joezen777/physicssculptures/experiments/roofvent_multiplier/output/gear_detail.png

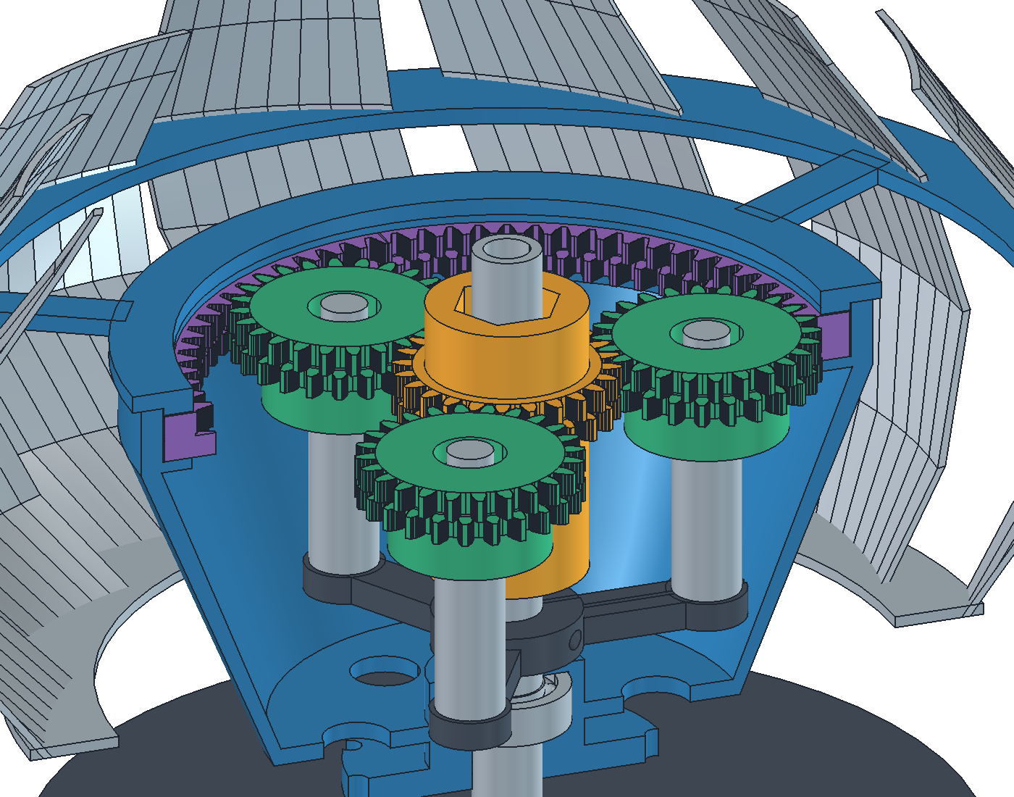
experiments/roofvent_multiplier/output/gear_detail.png
