joezen777/physicssculptures/experiments/drop_gearbox/magnetic_output/annotated_overview.png

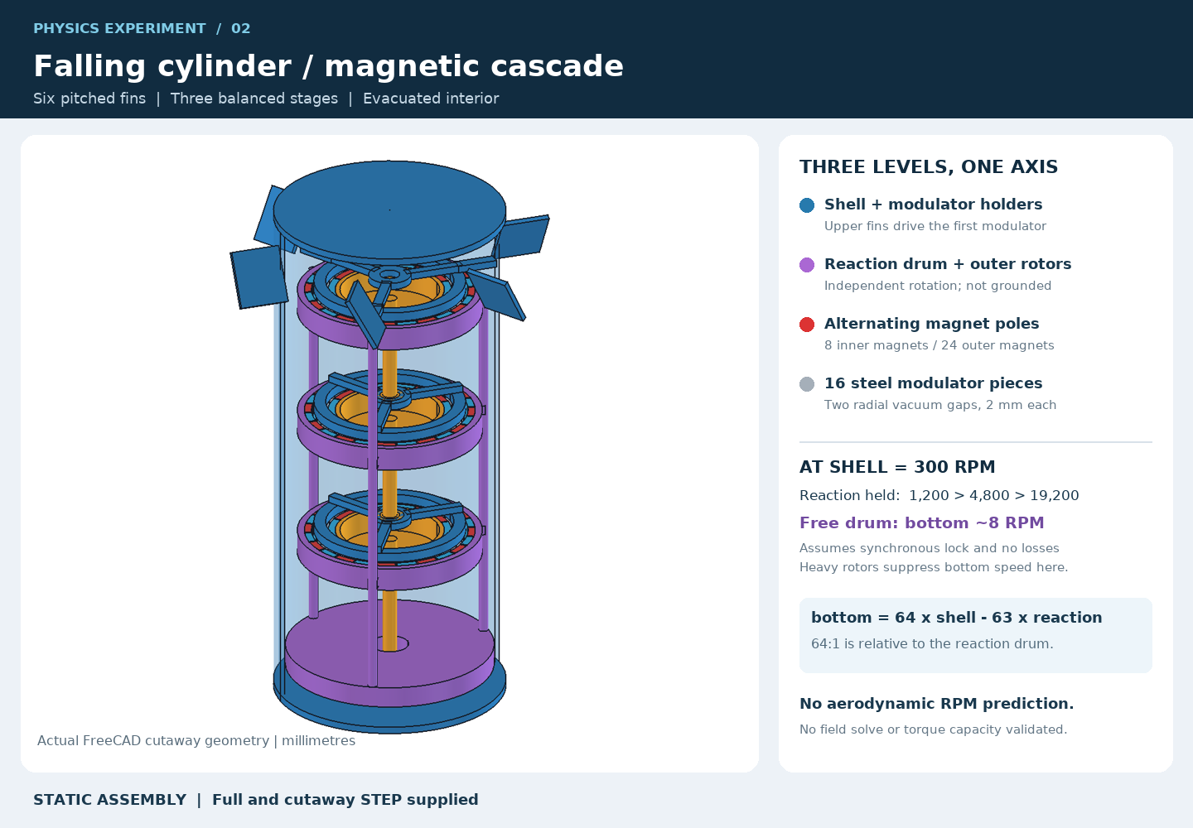
experiments/drop_gearbox/magnetic_output/annotated_overview.png
