joezen777/physicssculptures/experiments/drop_gearbox/magnetic_output/overview.png

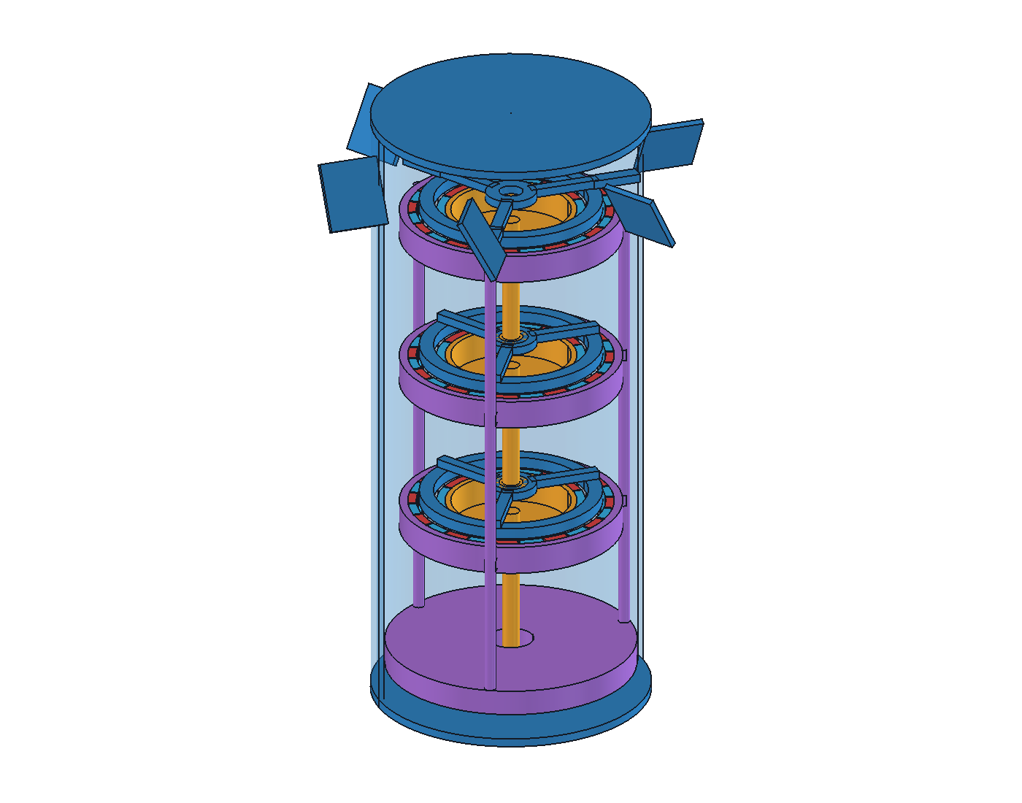
experiments/drop_gearbox/magnetic_output/overview.png
