joezen777/physicssculptures/experiments/print_petg_12/output/stl/resin_hardware_sprues/hardware_sprues_preview.png

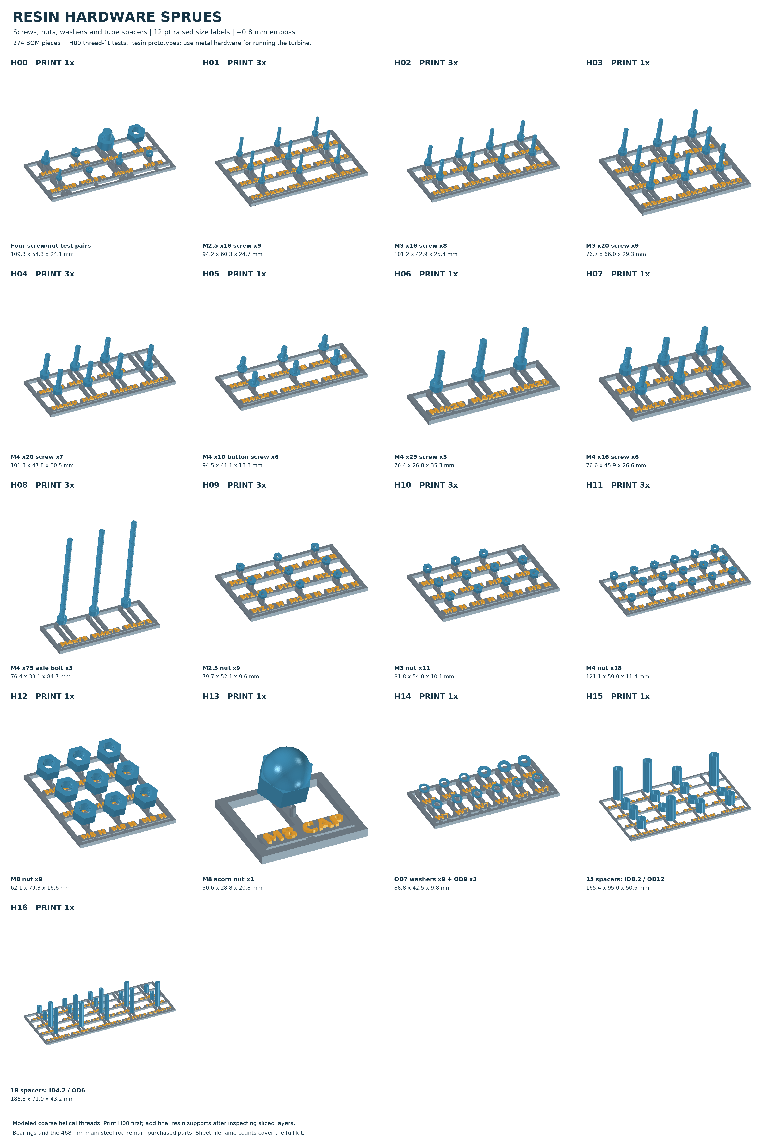
experiments/print_petg_12/output/stl/resin_hardware_sprues/hardware_sprues_preview.png
