joezen777/physicssculptures/experiments/print_petg_12/output/stl/resin_hardware_sprues/spacers_detail.png

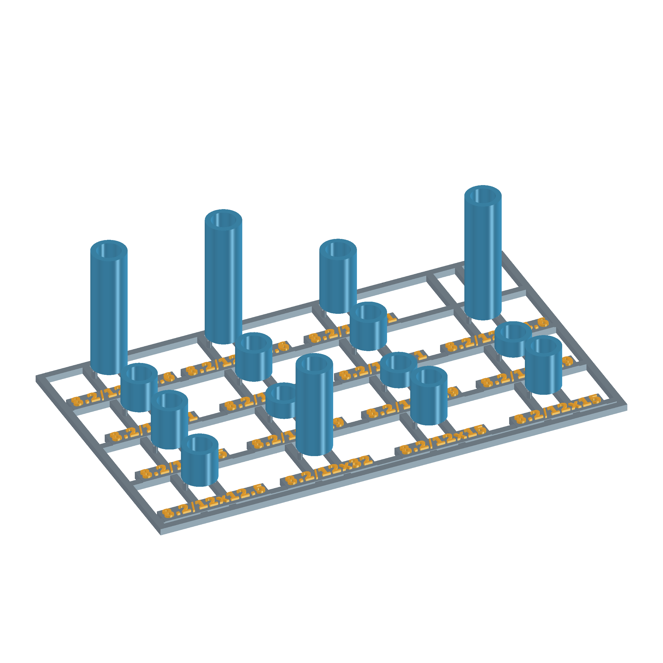
experiments/print_petg_12/output/stl/resin_hardware_sprues/spacers_detail.png
