joezen777/physicssculptures/experiments/resin_hardware_sprues/previews/H00.png

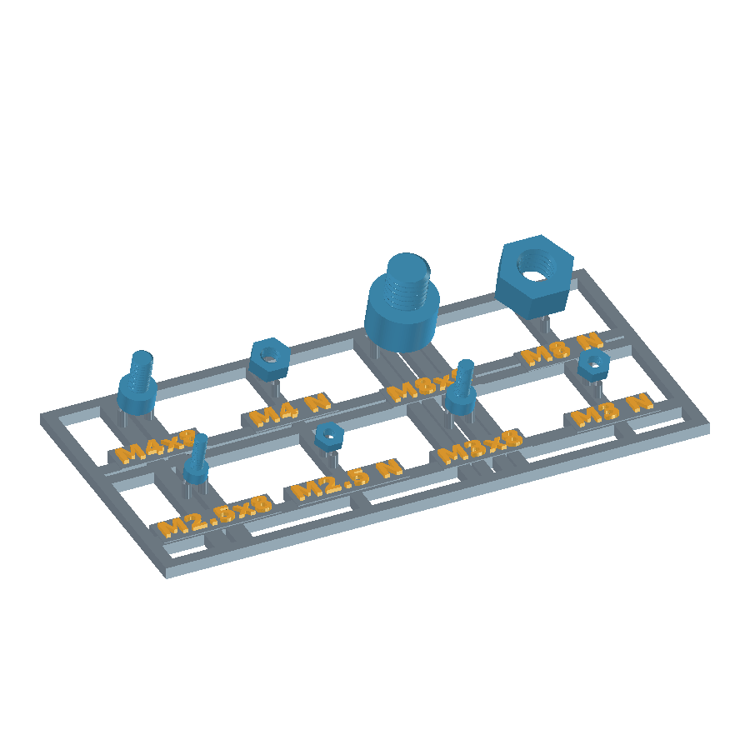
experiments/resin_hardware_sprues/previews/H00.png
