joezen777/physicssculptures/experiments/resin_hardware_sprues/previews/H03.png

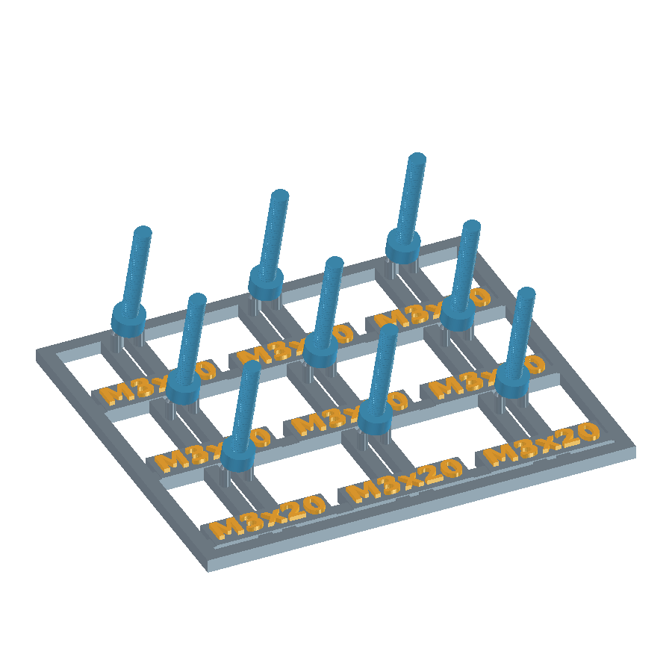
experiments/resin_hardware_sprues/previews/H03.png
