joezen777/physicssculptures/experiments/resin_hardware_sprues/previews/H04.png

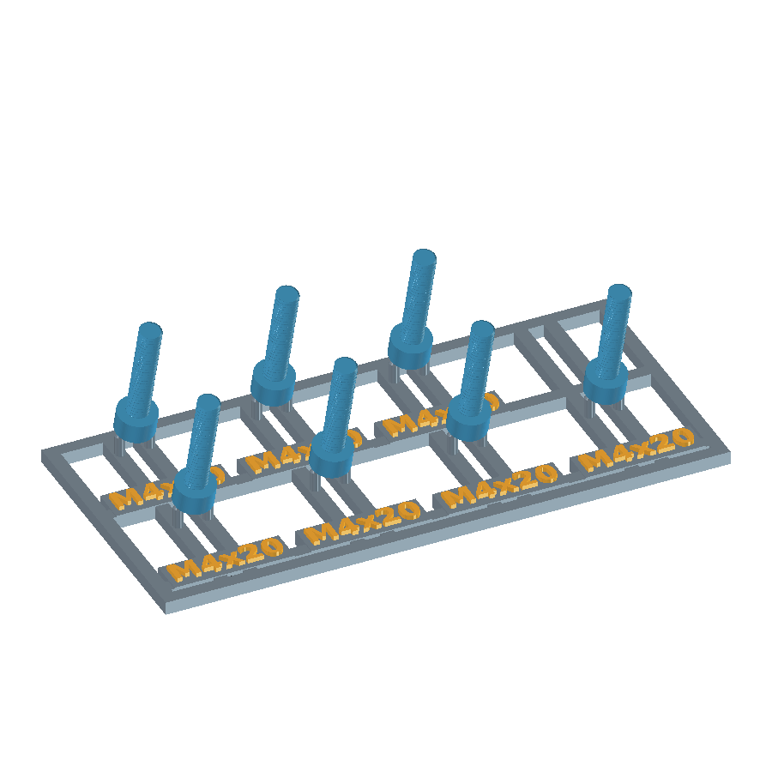
experiments/resin_hardware_sprues/previews/H04.png
