joezen777/physicssculptures/experiments/resin_hardware_sprues/previews/H05.png

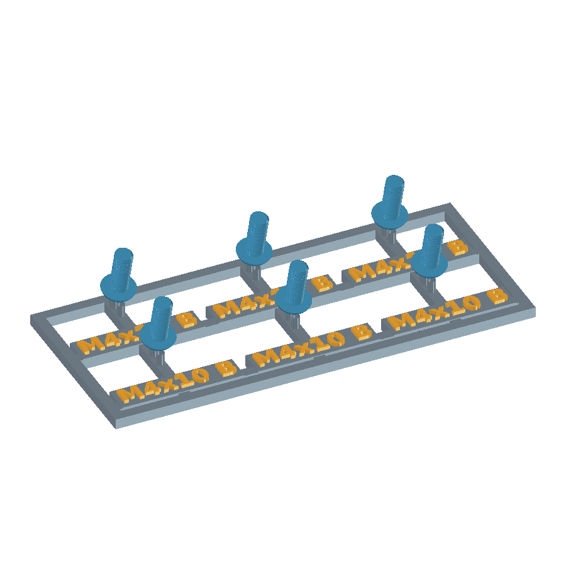
experiments/resin_hardware_sprues/previews/H05.png
