joezen777/physicssculptures/experiments/resin_hardware_sprues/previews/H06.png

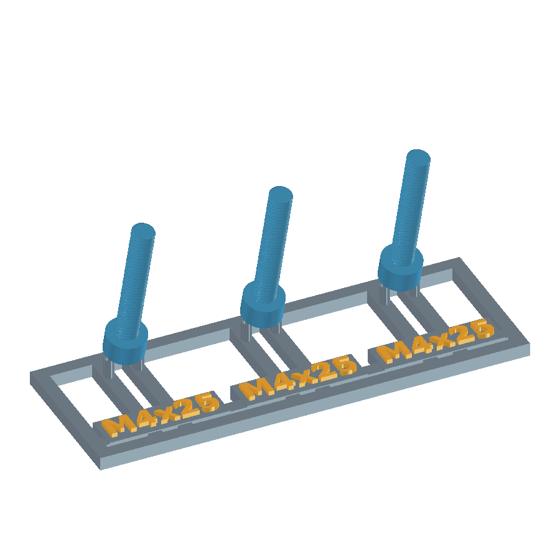
experiments/resin_hardware_sprues/previews/H06.png
