joezen777/physicssculptures/experiments/resin_hardware_sprues/previews/H07.png

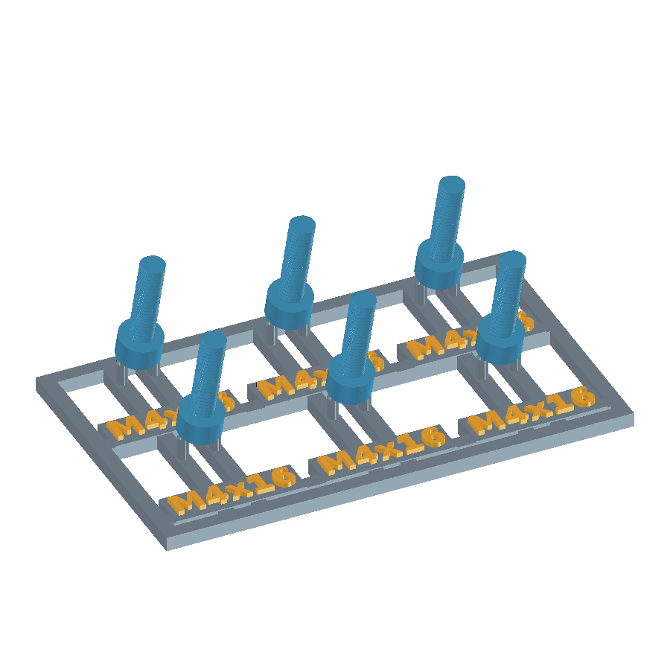
experiments/resin_hardware_sprues/previews/H07.png
