joezen777/physicssculptures/experiments/resin_hardware_sprues/previews/H08.png

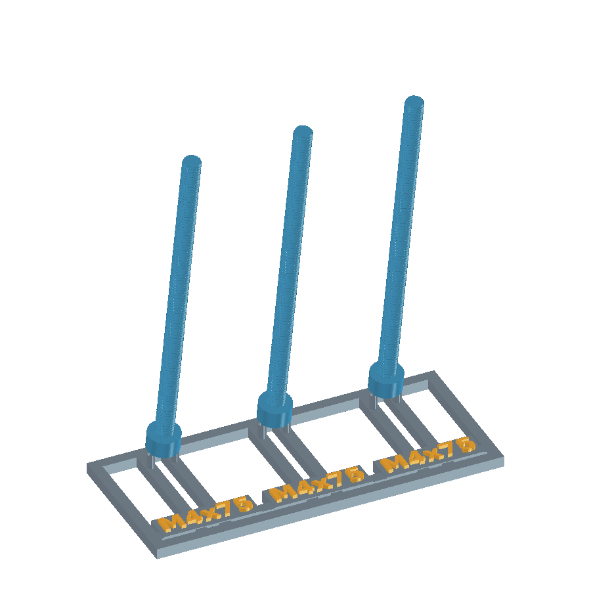
experiments/resin_hardware_sprues/previews/H08.png
