joezen777/physicssculptures/experiments/resin_hardware_sprues/previews/H09.png

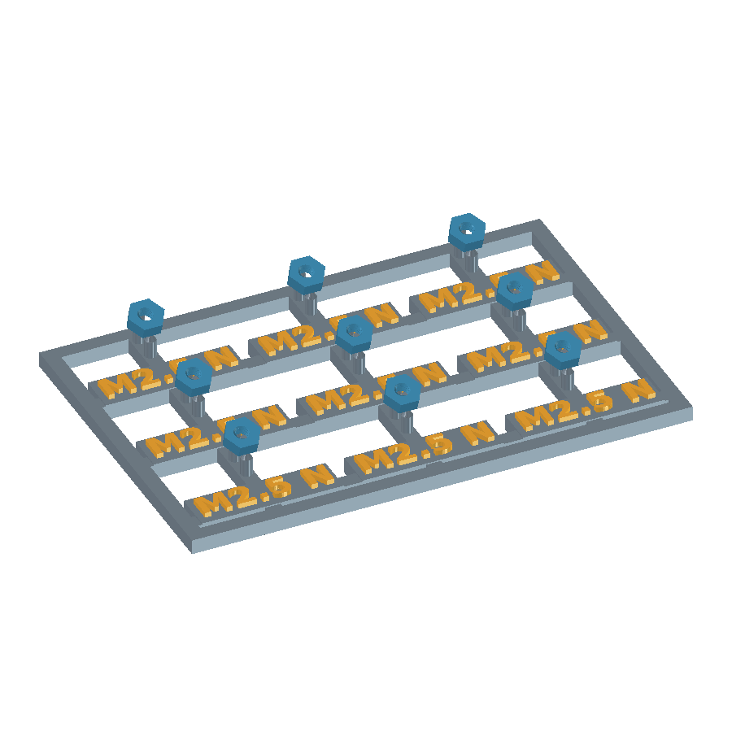
experiments/resin_hardware_sprues/previews/H09.png
