joezen777/physicssculptures/experiments/resin_hardware_sprues/previews/H10.png

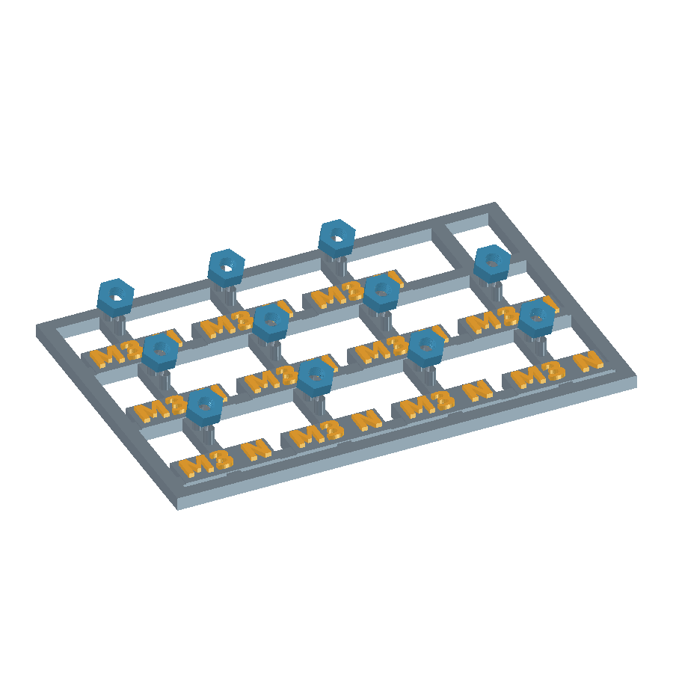
experiments/resin_hardware_sprues/previews/H10.png
