joezen777/physicssculptures/experiments/resin_hardware_sprues/previews/H11.png

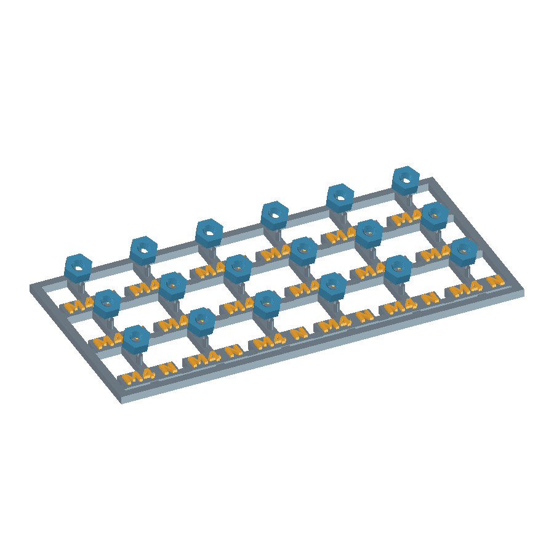
experiments/resin_hardware_sprues/previews/H11.png
