joezen777/physicssculptures/experiments/resin_hardware_sprues/previews/H12.png

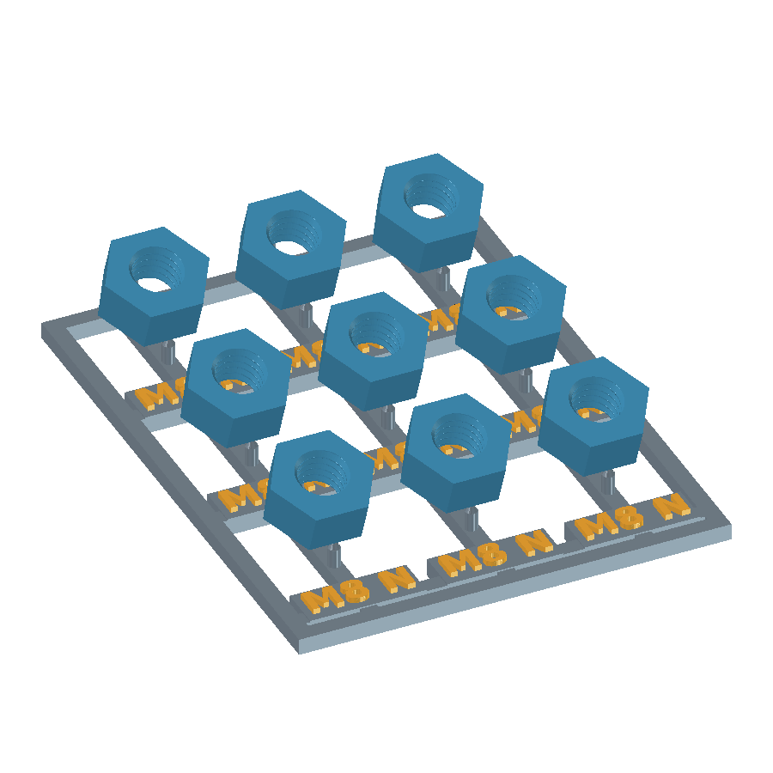
experiments/resin_hardware_sprues/previews/H12.png
