joezen777/physicssculptures/experiments/resin_hardware_sprues/previews/H13.png

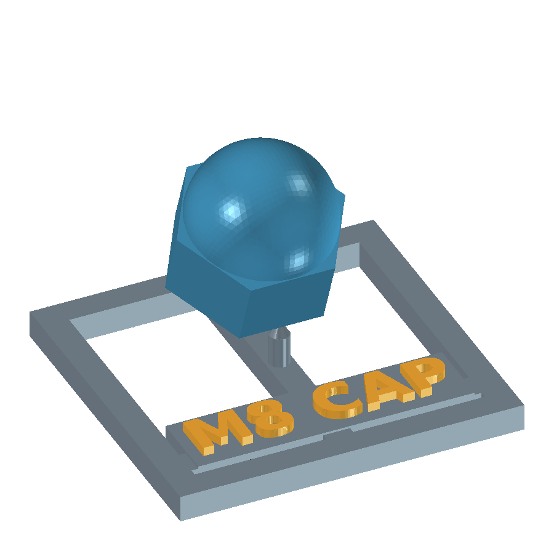
experiments/resin_hardware_sprues/previews/H13.png
