joezen777/physicssculptures/experiments/resin_hardware_sprues/previews/H14.png

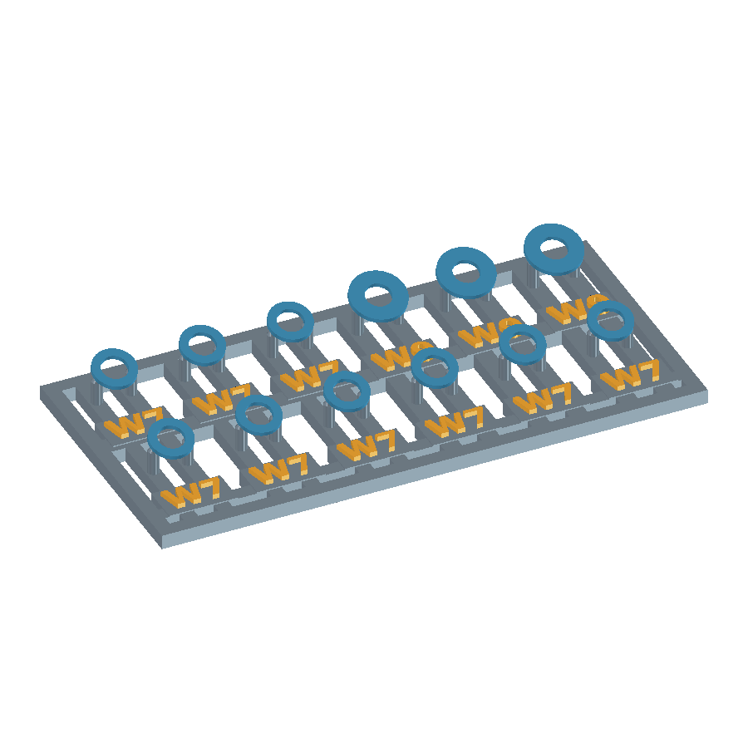
experiments/resin_hardware_sprues/previews/H14.png
