joezen777/physicssculptures/experiments/resin_hardware_sprues/previews/H16.png

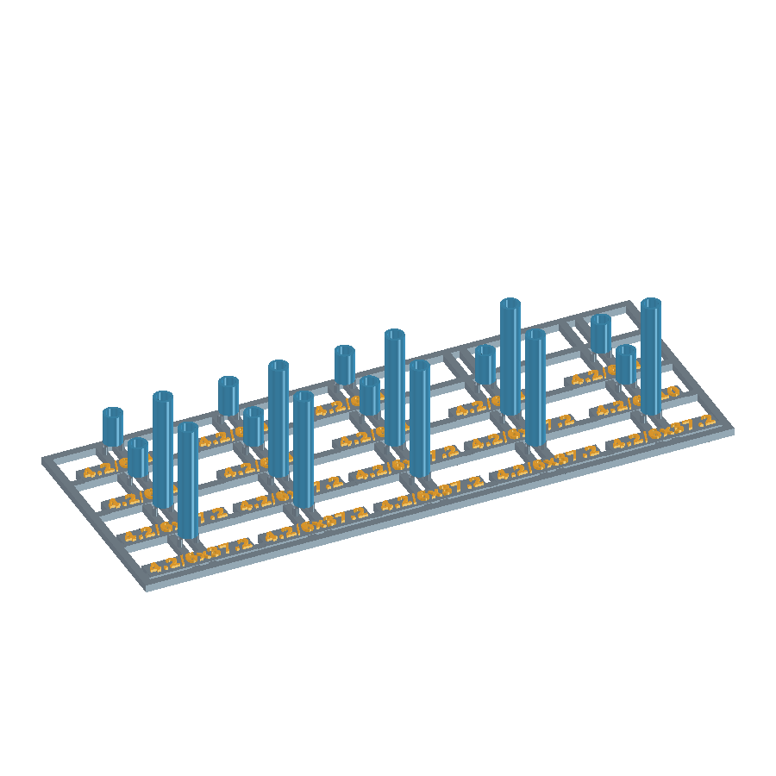
experiments/resin_hardware_sprues/previews/H16.png
