joezen777/physicssculptures/experiments/roofvent_multiplier/output/tower_overview.png

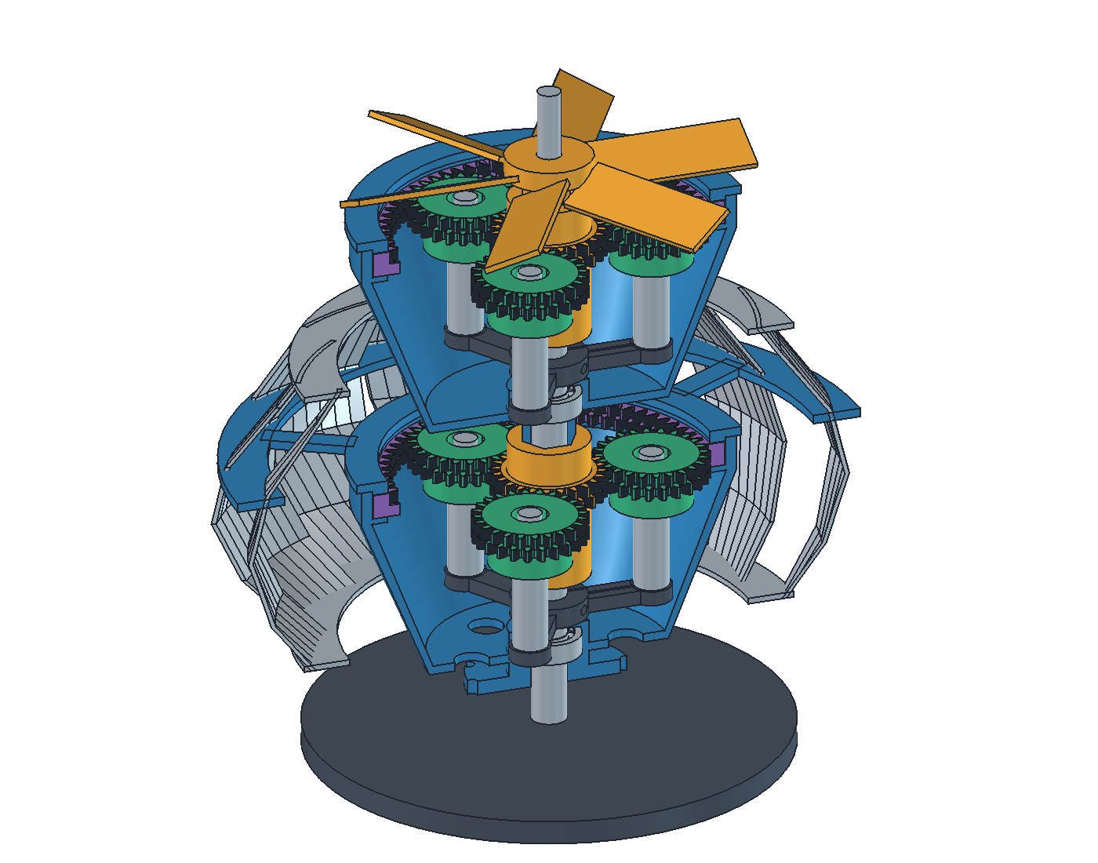
experiments/roofvent_multiplier/output/tower_overview.png
