joezen777/physicssculptures/experiments/print_petg_12/output/hardware_bom.csv

item | specification | quantity
608 bearing | 8 x 22 x 7 mm | 11
604 bearing | 4 x 12 x 4 mm | 9
M8 threaded rod | Steel; 500 mm end to end; deburr ends | 1
M8 hex nut | 13 mm AF | 9
M8 acorn nut | Check internal depth against 8 mm exposed thread | 1
M4 axle bolt | M4 x75 | 9
M3 socket-head screw | M3 x16; 608 retainers | 24
M3 socket-head screw | M3 x20; recessed sun-housing joins | 9
M3 hex nut | 5.5 mm AF | 33
M2.5 screw | M2.5 x16; 604 retainers | 27
M2.5 hex nut | 5 mm AF | 27
M4 socket-head bolt | M4 x20; ring/collar and sail hub | 21
M4 button-head screw | M4 x10; recessed arm roots; head height <=2.2 mm | 6
M4 socket-head bolt | M4 x25; cups | 3
M4 socket-head bolt | M4 x16; guard | 6
M4 hex nut | 7 mm AF; total including 18 axle nuts | 54
M4 washer | 4.2 mm ID / 7 mm OD / 0.8 mm thick; planet upper stacks | 9
M4 washer | Approx. 9 mm OD; inside cups | 3
Steel tube spacer | ID8.2 / OD12 / L12.5 mm | 1
Steel tube spacer | ID8.2 / OD12 / L32 mm | 1
Steel tube spacer | ID8.2 / OD12 / L15 mm | 3
Steel tube spacer | ID8.2 / OD12 / L5.9 mm | 3
Steel tube spacer | ID8.2 / OD12 / L11 mm | 3
Steel tube spacer | ID8.2 / OD12 / L44.6 mm | 3
Steel tube spacer | ID8.2 / OD12 / L53 mm | 1
Steel tube spacer | ID4.2 / OD6 / L37.2 mm | 9
Steel tube spacer | ID4.2 / OD6 / L10 mm | 9
