joezen777/physicssculptures/experiments/bevel_cones/output/bevel_cones_full.step

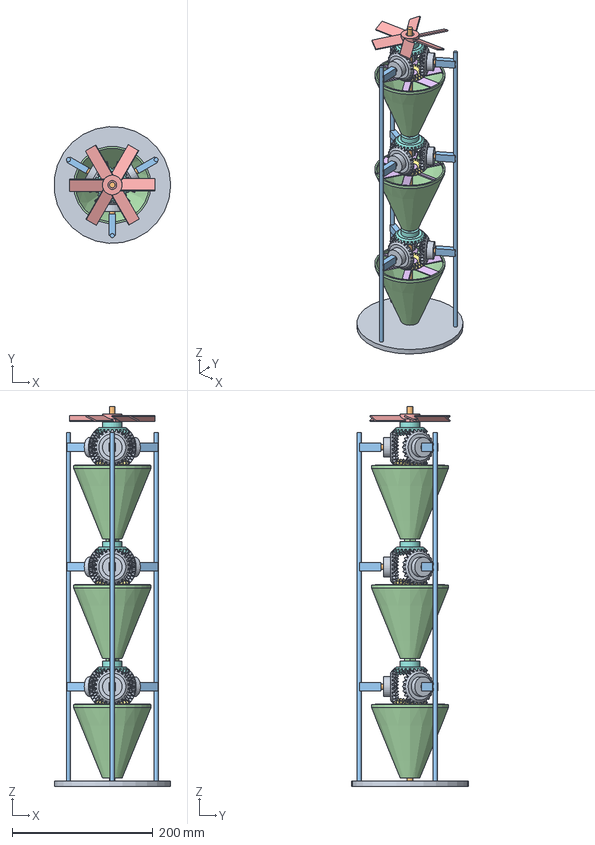
[picture p22: CAD file, 2026-09-28]
experiments/bevel_cones/output/bevel_cones_full.step
165.4 x 165.7 x 540.0 mm
Base
Central_8mm_rod
Frame_post_0
Frame_post_1
Frame_post_2
L0_pointed_cone
L0_tip_608
L0_fan_blade_insert
L0_lower_bevel
L0_upper_bevel_hex
L0_upper_608
L0_radial_pinion_0
L0_pinion_608_0
L0_radial_axle_0
L0_carrier_arm_0
L0_radial_pinion_1
L0_pinion_608_1
L0_radial_axle_1
L0_carrier_arm_1
L0_radial_pinion_2
L0_pinion_608_2
L0_radial_axle_2
L0_carrier_arm_2
L1_pointed_cone
L1_tip_608
L1_fan_blade_insert
L1_lower_bevel
L1_upper_bevel_hex
L1_upper_608
L1_radial_pinion_0
L1_pinion_608_0
L1_radial_axle_0
L1_carrier_arm_0
L1_radial_pinion_1
L1_pinion_608_1
L1_radial_axle_1
L1_carrier_arm_1
L1_radial_pinion_2
L1_pinion_608_2
L1_radial_axle_2
L1_carrier_arm_2
L2_pointed_cone
L2_tip_608
L2_fan_blade_insert
L2_lower_bevel
L2_upper_bevel_hex
L2_upper_608
L2_radial_pinion_0
L2_pinion_608_0
L2_radial_axle_0
L2_carrier_arm_0
L2_radial_pinion_1
L2_pinion_608_1
L2_radial_axle_1
L2_carrier_arm_1
L2_radial_pinion_2
L2_pinion_608_2
L2_radial_axle_2
L2_carrier_arm_2
Fan
