joezen777/physicssculptures/experiments/print_petg_12/output/arm_joint_variants/side_access_assembly.FCStd

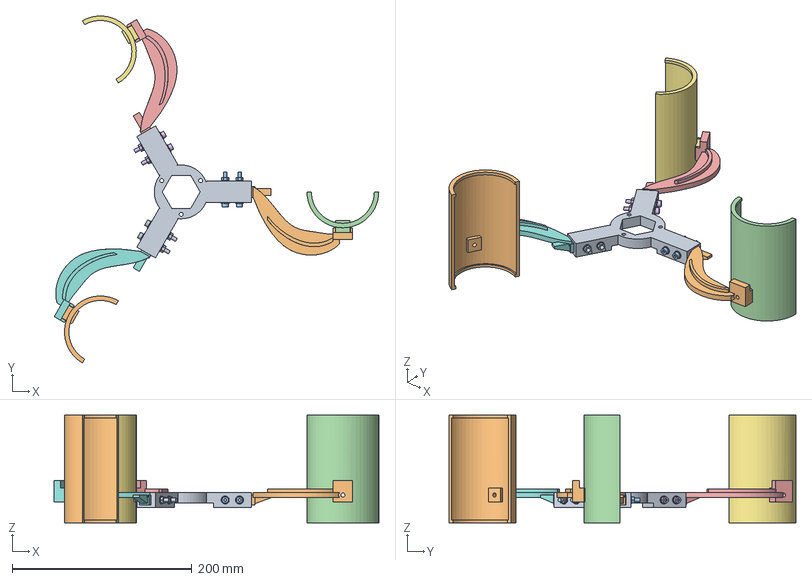
[picture p23: CAD file, 2026-10-19]
experiments/print_petg_12/output/arm_joint_variants/side_access_assembly.FCStd
361.4 x 386.4 x 120.0 mm
Hub
Arm0
Steel0
Scoop0
Arm120
Steel120
Scoop120
Arm240
Steel240
Scoop240
