joezen777/physicssculptures/experiments/print_petg_12/output/sail_80x120/assembly_with_sails.FCStd

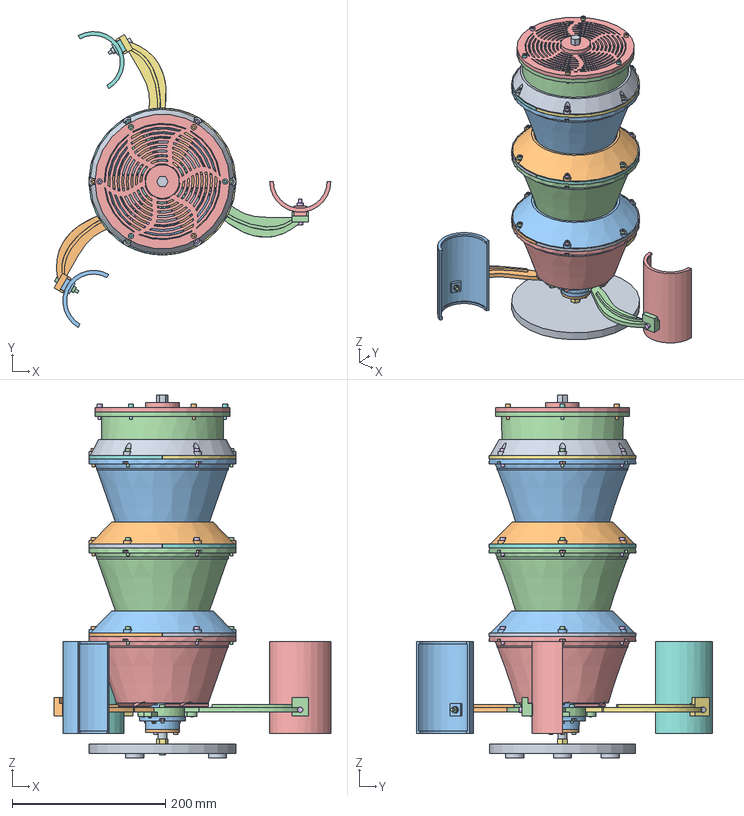
[picture p24: CAD file, 2026-10-11]
experiments/print_petg_12/output/sail_80x120/assembly_with_sails.FCStd
361.4 x 386.4 x 474.0 mm
P12 stationary_base
P01 608_retainer
P13 base_drive_adapter
P14 sail_hex_hub
P02 pot_fan_A
P01 608_retainer001
P04 fixed_curved_carrier
P01 608_retainer002
P05 sun_lower_bearing_housing
P06 sun_36T_socket
P07 planet_18T_604
P08 604_retainer
P07 planet_18T_605
P08 604_retainer001
P07 planet_18T_606
P08 604_retainer002
P09 72T_ring_half
P09 72T_ring_half001
P10 interstage_air_collar
P03 pot_fan_B
P01 608_retainer003
P04 fixed_curved_carrier001
P01 608_retainer004
P05 sun_lower_bearing_housing001
P06 sun_36T_socket001
P07 planet_18T_607
P08 604_retainer003
P07 planet_18T_608
P08 604_retainer004
P07 planet_18T_609
P08 604_retainer005
P09 72T_ring_half002
P09 72T_ring_half003
P10 interstage_air_collar001
P02 pot_fan_A001
P01 608_retainer005
P04 fixed_curved_carrier002
P01 608_retainer006
P05 sun_lower_bearing_housing002
P06 sun_36T_socket002
P07 planet_18T_610
P08 604_retainer006
P07 planet_18T_611
P08 604_retainer007
P07 planet_18T_612
P08 604_retainer008
P09 72T_ring_half004
P09 72T_ring_half005
P11 terminal_air_collar
P17 top_fan_B
P01 608_retainer007
P18 top_guard_shroud
P19 curved_guard_grille
M8 steel hex nut
M8 steel hex nut001
M8 threaded steel rod, cut 468 mm
Steel tube ID8.2 OD12 L12.5
608 purchased bearing
Steel tube ID8.2 OD12 L32
608 purchased bearing001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
