joezen777/physicssculptures/experiments/drop_gearbox/output/drop_gearbox_full.step

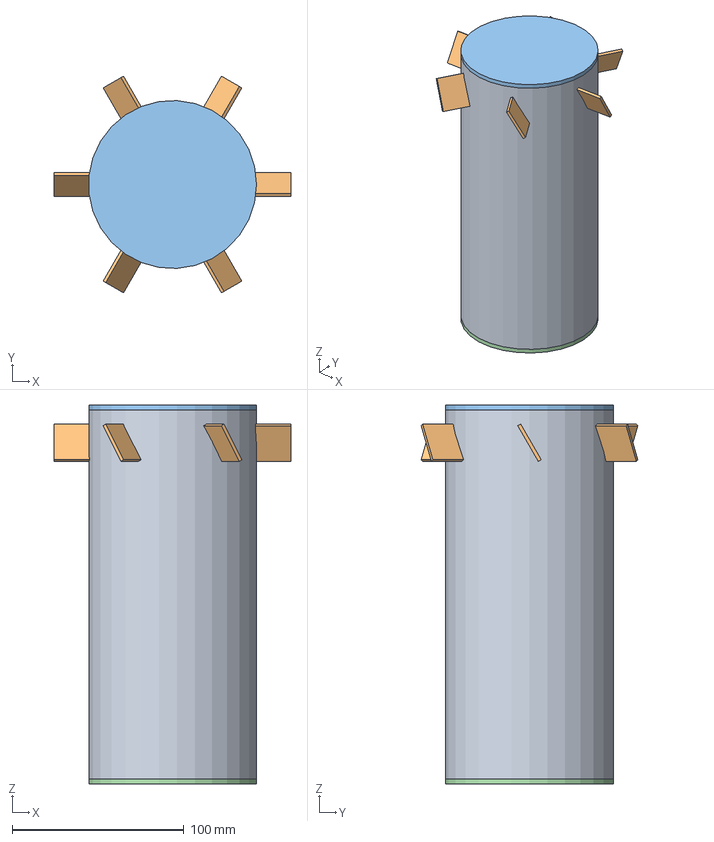
[picture p26: CAD file, 2026-09-26]
experiments/drop_gearbox/output/drop_gearbox_full.step
138.0 x 126.4 x 221.0 mm
Blue rotating shell FULL
Upper pitched fin 1
Upper pitched fin 2
Upper pitched fin 3
Upper pitched fin 4
Upper pitched fin 5
Upper pitched fin 6
Shell top cap
Shell bottom cap
Reaction flywheel
Reaction spine 1
Reaction spine 2
Reaction spine 3
Input carrier lug 0
Input carrier lug 1
Input carrier lug 2
Stage 1 ring 72T
Stage 1 ring lug 0
Stage 1 ring lug 1
Stage 1 ring lug 2
Stage 1 input carrier
Stage 1 sun 24T output
Stage 1 planet 1 24T
Stage 1 planet 2 24T
Stage 1 planet 3 24T
Stage 1 output shaft
Stage 1 coupling to next carrier
Stage 2 ring 72T
Stage 2 ring lug 0
Stage 2 ring lug 1
Stage 2 ring lug 2
Stage 2 input carrier
Stage 2 sun 24T output
Stage 2 planet 1 24T
Stage 2 planet 2 24T
Stage 2 planet 3 24T
Stage 2 output shaft
Stage 2 coupling to next carrier
Stage 3 ring 72T
Stage 3 ring lug 0
Stage 3 ring lug 1
Stage 3 ring lug 2
Stage 3 input carrier
Stage 3 sun 24T output
Stage 3 planet 1 24T
Stage 3 planet 2 24T
Stage 3 planet 3 24T
Stage 3 output shaft
Reaction journal 4
Reaction journal 20
