joezen777/physicssculptures/experiments/print_petg_12/output/exploded_assembly.FCStd

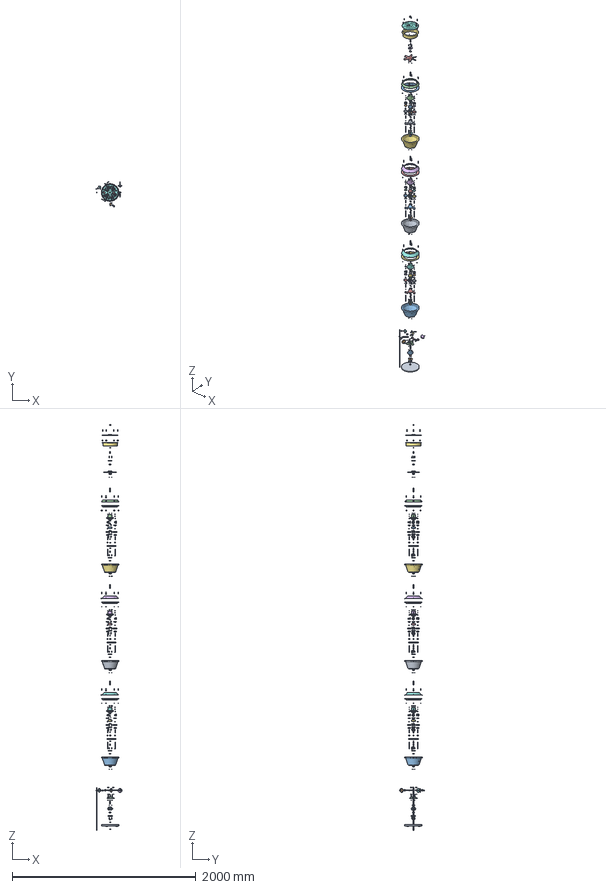
[picture p27: CAD file, 2026-10-12]
experiments/print_petg_12/output/exploded_assembly.FCStd
283.7 x 274.6 x 4419.0 mm
P12 stationary_base
P01 608_retainer
P13 base_drive_adapter
P14 sail_hex_hub
P15 curved_sail_arm
P16 wind_cup
P15 curved_sail_arm001
P16 wind_cup001
P15 curved_sail_arm002
P16 wind_cup002
P02 pot_fan_A
P01 608_retainer001
P04 fixed_curved_carrier
P01 608_retainer002
P05 sun_lower_bearing_housing
P06 sun_36T_helical_socket
P07 planet_18T_helical_604
P08 604_retainer
P07 planet_18T_helical_605
P08 604_retainer001
P07 planet_18T_helical_606
P08 604_retainer002
P09 72T_helical_ring
P10 interstage_air_collar
P03 pot_fan_B
P01 608_retainer003
P04 fixed_curved_carrier001
P01 608_retainer004
P05 sun_lower_bearing_housing001
P06 sun_36T_helical_socket001
P07 planet_18T_helical_607
P08 604_retainer003
P07 planet_18T_helical_608
P08 604_retainer004
P07 planet_18T_helical_609
P08 604_retainer005
P09 72T_helical_ring001
P10 interstage_air_collar001
P02 pot_fan_A001
P01 608_retainer005
P04 fixed_curved_carrier002
P01 608_retainer006
P05 sun_lower_bearing_housing002
P06 sun_36T_helical_socket002
P07 planet_18T_helical_610
P08 604_retainer006
P07 planet_18T_helical_611
P08 604_retainer007
P07 planet_18T_helical_612
P08 604_retainer008
P09 72T_helical_ring002
P11 terminal_air_collar
P17 top_fan_B
P01 608_retainer007
P18 top_guard_shroud
P19 curved_guard_grille
M8 steel hex nut
M8 steel hex nut001
M8 threaded steel rod, cut 468 mm
Steel tube ID8.2 OD12 L12.5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
