joezen777/physicssculptures/experiments/print_petg_12/output/arm_joint_variants/temporary_assembly.FCStd

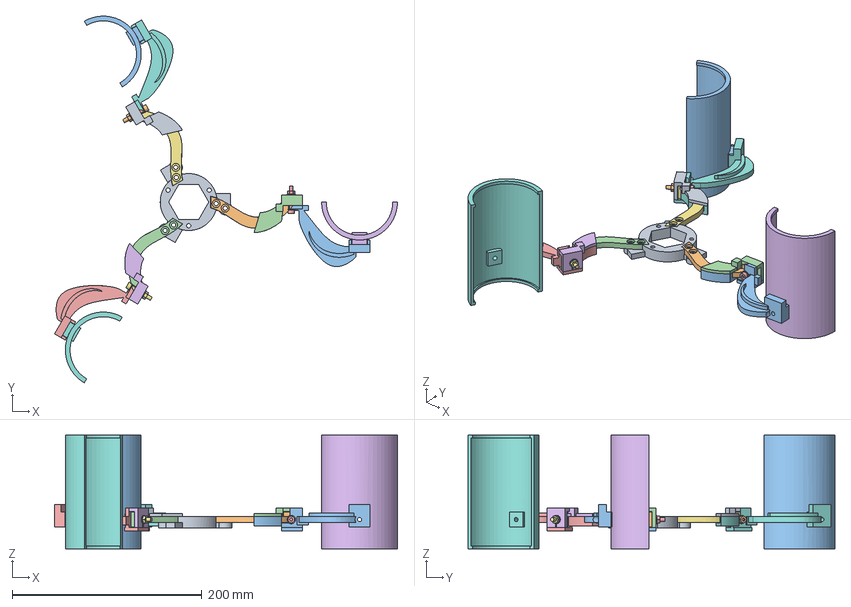
[picture p29: CAD file, 2026-10-19]
experiments/print_petg_12/output/arm_joint_variants/temporary_assembly.FCStd
361.4 x 386.4 x 120.0 mm
Hub
OriginalArm0
Extension0
Cap0
Steel0
Scoop0
OriginalArm120
Extension120
Cap120
Steel120
Scoop120
OriginalArm240
Extension240
Cap240
Steel240
Scoop240
