joezen777/physicssculptures/experiments/cfd400/geometry/original.stl

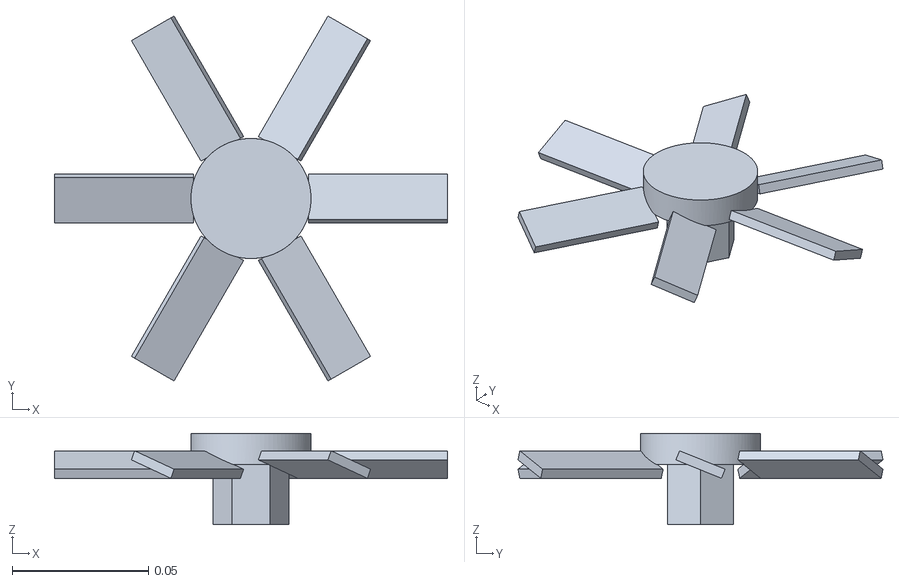
[picture p30: CAD file, 2026-10-19]
experiments/cfd400/geometry/original.stl
0.144 x 0.134 x 0.0334
