joezen777/physicssculptures/experiments/drop_gearbox/magnetic_output/magnetic.FCStd

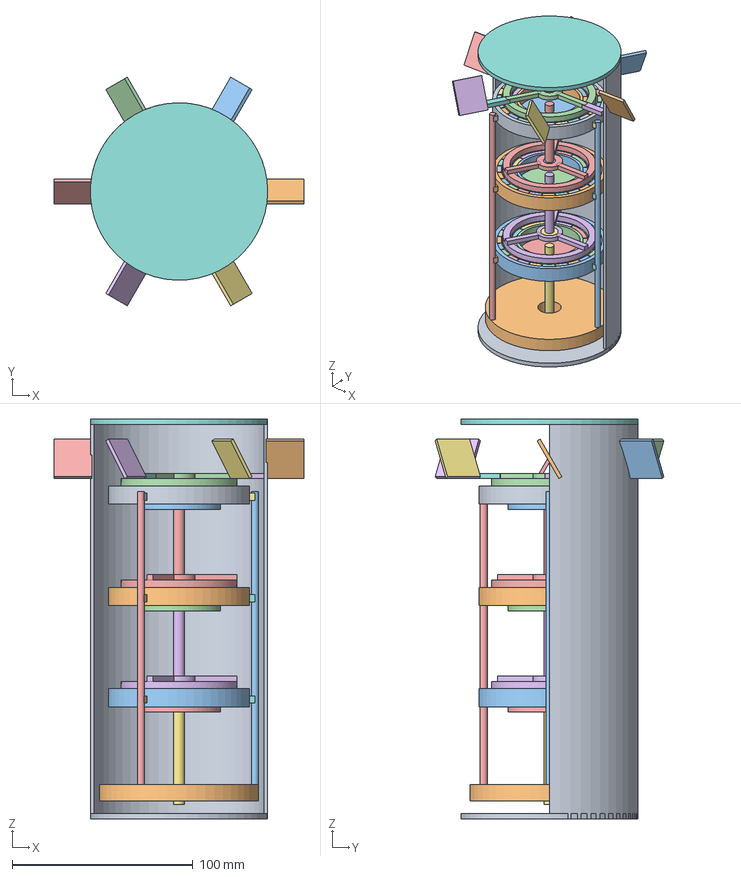
[picture p31: CAD file, 2026-09-26]
experiments/drop_gearbox/magnetic_output/magnetic.FCStd
138.0 x 126.4 x 221.0 mm
Shell front half removed for inspection
Upper pitched fin 1
Upper pitched fin 2
Upper pitched fin 3
Upper pitched fin 4
Upper pitched fin 5
Upper pitched fin 6
Shell top cap
Shell bottom cap
Reaction flywheel
Reaction spine 1
Reaction spine 2
Reaction spine 3
Input carrier lug 0
Input carrier lug 1
Input carrier lug 2
M1 outer backiron
M1 outer pole 01
M1 outer pole 02
M1 outer pole 03
M1 outer pole 04
M1 outer pole 05
M1 outer pole 06
M1 outer pole 07
M1 outer pole 08
M1 outer pole 09
M1 outer pole 10
M1 outer pole 11
M1 outer pole 12
M1 outer pole 13
M1 outer pole 14
M1 outer pole 15
M1 outer pole 16
M1 outer pole 17
M1 outer pole 18
M1 outer pole 19
M1 outer pole 20
M1 outer pole 21
M1 outer pole 22
M1 outer pole 23
M1 outer pole 24
M1 modulator 01
M1 modulator 02
M1 modulator 03
M1 modulator 04
M1 modulator 05
M1 modulator 06
M1 modulator 07
M1 modulator 08
M1 modulator 09
M1 modulator 10
M1 modulator 11
M1 modulator 12
M1 modulator 13
M1 modulator 14
M1 modulator 15
M1 modulator 16
M1 inner pole 01
M1 inner pole 02
M1 inner pole 03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
