joezen777/physicssculptures/experiments/pot_zoetrope/output/engraved_pots_detail.FCStd

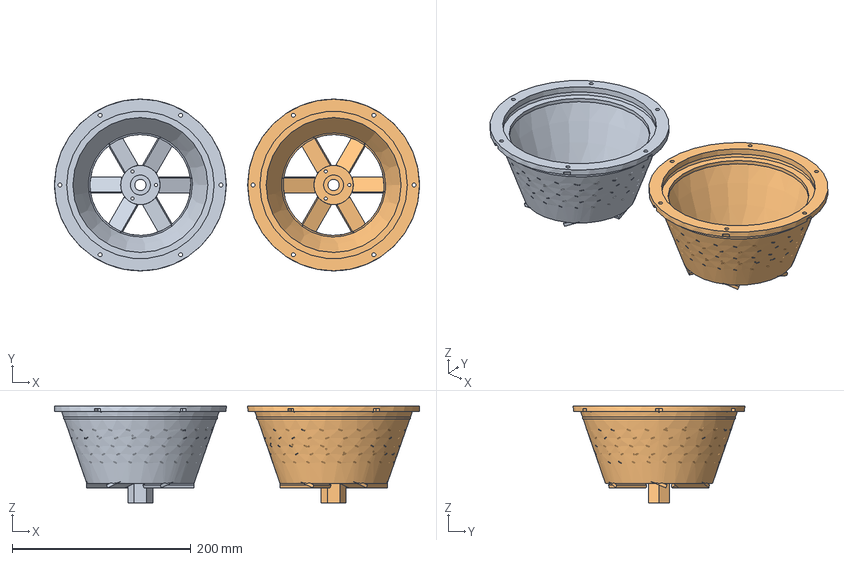
[picture p33: CAD file, 2026-10-03]
experiments/pot_zoetrope/output/engraved_pots_detail.FCStd
408.0 x 192.0 x 108.4 mm
P02 recessed CCW
P03 recessed CW
