joezen777/physicssculptures/experiments/print_petg_12/output/p19_rain/P19_rain.step

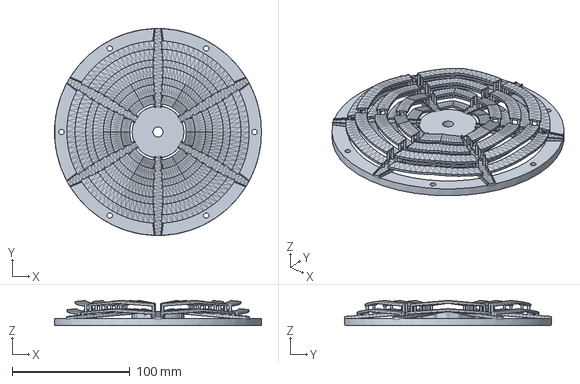
[picture p34: CAD file, 2026-10-19]
experiments/print_petg_12/output/p19_rain/P19_rain.step
176.0 x 176.0 x 21.4 mm
