joezen777/physicssculptures/experiments/print_petg_12/output/scimitar_40mm/P18S.step

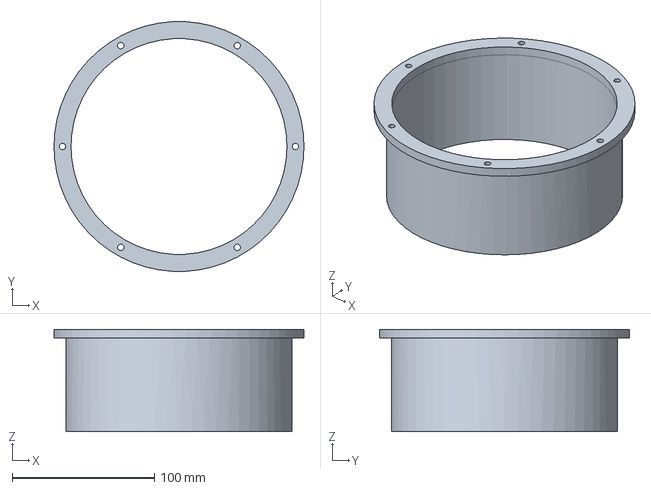
[picture p35: CAD file, 2026-10-19]
experiments/print_petg_12/output/scimitar_40mm/P18S.step
176.0 x 175.7 x 72.0 mm
