joezen777/physicssculptures/experiments/resin_hardware_sprues/hardware_sprues.FCStd

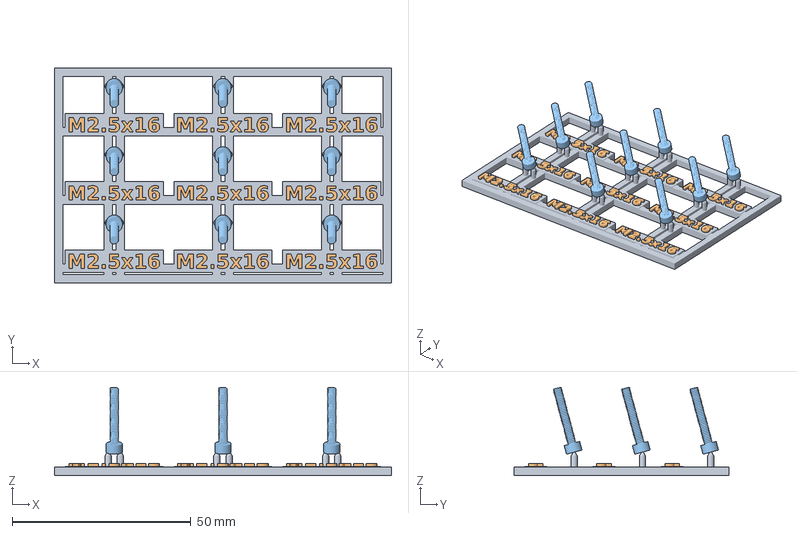
[picture p37: CAD file, 2026-10-03]
experiments/resin_hardware_sprues/hardware_sprues.FCStd
94.2 x 60.3 x 24.7 mm
H01 frame | print 3x
H01 labels | print 3x
H01 parts | print 3x
