joezen777/physicssculptures/experiments/resin_sprues/resin_sprue_sheets.FCStd

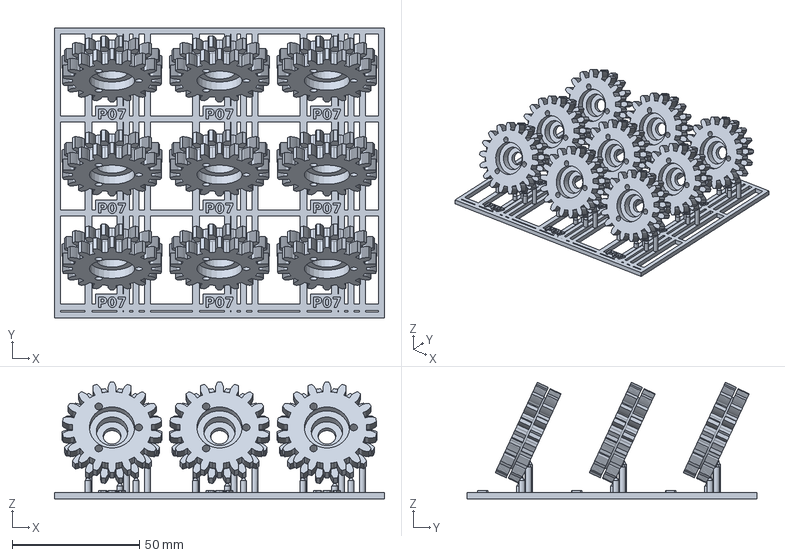
[picture p38: CAD file, 2026-10-03]
experiments/resin_sprues/resin_sprue_sheets.FCStd
129.5 x 113.7 x 45.7 mm
