joezen777/physicssculptures/experiments/cfd400/geometry/toroidal5.FCStd

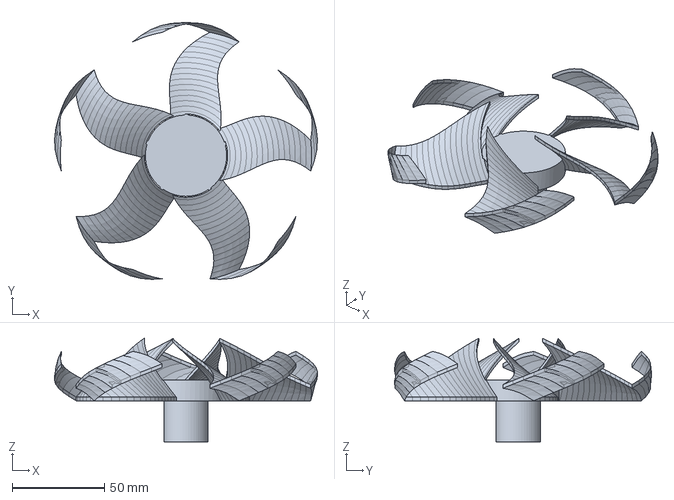
[picture p40: CAD file, 2026-10-19]
experiments/cfd400/geometry/toroidal5.FCStd
142.4 x 139.0 x 56.0 mm
