joezen777/physicssculptures/experiments/modular_fan_tunnel/output/tower_draft.FCStd

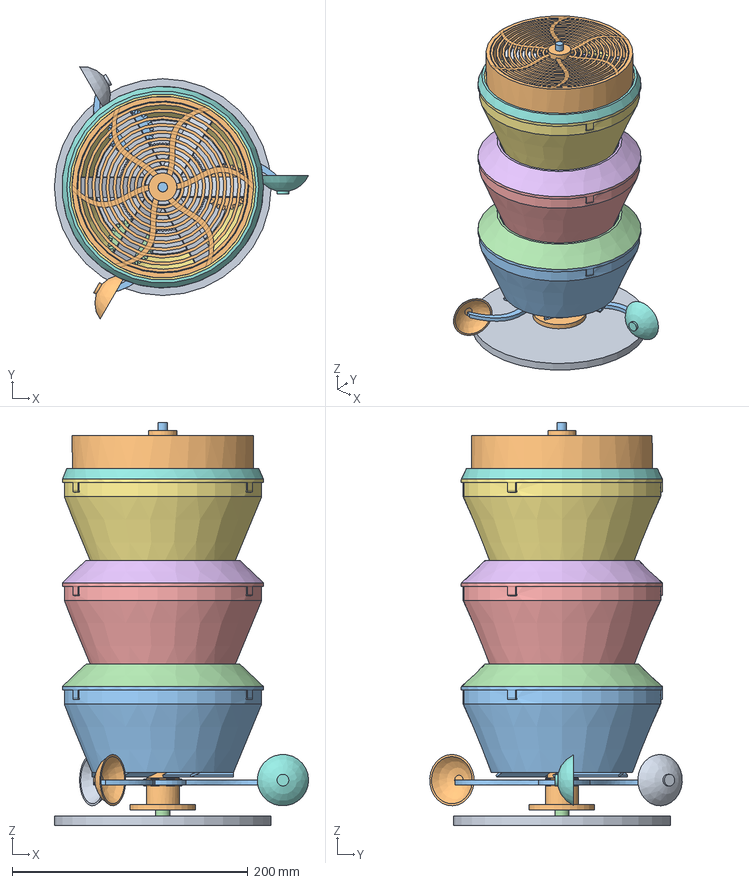
[picture p41: CAD file, 2026-09-29]
experiments/modular_fan_tunnel/output/tower_draft.FCStd
215.8 x 214.3 x 342.0 mm
Stationary base
Universal base drive adapter
L0 cone
L0 fixed carrier
L0 center gear female hex
L0 planet 0
L0 planet 1
L0 planet 2
L0 split ring 0
L0 split ring 1
L0 snap cap
L0 air transition
L1 cone
L1 fixed carrier
L1 center gear female hex
L1 planet 0
L1 planet 1
L1 planet 2
L1 split ring 0
L1 split ring 1
L1 snap cap
L1 air transition
L2 cone
L2 fixed carrier
L2 center gear female hex
L2 planet 0
L2 planet 1
L2 planet 2
L2 split ring 0
L2 split ring 1
L2 snap cap
L2 air transition
Top ring fan
Stationary top ring and spider
Stationary 8mm shaft
Bottom lower inner spacer
Bottom extra 608
Bottom between bearings spacer
L0 cone 608
L0 carrier lower spacer
L0 output lower spacer
L0 output lower 608
L0 output inner race spacer
L0 output upper 608
L0 planet axle 0
L0 planet spacer 0
L0 planet 0 604
L0 planet axle 1
L0 planet spacer 1
L0 planet 1 604
L0 planet axle 2
L0 planet spacer 2
L0 planet 2 604
Between levels spacer 0
L1 cone 608
L1 carrier lower spacer
L1 output lower spacer
L1 output lower 608
L1 output inner race spacer
L1 output upper 608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
