joezen777/physicssculptures/experiments/pot_zoetrope/output/engraved_P02_P03.FCStd

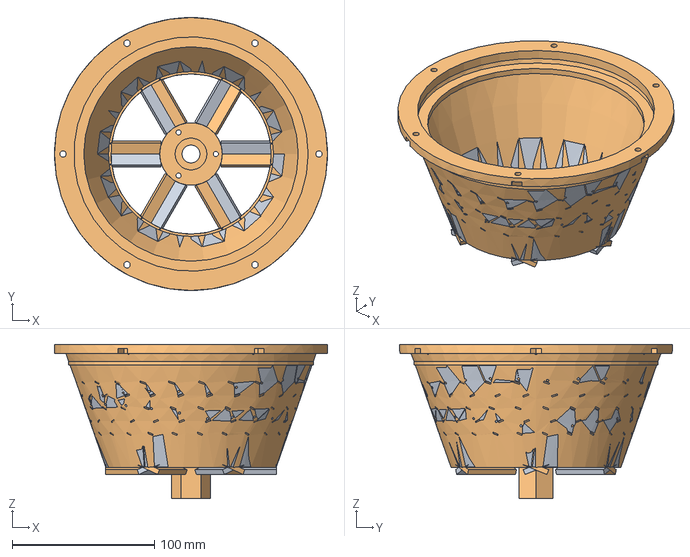
[picture p42: CAD file, 2026-10-03]
experiments/pot_zoetrope/output/engraved_P02_P03.FCStd
192.0 x 192.0 x 108.4 mm
P02 engraved CCW
P03 engraved CW
