joezen777/physicssculptures/experiments/print_petg_12/output/arm_joint_variants/S15_side_access_arm_print-3x.stl

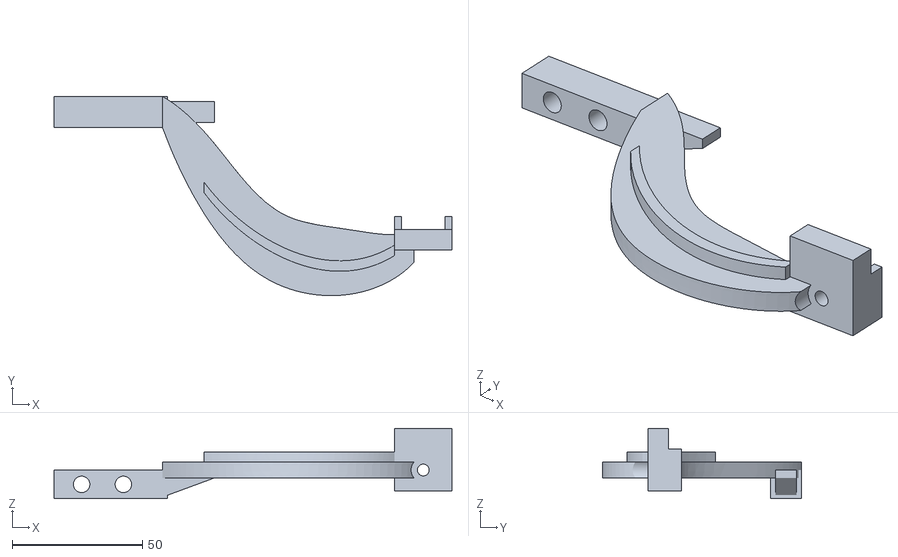
[picture p43: CAD file, 2026-10-19]
experiments/print_petg_12/output/arm_joint_variants/S15_side_access_arm_print-3x.stl
152.6 x 76.4 x 27.0
