joezen777/physicssculptures/experiments/print_petg_12/output/sail_80x120/P15_P16_sail_80x120.FCStd

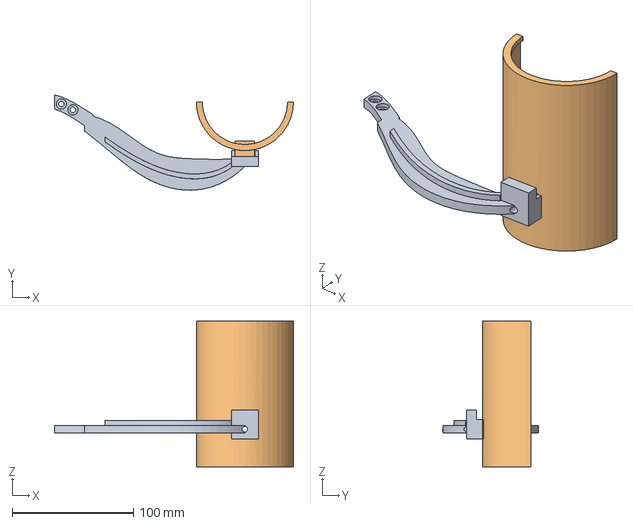
[picture p44: CAD file, 2026-10-11]
experiments/print_petg_12/output/sail_80x120/P15_P16_sail_80x120.FCStd
196.7 x 78.6 x 120.0 mm
P15
P16
