joezen777/physicssculptures/experiments/print_petg_12/output/scimitar_40mm/P17S_print-1x.stl

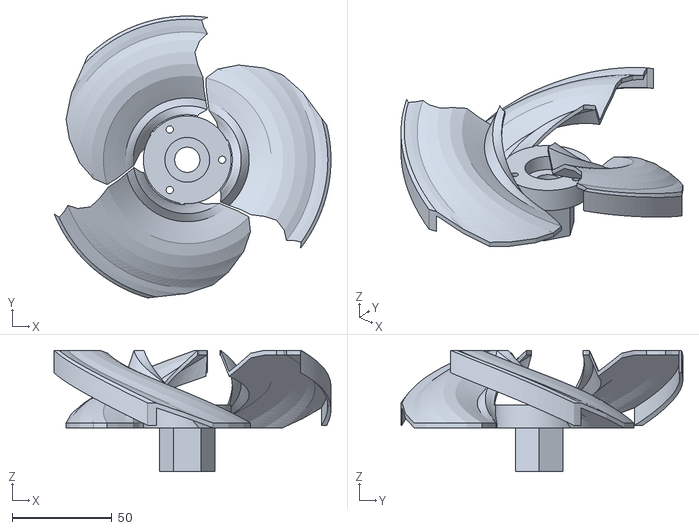
[picture p45: CAD file, 2026-10-19]
experiments/print_petg_12/output/scimitar_40mm/P17S_print-1x.stl
138.8 x 141.2 x 60.8
