joezen777/physicssculptures/experiments/print_petg_12/output/stl/P17_top_fan_B_integrated_supports_print-1x.stl

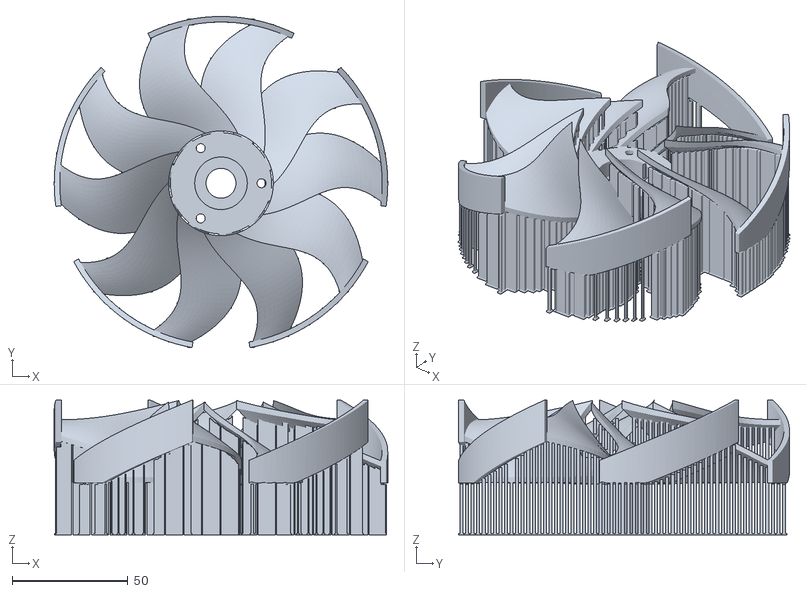
[picture p46: CAD file, 2026-10-19]
experiments/print_petg_12/output/stl/P17_top_fan_B_integrated_supports_print-1x.stl
144.0 x 142.9 x 58.2
