joezen777/physicssculptures/experiments/print_petg_12/output/toroidal5_final/toroidal5_final.FCStd

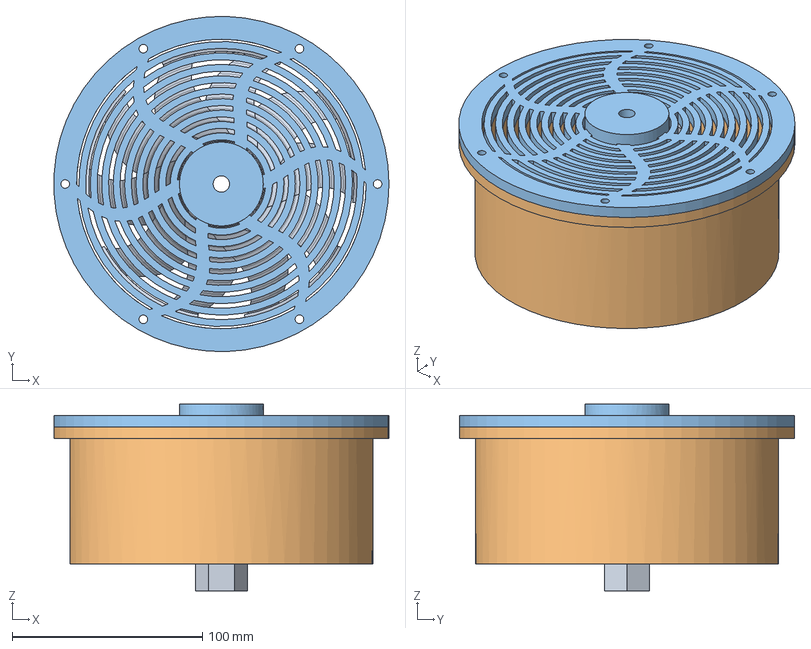
[picture p47: CAD file, 2026-10-19]
experiments/print_petg_12/output/toroidal5_final/toroidal5_final.FCStd
175.9 x 175.9 x 98.0 mm
P17
P18
P19
