joezen777/physicssculptures/experiments/cfd400/geometry/scimitar.stl

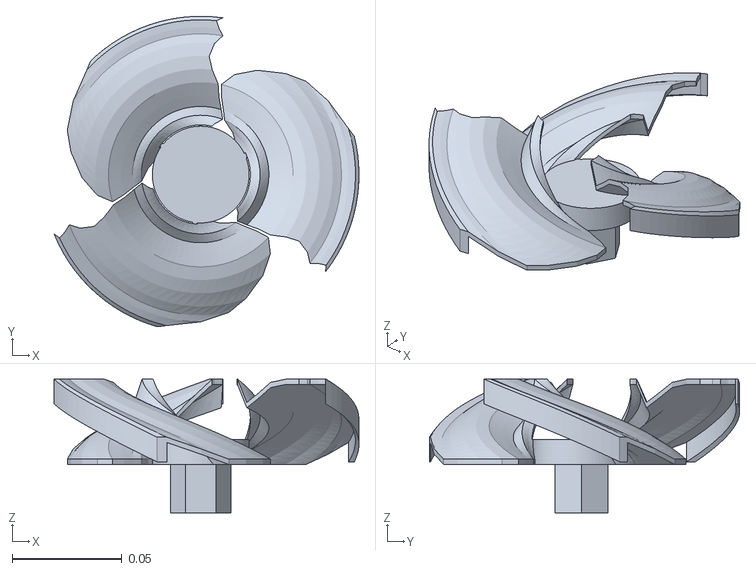
[picture p48: CAD file, 2026-10-19]
experiments/cfd400/geometry/scimitar.stl
0.139 x 0.141 x 0.0608
