joezen777/physicssculptures/experiments/print_petg_12/output/arm_joint_variants/S14_side_access_hub_print-1x.stl

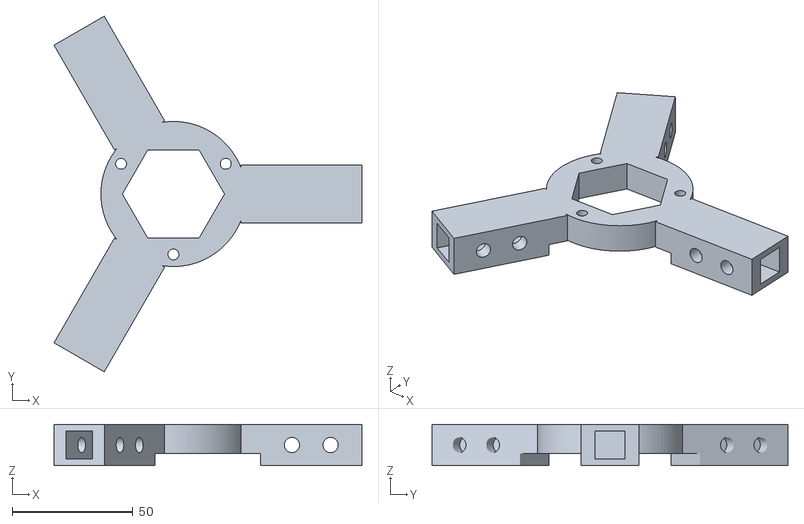
[picture p49: CAD file, 2026-10-19]
experiments/print_petg_12/output/arm_joint_variants/S14_side_access_hub_print-1x.stl
127.4 x 147.1 x 17.0
