joezen777/physicssculptures/experiments/print_petg_12/output/p19_rain/P19C_rain.step

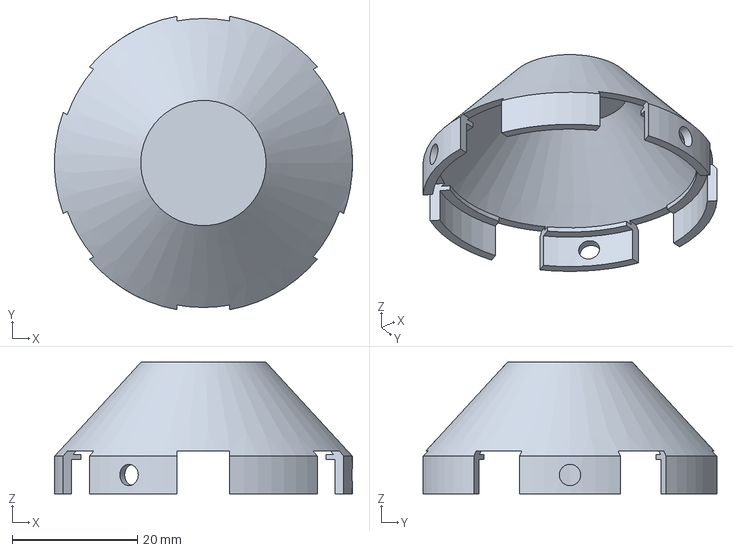
[picture p50: CAD file, 2026-10-19]
experiments/print_petg_12/output/p19_rain/P19C_rain.step
47.6 x 46.9 x 21.0 mm
