joezen777/physicssculptures/experiments/print_petg_12/output/sail_80x120/P15_arm_180mm_print-3x.stl

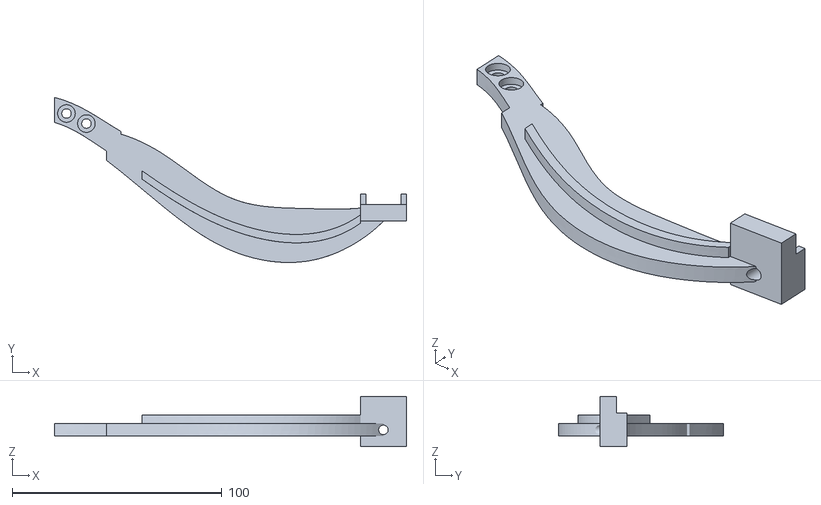
[picture p51: CAD file, 2026-10-11]
experiments/print_petg_12/output/sail_80x120/P15_arm_180mm_print-3x.stl
167.7 x 78.6 x 24.0
