joezen777/physicssculptures/experiments/print_petg_12/output/stl/resin_hardware_sprues/H16_ID4p2_OD6_spacers_print-1x.stl

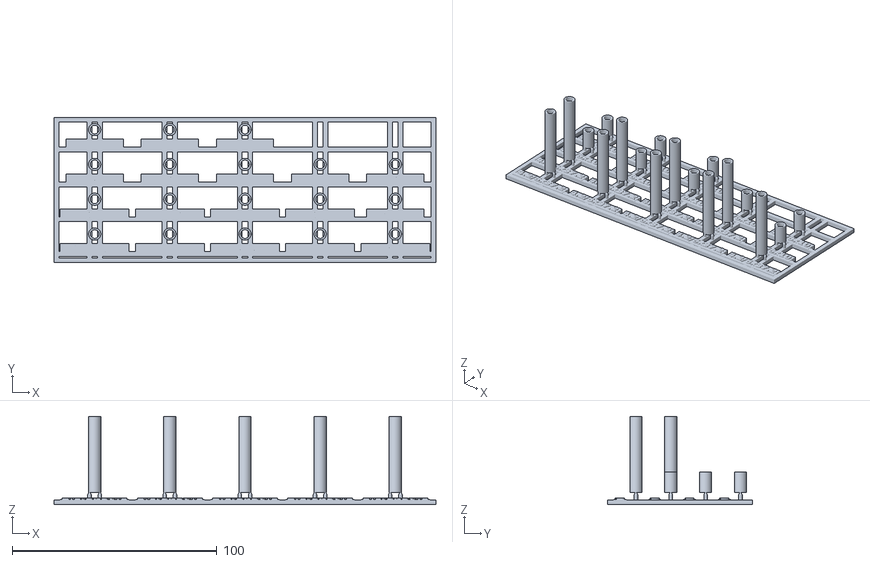
[picture p52: CAD file, 2026-10-03]
experiments/print_petg_12/output/stl/resin_hardware_sprues/H16_ID4p2_OD6_spacers_print-1x.stl
186.5 x 71.0 x 43.2
