joezen777/physicssculptures/experiments/cfd400/geometry/tubercled.FCStd

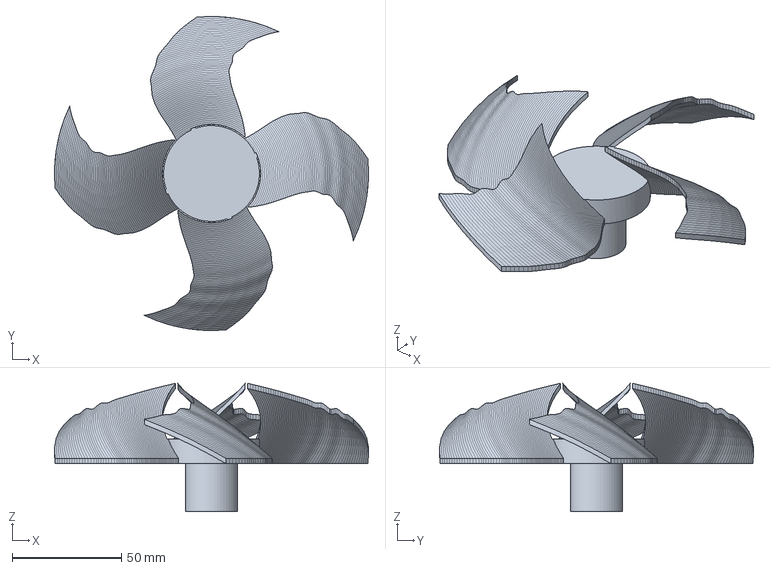
[picture p53: CAD file, 2026-10-19]
experiments/cfd400/geometry/tubercled.FCStd
144.0 x 144.0 x 58.9 mm
