joezen777/physicssculptures/experiments/print_petg_12/output/arm_joint_variants/T15_extension_print-3x.stl

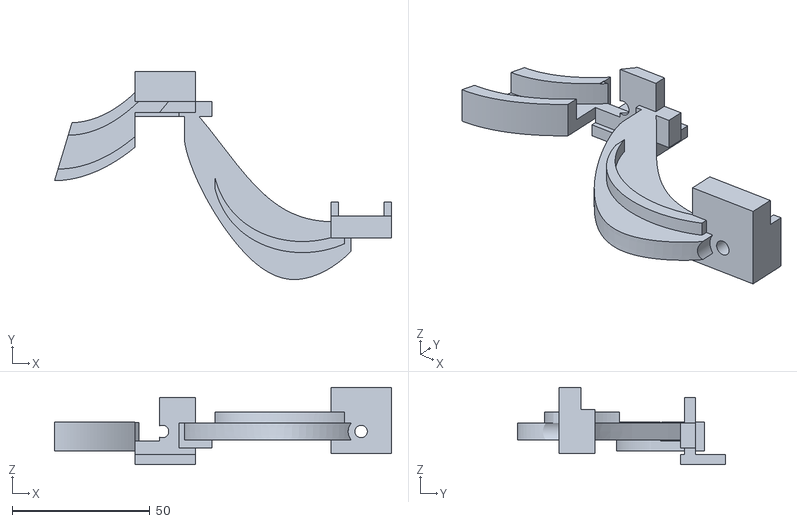
[picture p54: CAD file, 2026-10-19]
experiments/print_petg_12/output/arm_joint_variants/T15_extension_print-3x.stl
122.1 x 75.4 x 28.0
