joezen777/physicssculptures/experiments/print_petg_12/output/sail_80x120/P16_scoop_80x120mm_print-3x.stl

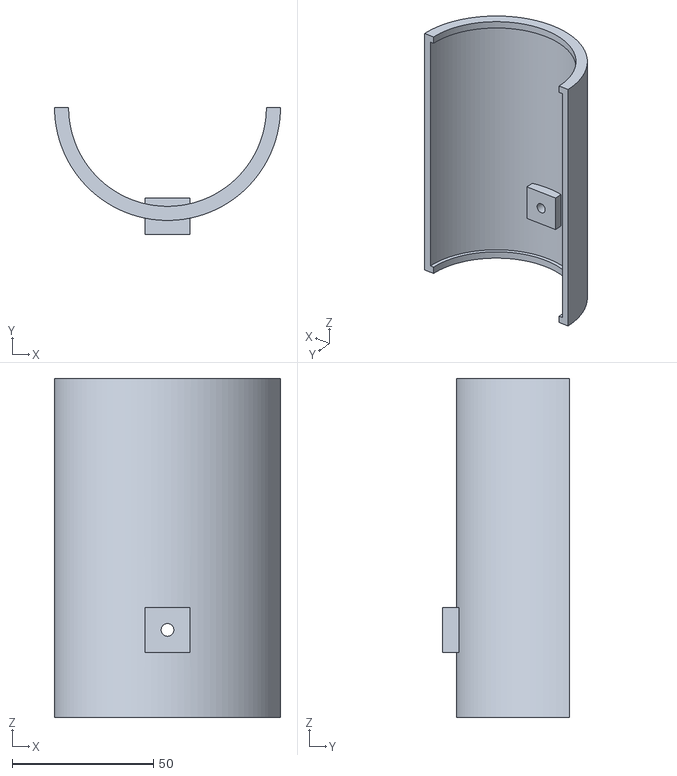
[picture p55: CAD file, 2026-10-11]
experiments/print_petg_12/output/sail_80x120/P16_scoop_80x120mm_print-3x.stl
80.0 x 45.0 x 120.0
