joezen777/physicssculptures/experiments/print_petg_12/output/stl/C03_PETG_support_release_025_050_075.stl

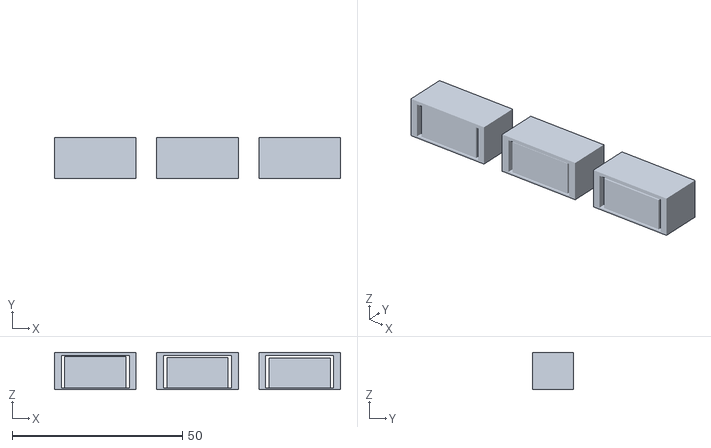
[picture p56: CAD file, 2026-10-19]
experiments/print_petg_12/output/stl/C03_PETG_support_release_025_050_075.stl
84.0 x 12.0 x 11.0
