joezen777/physicssculptures/experiments/print_petg_12/output/scimitar_40mm/scimitar_40mm.FCStd

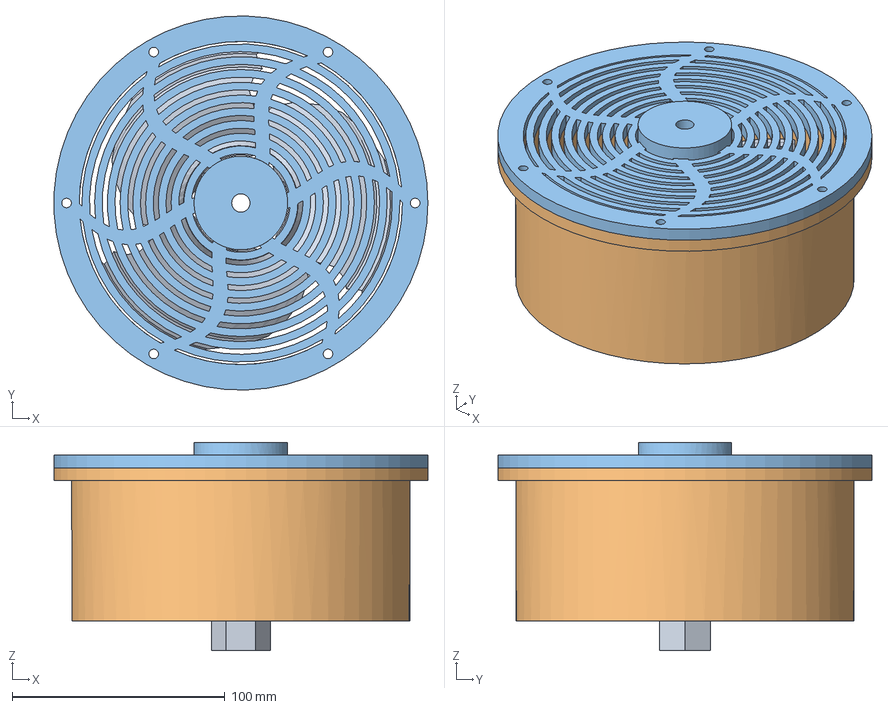
[picture p57: CAD file, 2026-10-19]
experiments/print_petg_12/output/scimitar_40mm/scimitar_40mm.FCStd
175.9 x 175.9 x 98.0 mm
P17S
P18S
P19_reference
