joezen777/physicssculptures/experiments/print_petg_12/output/toroidal5_final/P19.step

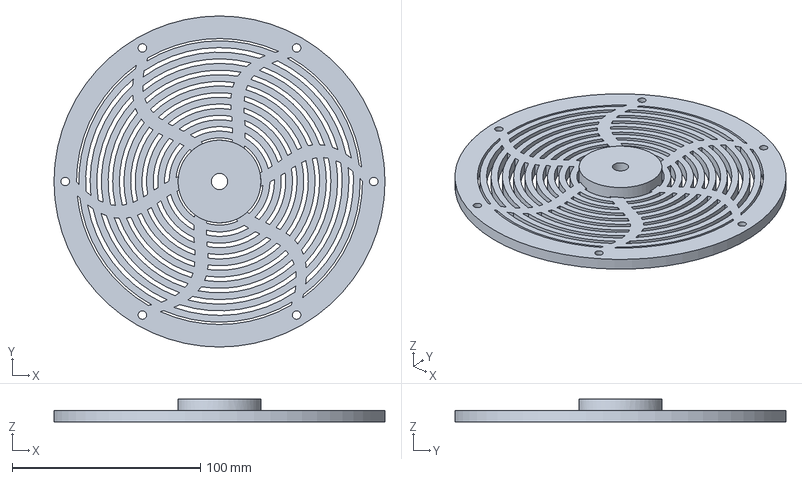
[picture p58: CAD file, 2026-10-19]
experiments/print_petg_12/output/toroidal5_final/P19.step
176.0 x 176.0 x 12.0 mm
