joezen777/physicssculptures/experiments/print_petg_12/output/arm_joint_variants/arm_joint_variants.FCStd

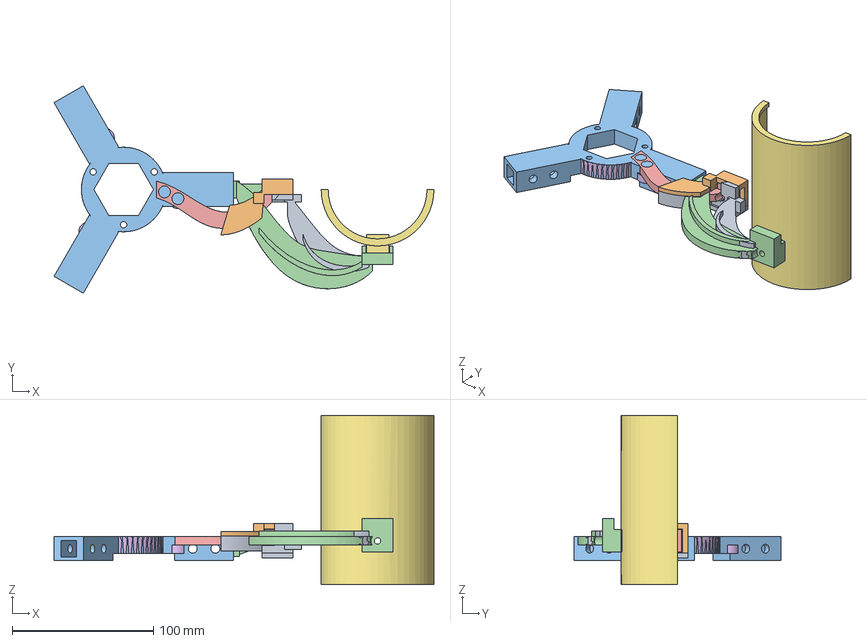
[picture p59: CAD file, 2026-10-19]
experiments/print_petg_12/output/arm_joint_variants/arm_joint_variants.FCStd
269.4 x 147.1 x 120.0 mm
T15_extension
T15_closing_cap
S14_side_access_hub
S15_side_access_arm
Original_P15
Original_P14
Reference_P16
