joezen777/physicssculptures/experiments/print_petg_12/output/stl/P19_curved_guard_grille_print-1x.stl

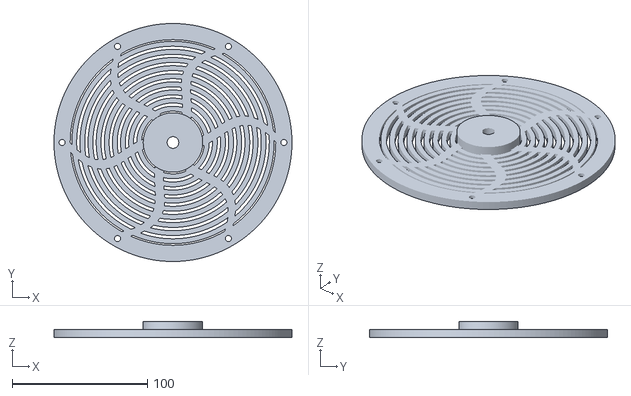
[picture p60: CAD file, 2026-10-19]
experiments/print_petg_12/output/stl/P19_curved_guard_grille_print-1x.stl
176.0 x 176.0 x 12.0
