joezen777/physicssculptures/experiments/print_petg_12/output/stl/resin_hardware_sprues/H12_M8_nuts_print-1x.stl

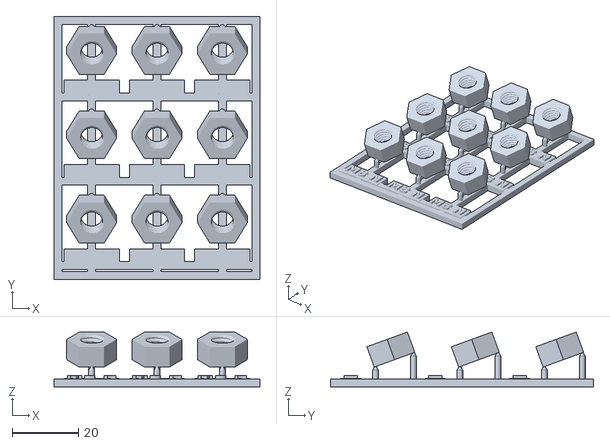
[picture p61: CAD file, 2026-10-03]
experiments/print_petg_12/output/stl/resin_hardware_sprues/H12_M8_nuts_print-1x.stl
62.1 x 79.3 x 16.6
