joezen777/physicssculptures/experiments/print_petg_12/output/arm_joint_variants/T15_closing_cap_print-3x.stl

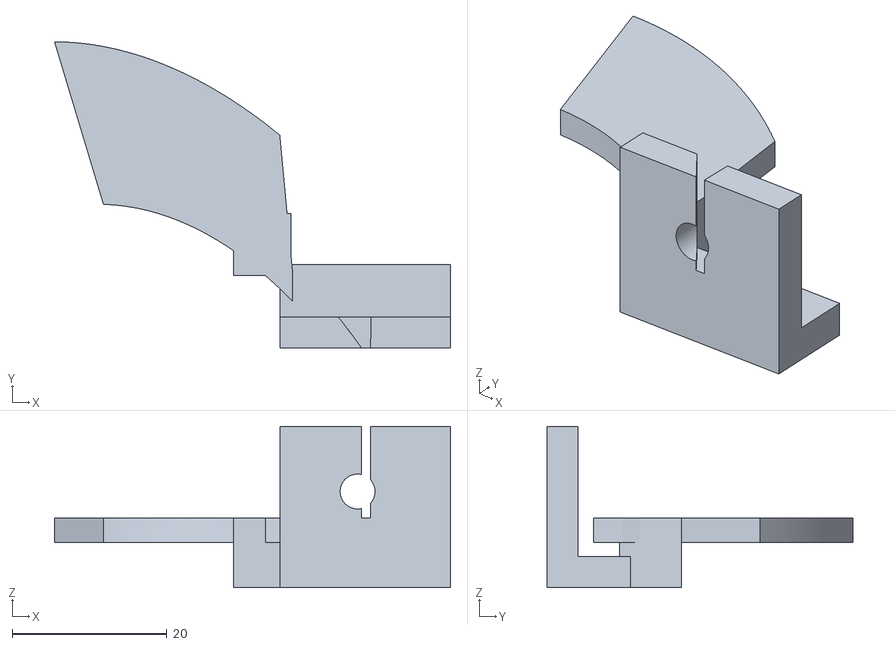
[picture p62: CAD file, 2026-10-19]
experiments/print_petg_12/output/arm_joint_variants/T15_closing_cap_print-3x.stl
51.1 x 39.6 x 20.8
