joezen777/physicssculptures/experiments/print_petg_12/output/stl/P06_sun_36T_helical_socket_print-3x.stl

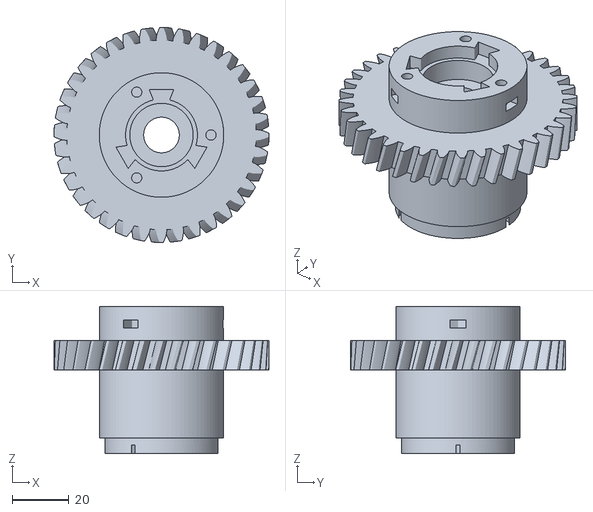
[picture p63: CAD file, 2026-10-12]
experiments/print_petg_12/output/stl/P06_sun_36T_helical_socket_print-3x.stl
76.0 x 76.0 x 52.0
