joezen777/physicssculptures/experiments/print_petg_12/output/stl/resin_hardware_sprues/H11_M4_nuts_print-3x.stl

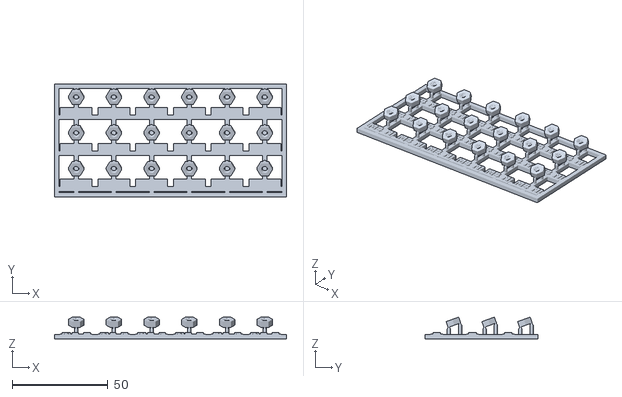
[picture p64: CAD file, 2026-10-03]
experiments/print_petg_12/output/stl/resin_hardware_sprues/H11_M4_nuts_print-3x.stl
121.1 x 59.0 x 11.4
