joezen777/physicssculptures/experiments/print_petg_12/output/stl/P09_72T_helical_ring_print-3x.stl

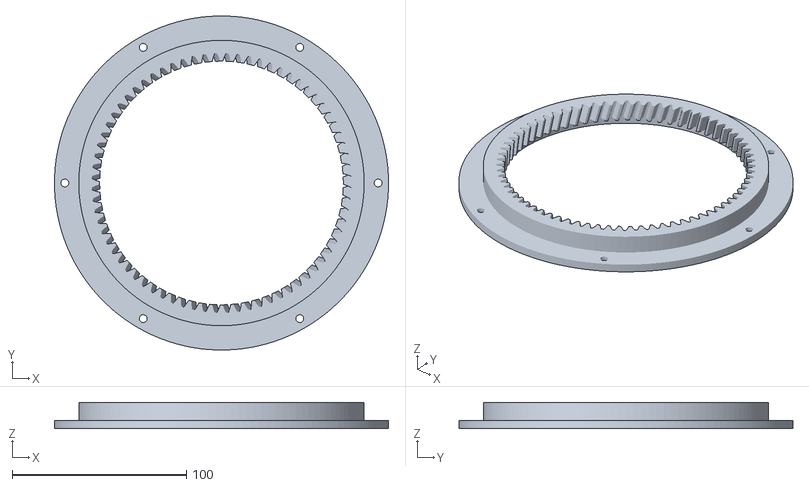
[picture p65: CAD file, 2026-10-12]
experiments/print_petg_12/output/stl/P09_72T_helical_ring_print-3x.stl
192.0 x 191.9 x 15.2
