joezen777/physicssculptures/experiments/print_petg_12/output/stl/resin_hardware_sprues/H00_thread_fit_test_print-1x.stl

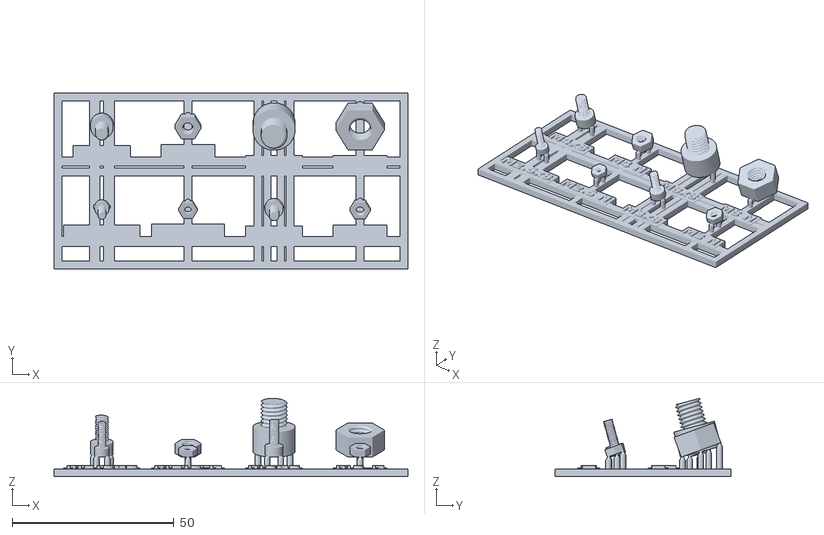
[picture p66: CAD file, 2026-10-03]
experiments/print_petg_12/output/stl/resin_hardware_sprues/H00_thread_fit_test_print-1x.stl
109.3 x 54.3 x 24.1
