joezen777/physicssculptures/experiments/print_petg_12/output/stl/P07_planet_18T_helical_604_print-9x.stl

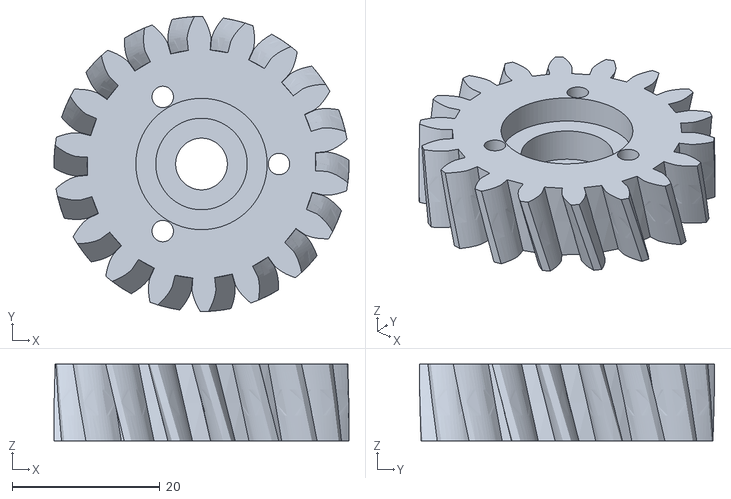
[picture p67: CAD file, 2026-10-12]
experiments/print_petg_12/output/stl/P07_planet_18T_helical_604_print-9x.stl
40.0 x 40.0 x 10.4
