joezen777/physicssculptures/experiments/print_petg_12/output/stl/P02_pot_fan_A_print-2x.stl

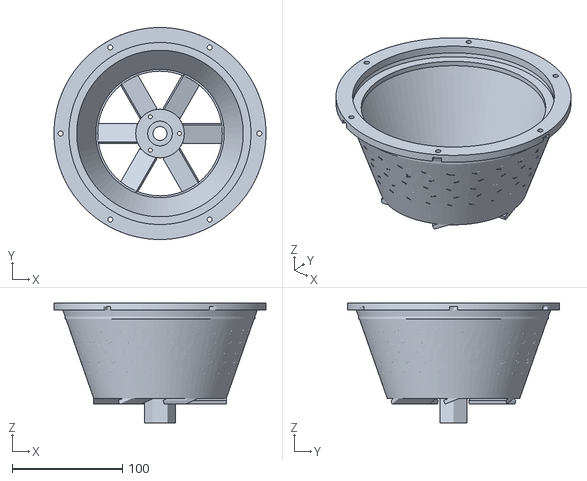
[picture p68: CAD file, 2026-10-03]
experiments/print_petg_12/output/stl/P02_pot_fan_A_print-2x.stl
192.0 x 192.0 x 108.4
