joezen777/physicssculptures/experiments/print_petg_12/output/stl/resin_hardware_sprues/H10_M3_nuts_print-3x.stl

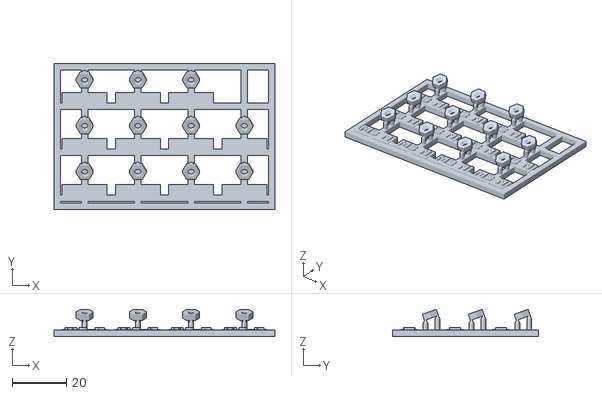
[picture p69: CAD file, 2026-10-03]
experiments/print_petg_12/output/stl/resin_hardware_sprues/H10_M3_nuts_print-3x.stl
81.8 x 54.0 x 10.1
