joezen777/physicssculptures/experiments/print_petg_12/output/toroidal5_final/P17_toroidal5_supports_only.stl

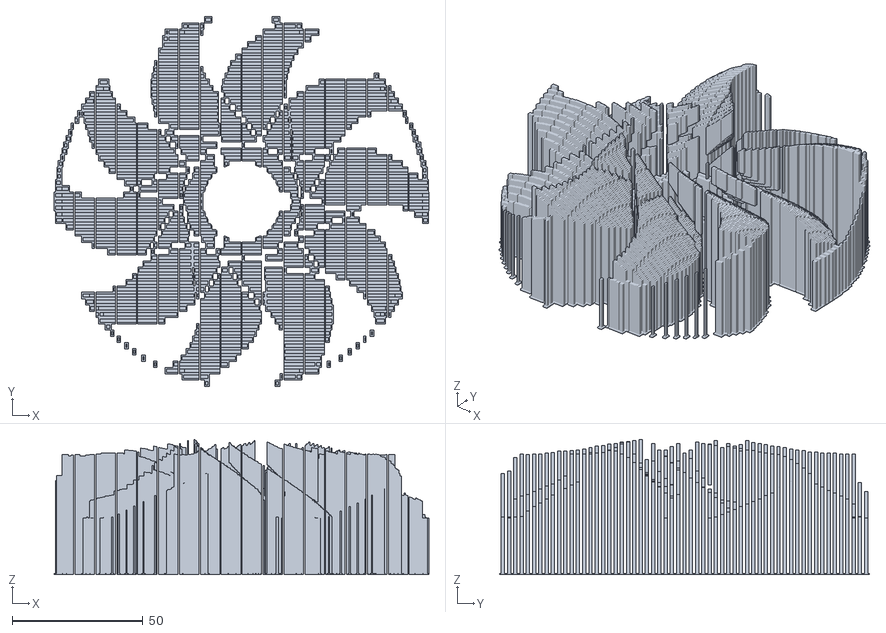
[picture p70: CAD file, 2026-10-19]
experiments/print_petg_12/output/toroidal5_final/P17_toroidal5_supports_only.stl
143.4 x 141.7 x 51.8
