joezen777/physicssculptures/experiments/print_petg_12/output/stl/P05_sun_lower_bearing_housing_print-3x.stl

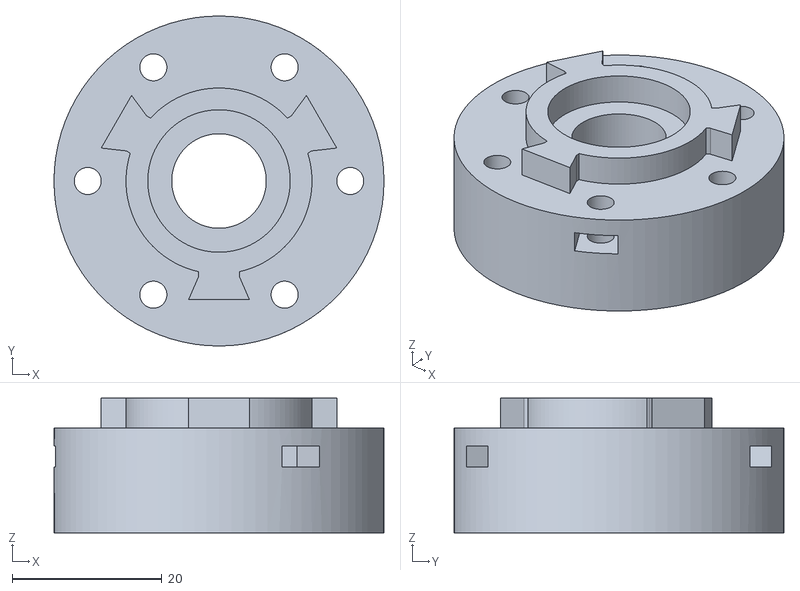
[picture p71: CAD file, 2026-10-03]
experiments/print_petg_12/output/stl/P05_sun_lower_bearing_housing_print-3x.stl
44.0 x 44.0 x 18.0
