joezen777/physicssculptures/experiments/print_petg_12/output/stl/resin_hardware_sprues/H09_M2p5_nuts_print-3x.stl

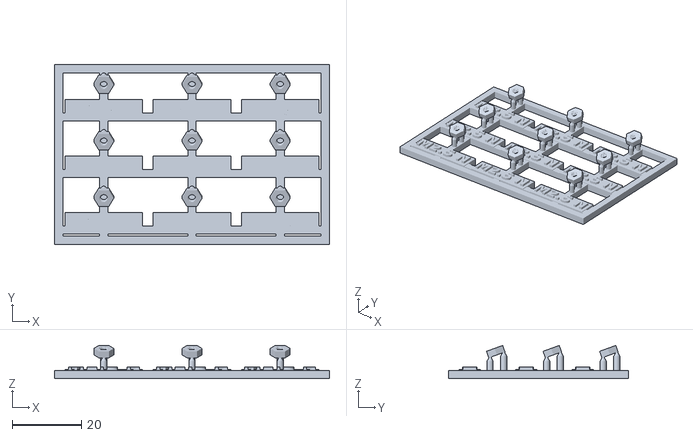
[picture p72: CAD file, 2026-10-03]
experiments/print_petg_12/output/stl/resin_hardware_sprues/H09_M2p5_nuts_print-3x.stl
79.7 x 52.1 x 9.59
