joezen777/physicssculptures/experiments/print_petg_12/output/stl/P15_curved_sail_arm_print-3x.stl

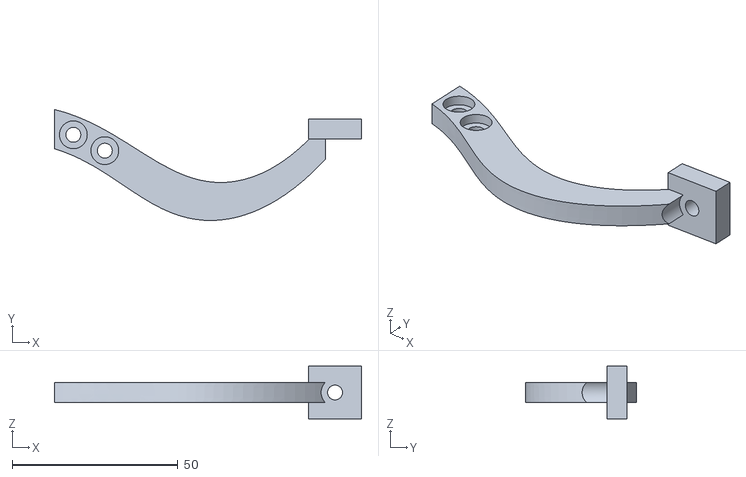
[picture p73: CAD file, 2026-10-03]
experiments/print_petg_12/output/stl/P15_curved_sail_arm_print-3x.stl
92.7 x 33.5 x 16.0
