joezen777/physicssculptures/experiments/print_petg_12/output/stl/P10_interstage_air_collar_print-2x.stl

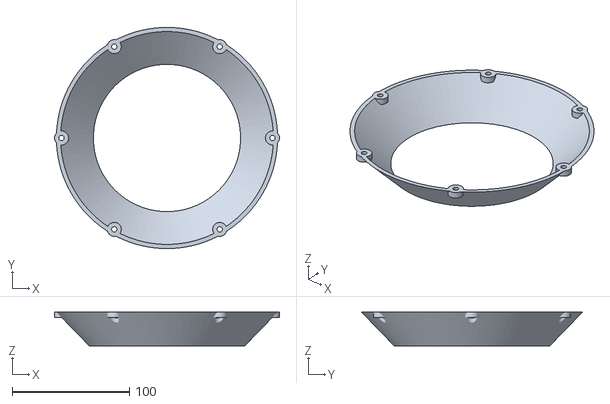
[picture p74: CAD file, 2026-10-03]
experiments/print_petg_12/output/stl/P10_interstage_air_collar_print-2x.stl
192.0 x 188.8 x 28.8
