joezen777/physicssculptures/experiments/print_petg_12/output/stl/P11_terminal_air_collar_print-1x.stl

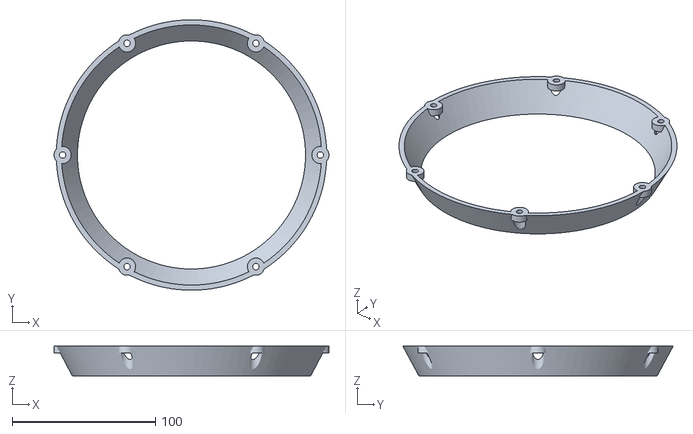
[picture p75: CAD file, 2026-10-03]
experiments/print_petg_12/output/stl/P11_terminal_air_collar_print-1x.stl
192.0 x 188.8 x 20.8
