joezen777/physicssculptures/experiments/print_petg_12/output/stl/P13_base_drive_adapter_print-1x.stl

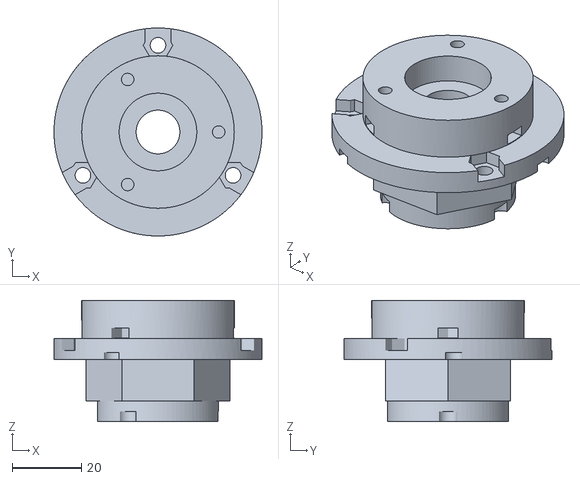
[picture p76: CAD file, 2026-10-03]
experiments/print_petg_12/output/stl/P13_base_drive_adapter_print-1x.stl
60.0 x 60.0 x 35.0
