joezen777/physicssculptures/experiments/print_petg_12/output/stl/P16_wind_cup_print-3x.stl

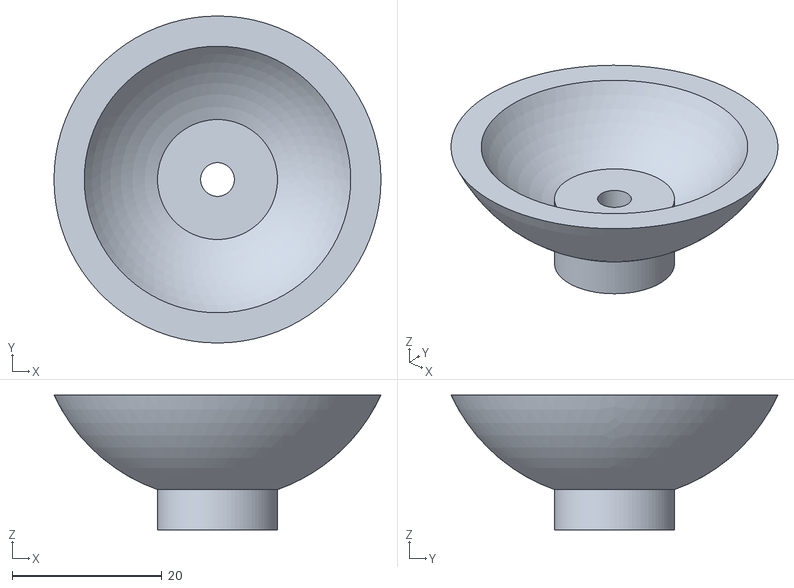
[picture p77: CAD file, 2026-10-02]
experiments/print_petg_12/output/stl/P16_wind_cup_print-3x.stl
43.6 x 43.6 x 18.0
