joezen777/physicssculptures/experiments/print_petg_12/output/stl/resin_hardware_sprues/H15_ID8p2_OD12_spacers_print-1x.stl

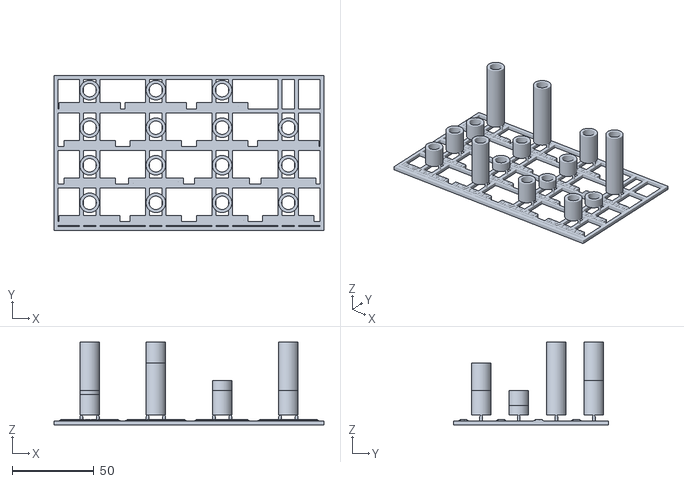
[picture p78: CAD file, 2026-10-03]
experiments/print_petg_12/output/stl/resin_hardware_sprues/H15_ID8p2_OD12_spacers_print-1x.stl
165.4 x 95.0 x 50.6
