joezen777/physicssculptures/experiments/print_petg_12/output/stl/C01_608_fit_coupon_print-1x.stl

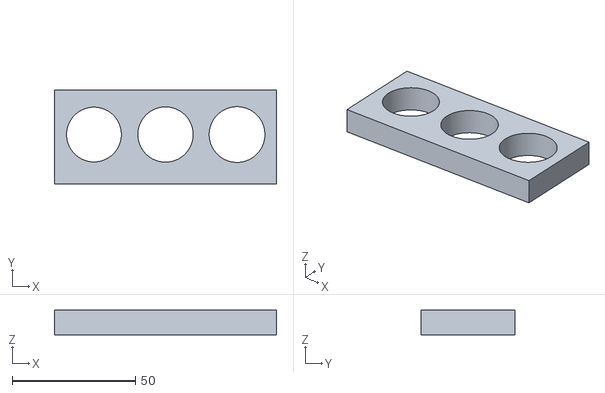
[picture p79: CAD file, 2026-10-02]
experiments/print_petg_12/output/stl/C01_608_fit_coupon_print-1x.stl
90.0 x 38.0 x 10.0
