joezen777/physicssculptures/experiments/print_petg_12/output/stl/P14_sail_hex_hub_print-1x.stl

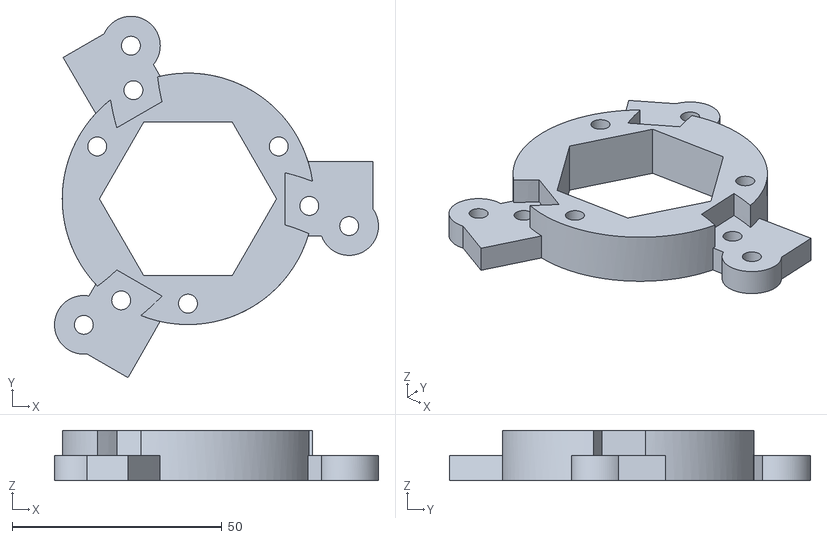
[picture p80: CAD file, 2026-10-02]
experiments/print_petg_12/output/stl/P14_sail_hex_hub_print-1x.stl
77.3 x 86.2 x 12.0
