joezen777/physicssculptures/experiments/print_petg_12/output/stl/P08_604_retainer_print-9x.stl

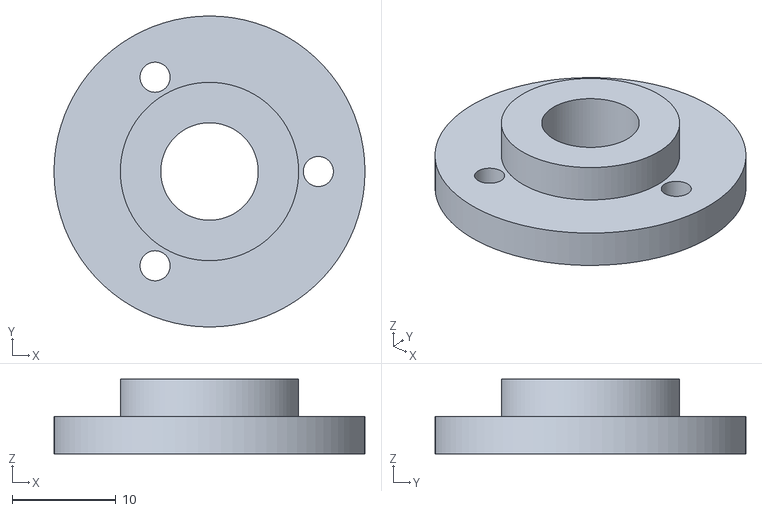
[picture p81: CAD file, 2026-10-02]
experiments/print_petg_12/output/stl/P08_604_retainer_print-9x.stl
30.0 x 30.0 x 7.20
