joezen777/physicssculptures/experiments/print_petg_12/output/stl/C02_604_fit_coupon_print-1x.stl

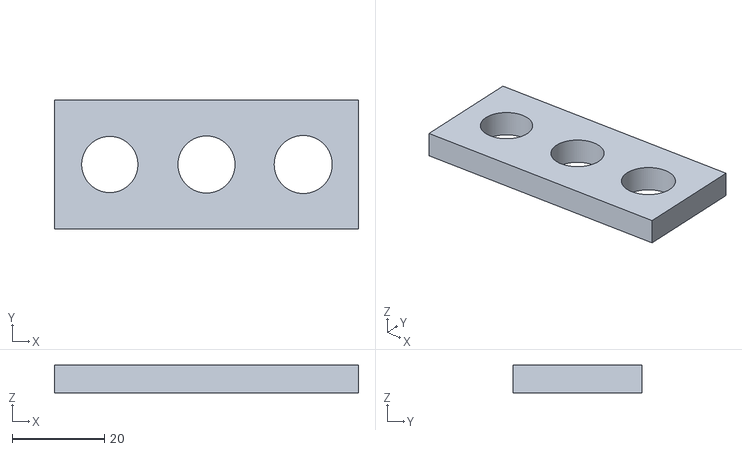
[picture p82: CAD file, 2026-10-02]
experiments/print_petg_12/output/stl/C02_604_fit_coupon_print-1x.stl
66.0 x 28.0 x 6.00
