joezen777/physicssculptures/experiments/print_petg_12/output/stl/P01_608_retainer_print-8x.stl

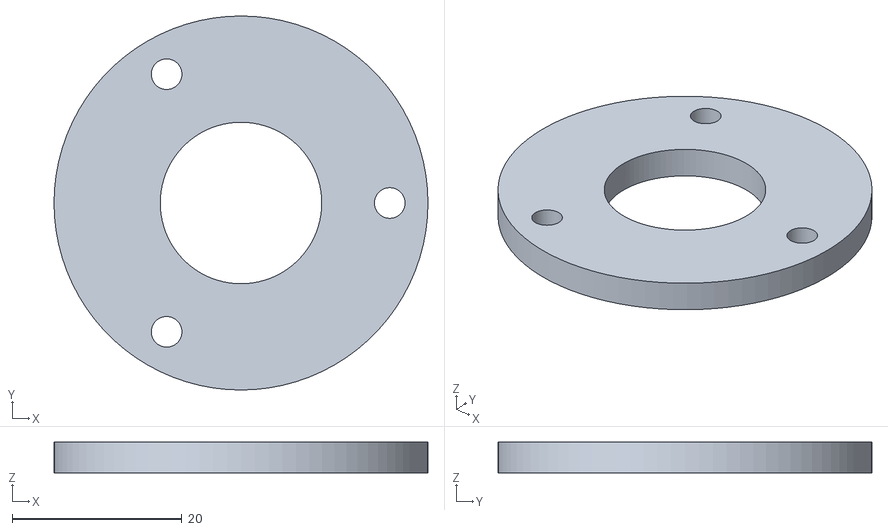
[picture p83: CAD file, 2026-10-02]
experiments/print_petg_12/output/stl/P01_608_retainer_print-8x.stl
44.0 x 44.0 x 3.60
