joezen777/physicssculptures/experiments/print_petg_12/output/stl/P12_stationary_base_print-1x.stl

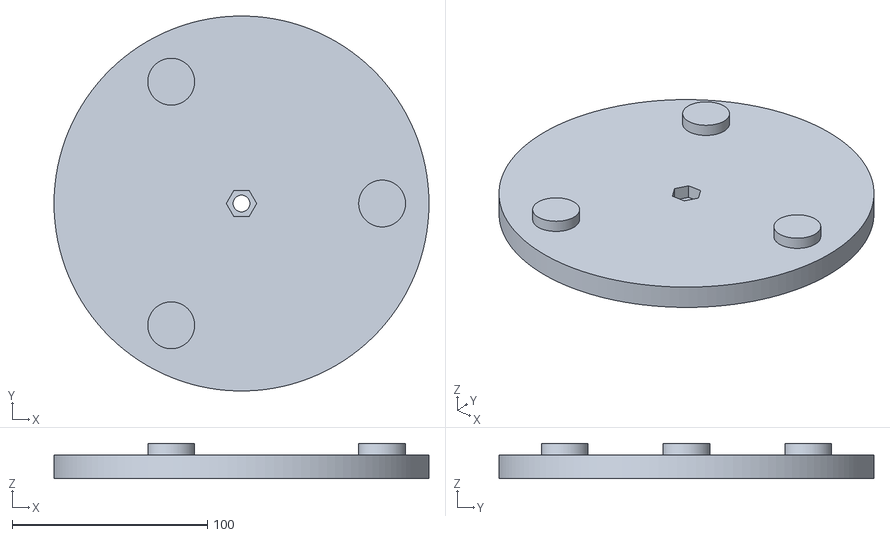
[picture p84: CAD file, 2026-10-02]
experiments/print_petg_12/output/stl/P12_stationary_base_print-1x.stl
192.0 x 191.9 x 18.0
