joezen777/physicssculptures/experiments/print_petg_12/output/stl/P04_fixed_curved_carrier_print-3x.stl

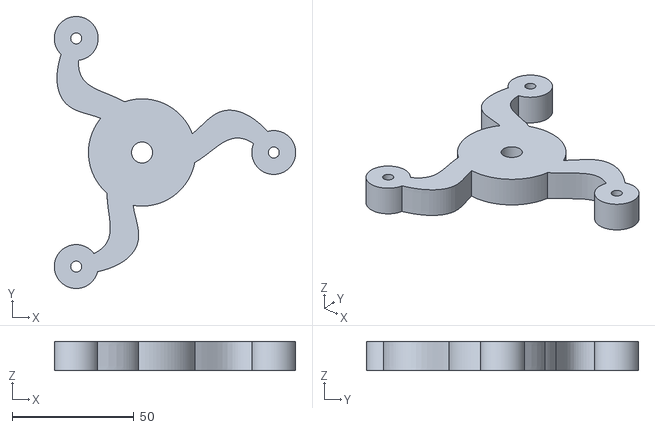
[picture p85: CAD file, 2026-10-02]
experiments/print_petg_12/output/stl/P04_fixed_curved_carrier_print-3x.stl
99.0 x 111.5 x 12.0
