joezen777/physicssculptures/(list of files, cad)

Other CAD files:
experiments/modular_fan_tunnel/output/tower_full.step
experiments/modular_fan_tunnel/output/tower_cutaway.step
experiments/print_petg_12/output/print_prototype.FCStd
experiments/drop_gearbox/magnetic_output/magnetic_cutaway.step
experiments/drop_gearbox/output/drop_gearbox.FCStd
experiments/modular_fan_tunnel/output/tower_without_sails.step
experiments/print_petg_12/output/scimitar_40mm/P18S_print-1x.stl
experiments/print_petg_12/output/stl/P18_top_guard_shroud_print-1x.stl
experiments/print_petg_12/output/toroidal5_final/P17.step
experiments/print_petg_12/output/scimitar_40mm/P17S.step
experiments/print_petg_12/output/stl/P185_print-1x.stl
experiments/print_petg_12/output/toroidal5_final/P18.step
experiments/print_petg_12/output/toroidal5_final/P185_print-1x.stl
experiments/print_petg_12/output/stl/P03_pot_fan_B_print-1x.stl
experiments/cfd400/geometry/toroidal5.stl
experiments/cfd400/geometry/tubercled.stl
experiments/modular_fan_tunnel/output/tower_cutaway.FCStd
experiments/print_petg_12/output/p19_rain/P19C_rain.stl
experiments/print_petg_12/output/p19_rain/P19_rain.FCStd
experiments/print_petg_12/output/p19_rain/P19_rain.stl
experiments/print_petg_12/output/stl/resin_hardware_sprues/H01_M2p5x16_screws_print-3x.stl
experiments/print_petg_12/output/stl/resin_hardware_sprues/H02_M3x16_screws_print-3x.stl
experiments/print_petg_12/output/stl/resin_hardware_sprues/H03_M3x20_screws_print-1x.stl
experiments/print_petg_12/output/stl/resin_hardware_sprues/H04_M4x20_screws_print-3x.stl
experiments/print_petg_12/output/stl/resin_hardware_sprues/H05_M4x10_button_screws_print-1x.stl
experiments/print_petg_12/output/stl/resin_hardware_sprues/H06_M4x25_screws_print-1x.stl
experiments/print_petg_12/output/stl/resin_hardware_sprues/H07_M4x16_screws_print-1x.stl
experiments/print_petg_12/output/stl/resin_hardware_sprues/H08_M4x75_axle_bolts_print-3x.stl
experiments/print_petg_12/output/stl/resin_hardware_sprues/H13_M8_acorn_nut_print-1x.stl
experiments/print_petg_12/output/stl/resin_hardware_sprues/H14_washers_OD7_and_OD9_print-1x.stl
experiments/roofvent_multiplier/output/tower_cutaway.step
experiments/roofvent_multiplier/output/tower_draft.FCStd
experiments/roofvent_multiplier/output/tower_full.step
experiments/simple_sail_tower/output/tower_cutaway.step
experiments/simple_sail_tower/output/tower_draft.FCStd
experiments/simple_sail_tower/output/tower_full.step
experiments/stacking_cones/output/tower_cutaway.step
experiments/stacking_cones/output/tower_draft.FCStd
experiments/stacking_cones/output/tower_full.step
