joezen777/physicssculptures/docs/printed_dovetail_joints.md

# Dovetails for split printed parts

Superseded 2026-10-10: P09 is now a one-piece helical ring with no dovetails (see print_petg_12.md). Previously, P09 ring halves used matching through dovetails in the outer flange, clear of the gear teeth. Each identical half has a male north connection and a female south connection. Rotate the second half 180 degrees, align both joints and slide it axially downward. Assemble the complete ring before seating it in the pot and bolting on P10 or P11. Do not force the halves together sideways. The collar screws retain the assembled ring axially.

P05 and P06, the split sun-bearing housing, now have three dovetail keys around the existing central locating pilot. Insert the 608 bearings as before, align all three keys, and lower P06 onto P05. Tighten the three existing M3 housing screws after seating; the keys locate the housing and transmit rotational load but do not replace axial retention.

Nominal socket allowance is 0.30 mm at each side. The keys have at least 5.4 mm neck width for the 1.2 mm PETG nozzle. Test fit after curing or cooling and remove support remnants. These joints are not intended as snap fits, particularly in resin. No hardware screw, nut, washer or tube spacer is split: each comes off its sprue as one piece.

The same revised P05/P06/P09 geometry is exported to the loose PETG STL set and the plastic-body resin sprue variation. The hardware-only sprue kit remains separate.
