joezen777/physicssculptures/experiments/drop_gearbox/magnetic_output/build_complete.txt

Geometry and assumed synchronous animation complete; no electromagnetic FEA.
