joezen777/physicssculptures/experiments/print_petg_12/output/arm_joint_variants/side_access_assembled.png

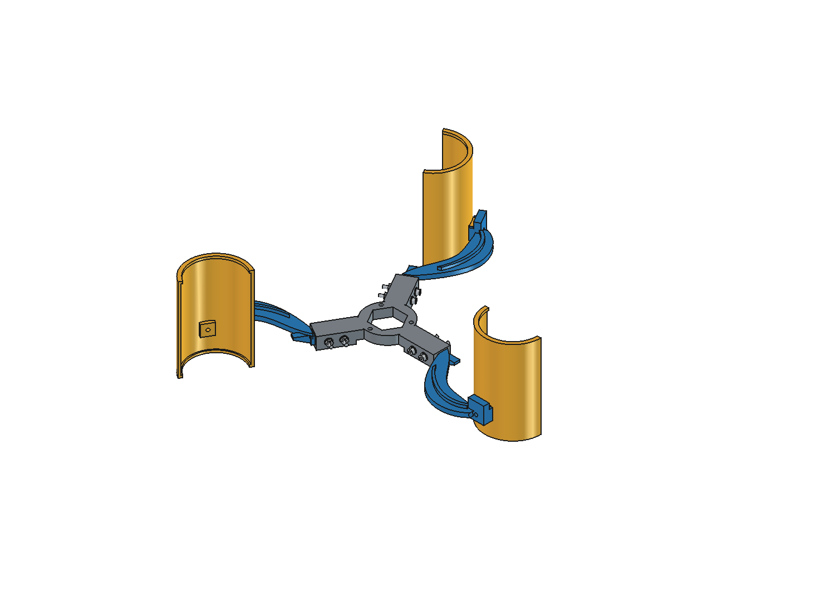
experiments/print_petg_12/output/arm_joint_variants/side_access_assembled.png
