joezen777/physicssculptures/experiments/print_petg_12/output/arm_joint_variants/side_joint_exploded.png

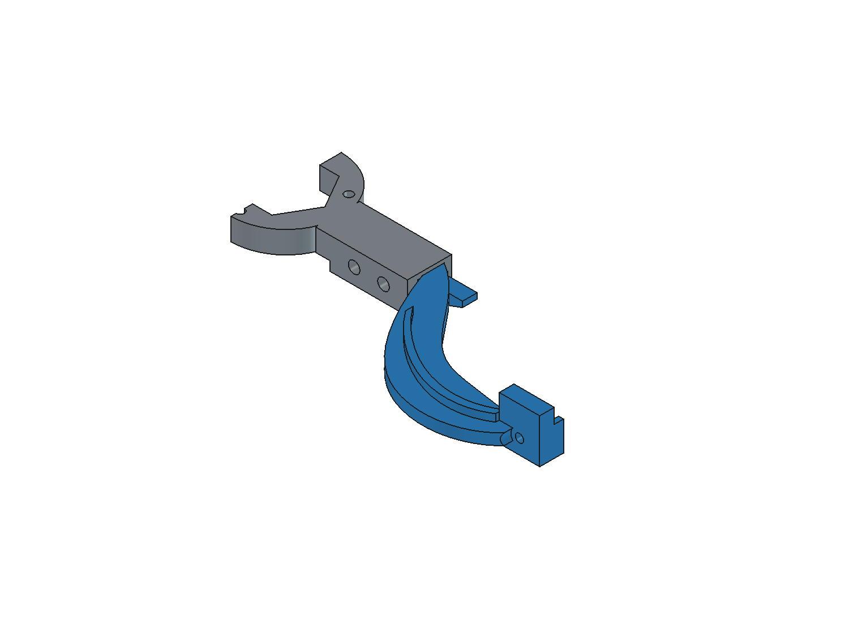
experiments/print_petg_12/output/arm_joint_variants/side_joint_exploded.png
