joezen777/physicssculptures/experiments/print_petg_12/output/arm_joint_variants/temporary_assembled.png

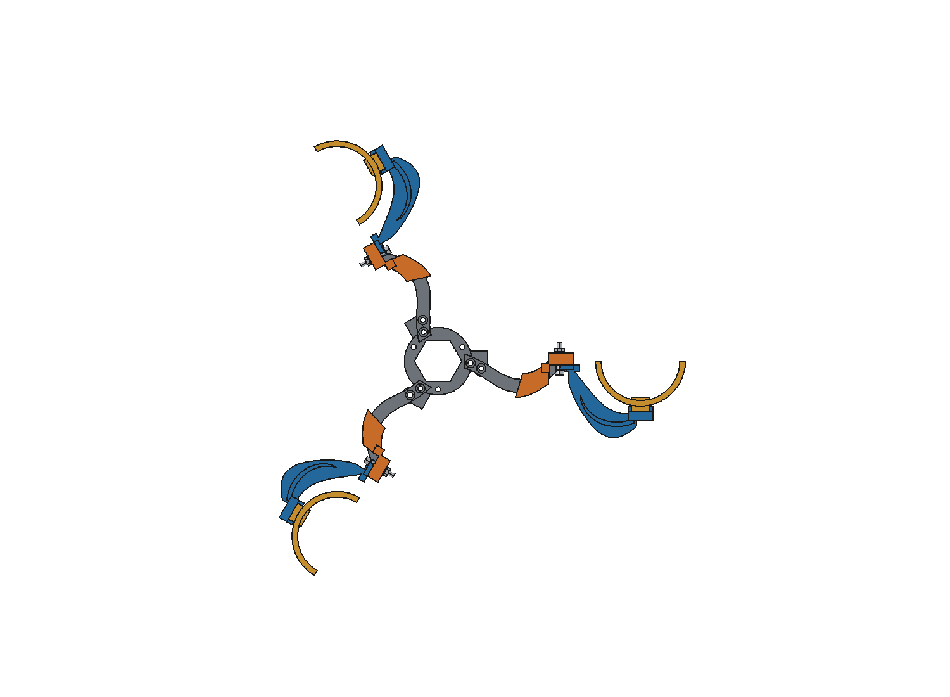
experiments/print_petg_12/output/arm_joint_variants/temporary_assembled.png
