joezen777/physicssculptures/experiments/print_petg_12/output/arm_joint_variants/temporary_joint_exploded.png

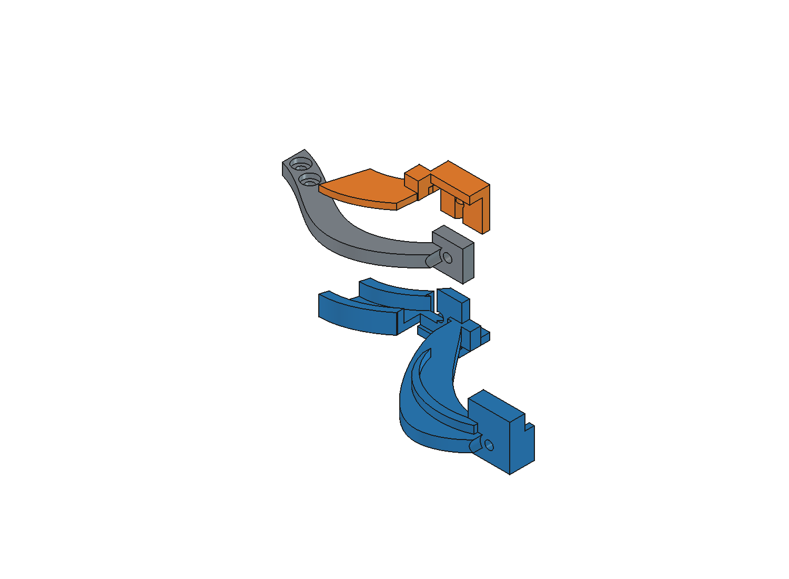
experiments/print_petg_12/output/arm_joint_variants/temporary_joint_exploded.png
