joezen777/physicssculptures/experiments/print_petg_12/output/assembled.png

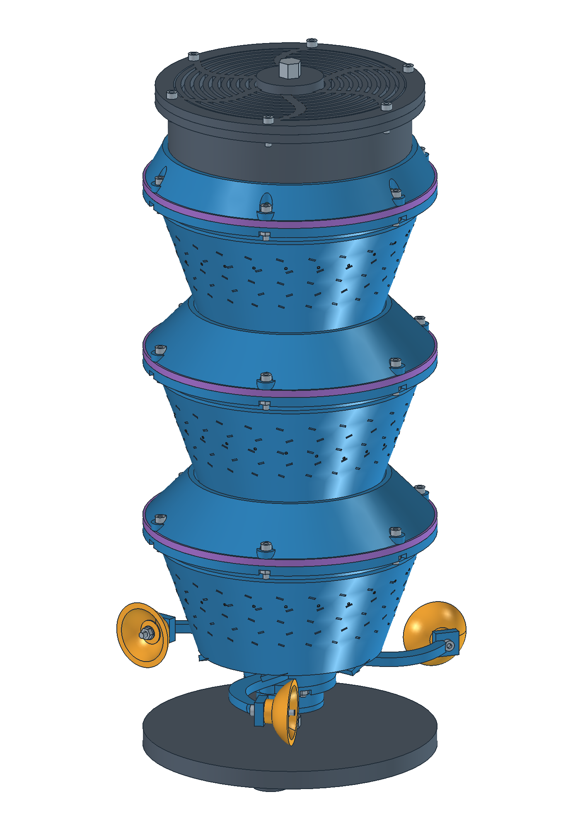
experiments/print_petg_12/output/assembled.png
