joezen777/physicssculptures/experiments/print_petg_12/output/assembly_guide_preview.png

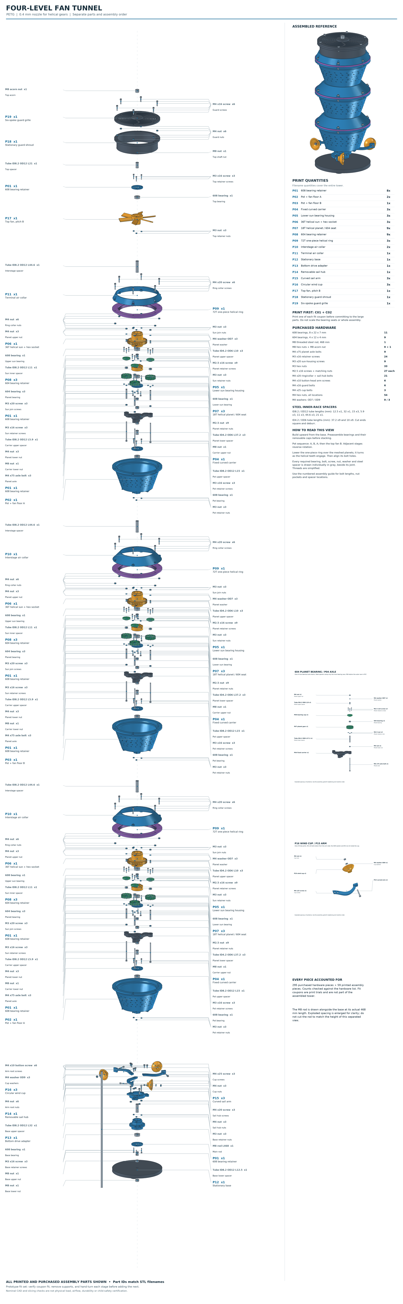
experiments/print_petg_12/output/assembly_guide_preview.png
