joezen777/physicssculptures/experiments/print_petg_12/output/bearing_spacers_motion.png

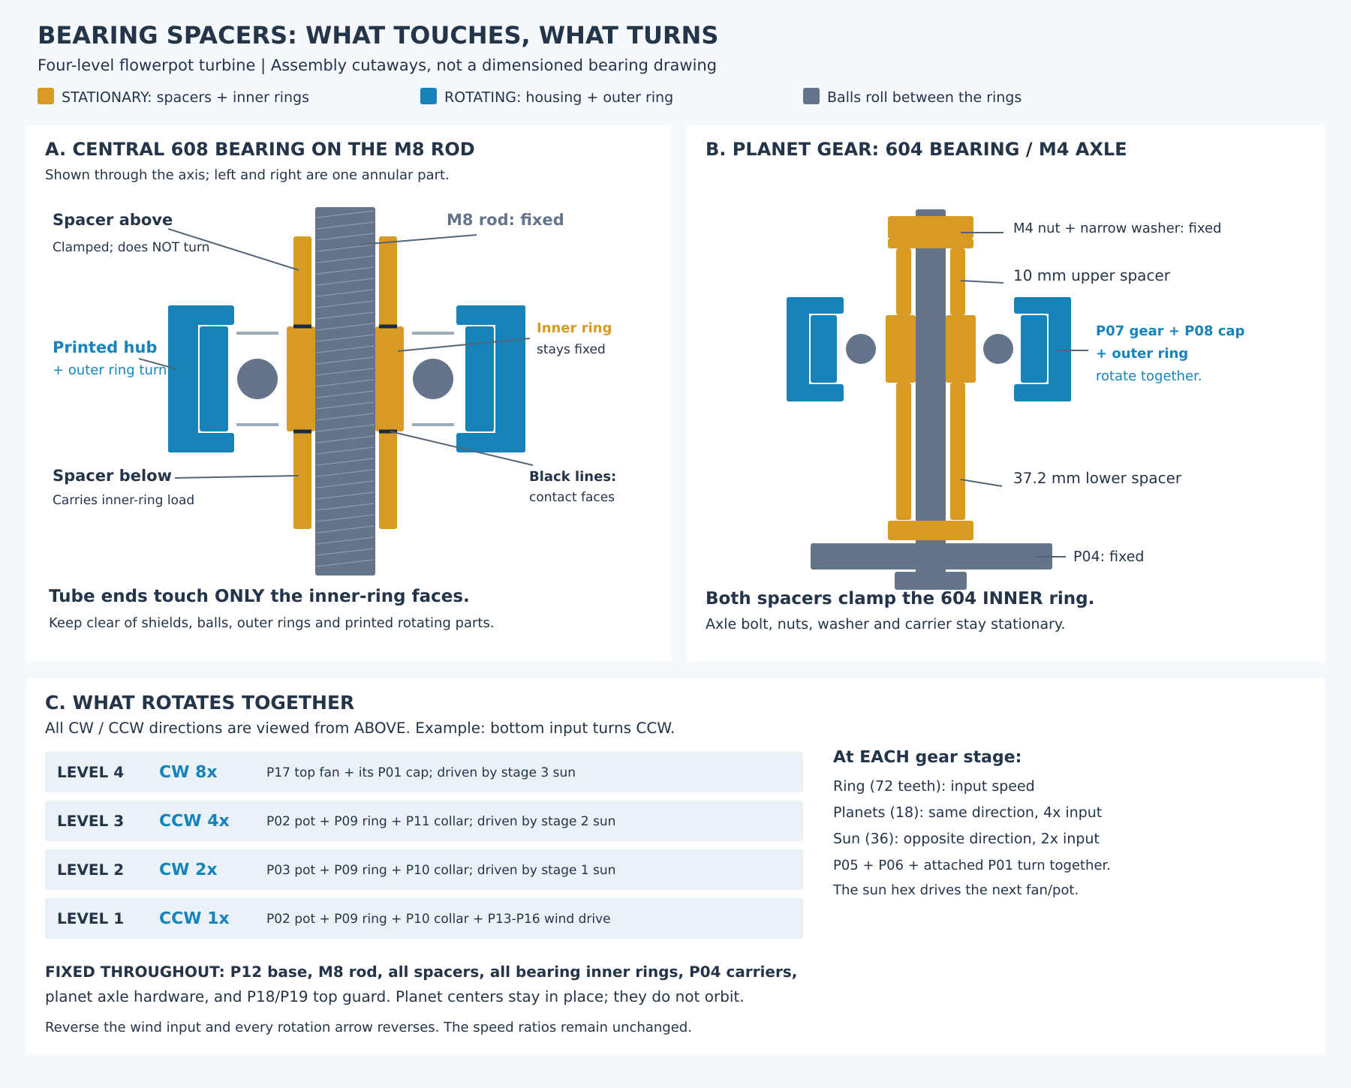
experiments/print_petg_12/output/bearing_spacers_motion.png
