joezen777/physicssculptures/experiments/print_petg_12/output/cup_joint_labeled.png

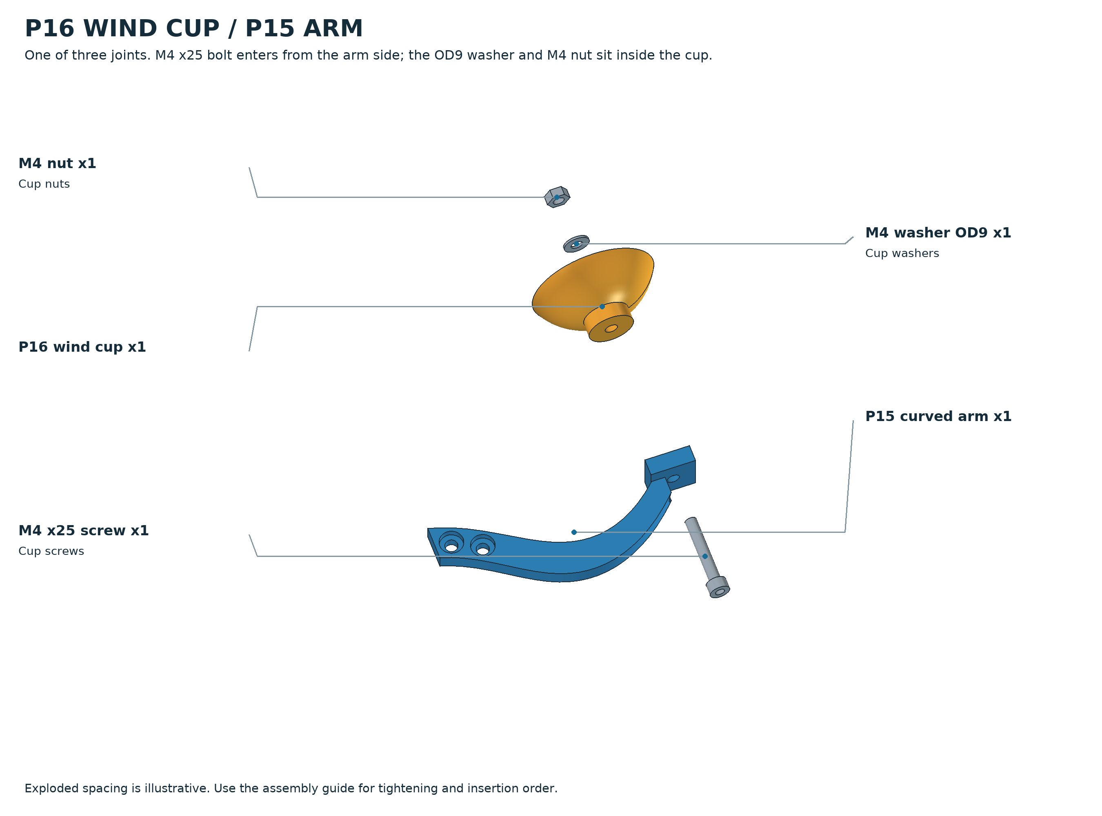
experiments/print_petg_12/output/cup_joint_labeled.png
