joezen777/physicssculptures/experiments/print_petg_12/output/cup_joint_raw.png

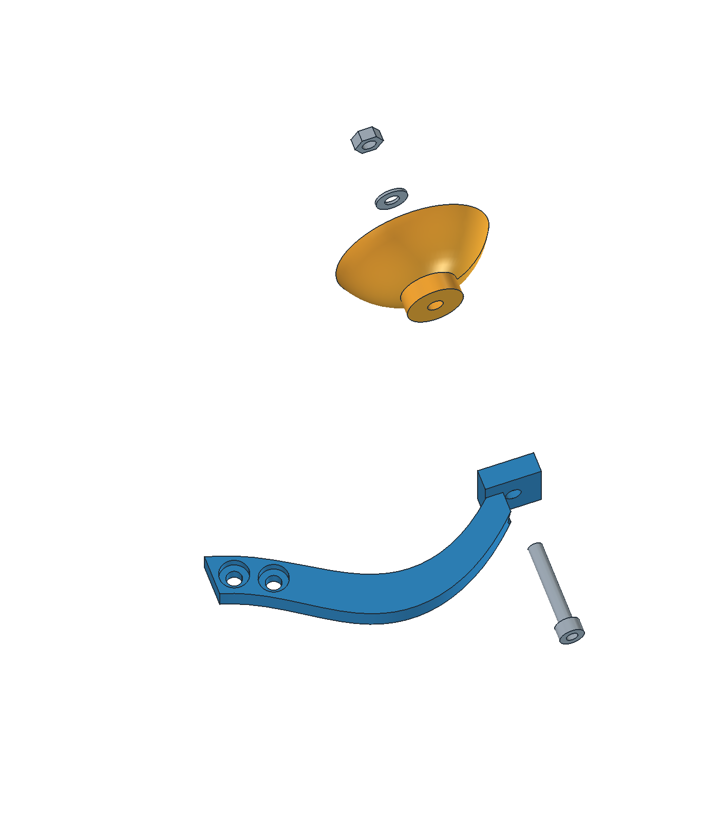
experiments/print_petg_12/output/cup_joint_raw.png
