joezen777/physicssculptures/experiments/print_petg_12/output/exploded_raw.png

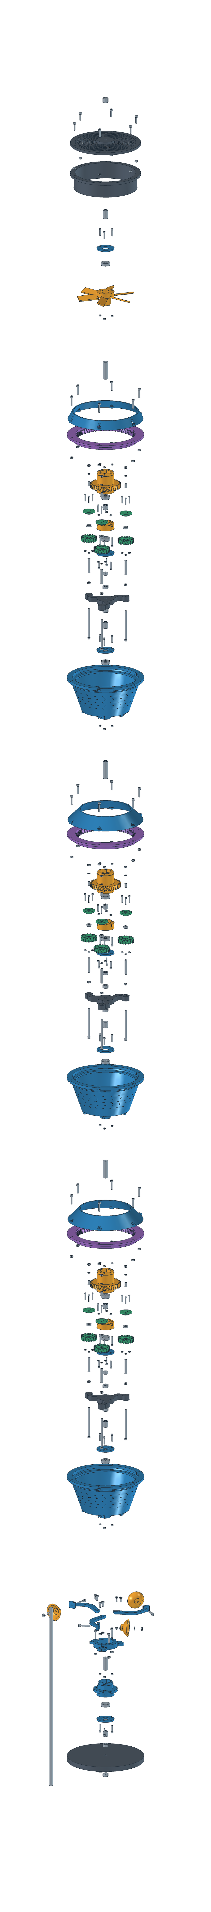
experiments/print_petg_12/output/exploded_raw.png
