joezen777/physicssculptures/experiments/print_petg_12/output/helical_gear_mesh.png

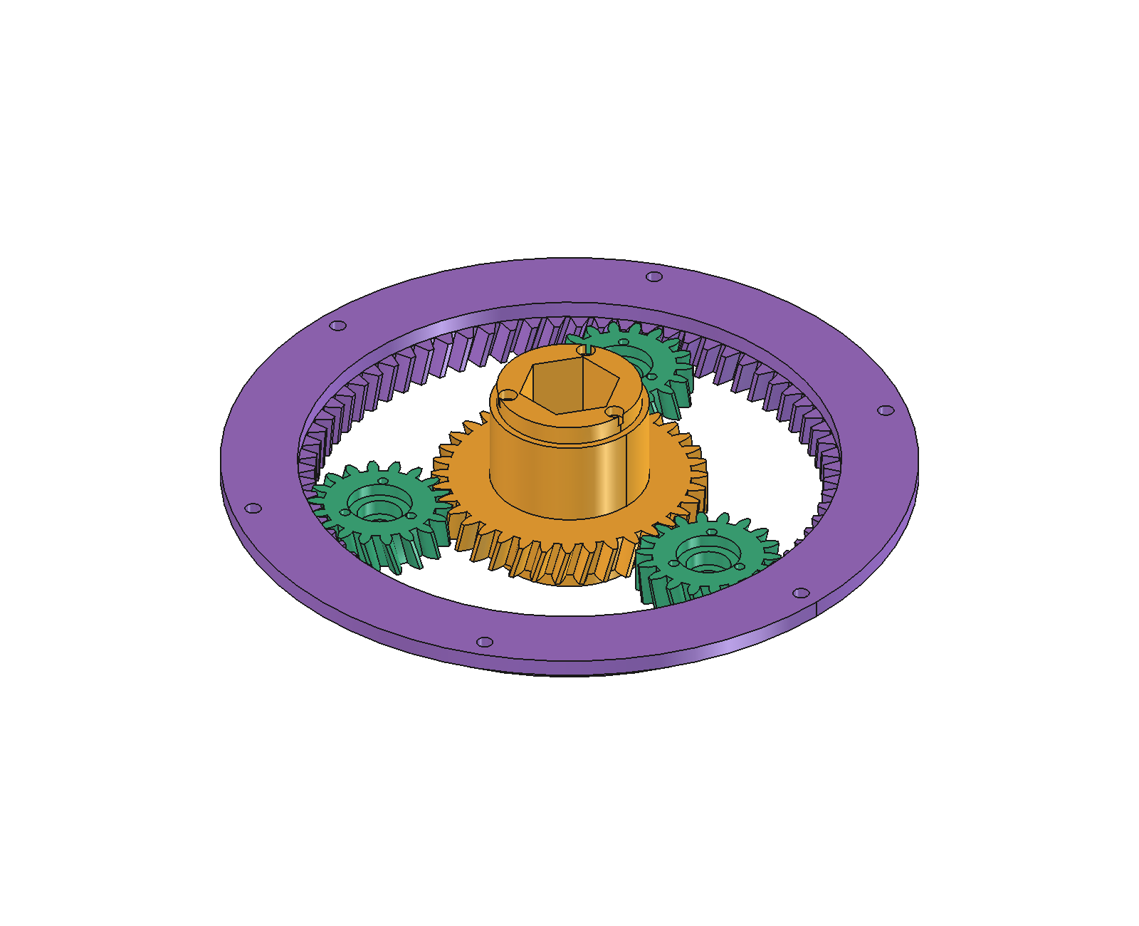
experiments/print_petg_12/output/helical_gear_mesh.png
