joezen777/physicssculptures/experiments/print_petg_12/output/helical_ring_assembly.png

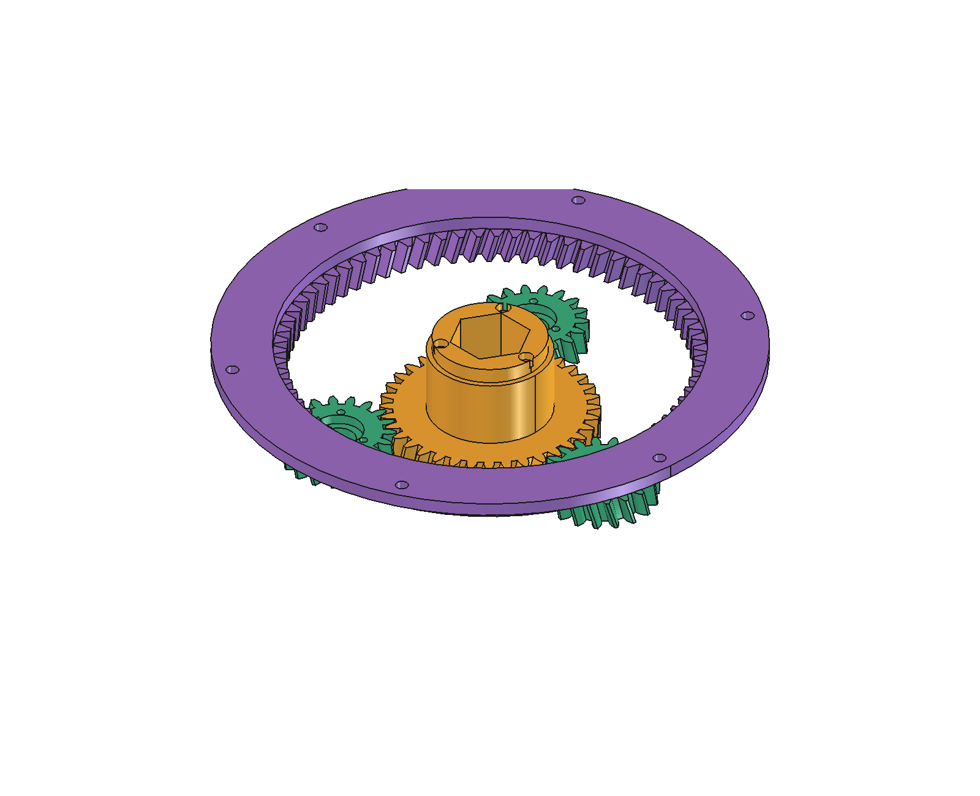
experiments/print_petg_12/output/helical_ring_assembly.png
