joezen777/physicssculptures/experiments/print_petg_12/output/p19_rain/P19_rain_review.png

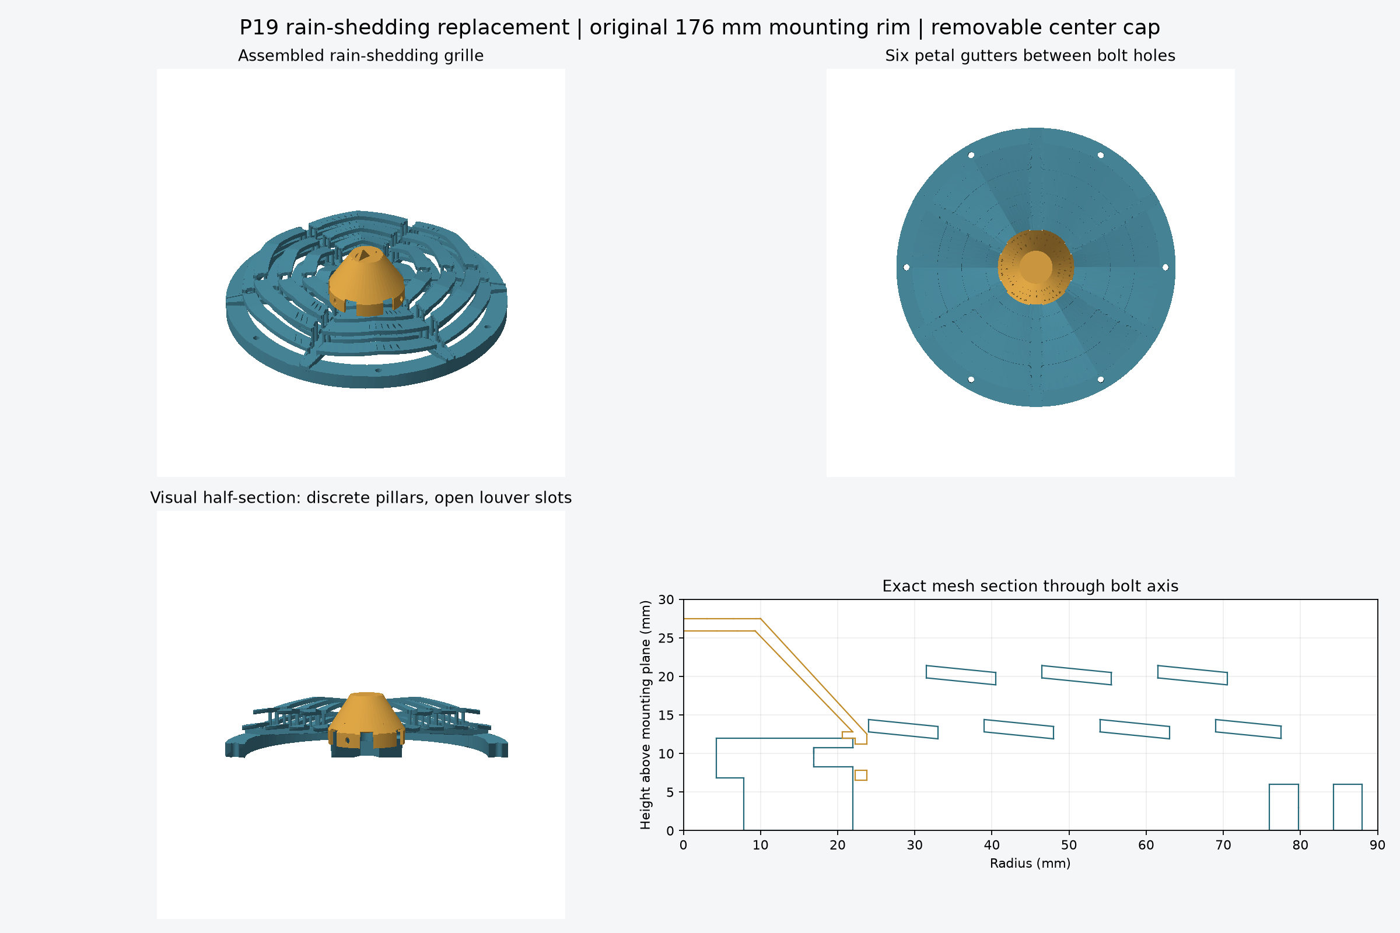
experiments/print_petg_12/output/p19_rain/P19_rain_review.png
