joezen777/physicssculptures/experiments/print_petg_12/output/planet_joint_labeled.png

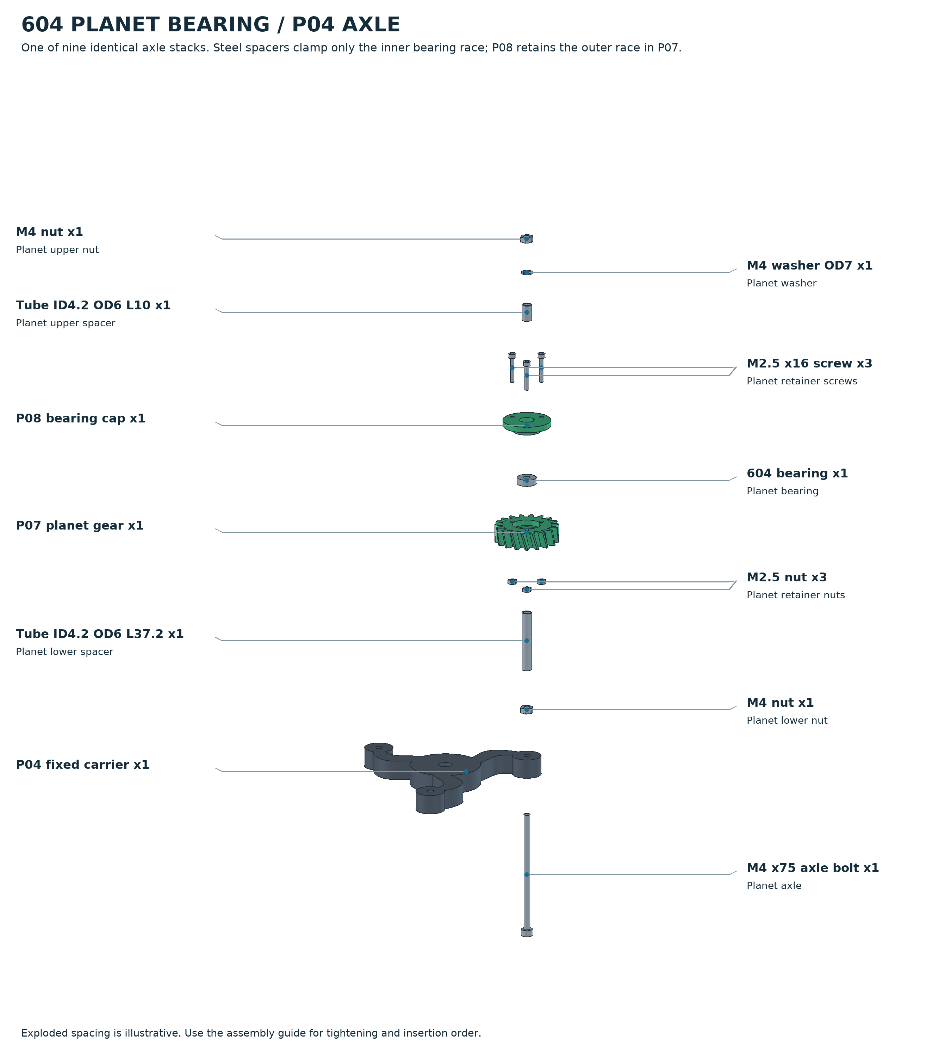
experiments/print_petg_12/output/planet_joint_labeled.png
