joezen777/physicssculptures/experiments/print_petg_12/output/sail_80x120/assembled.png

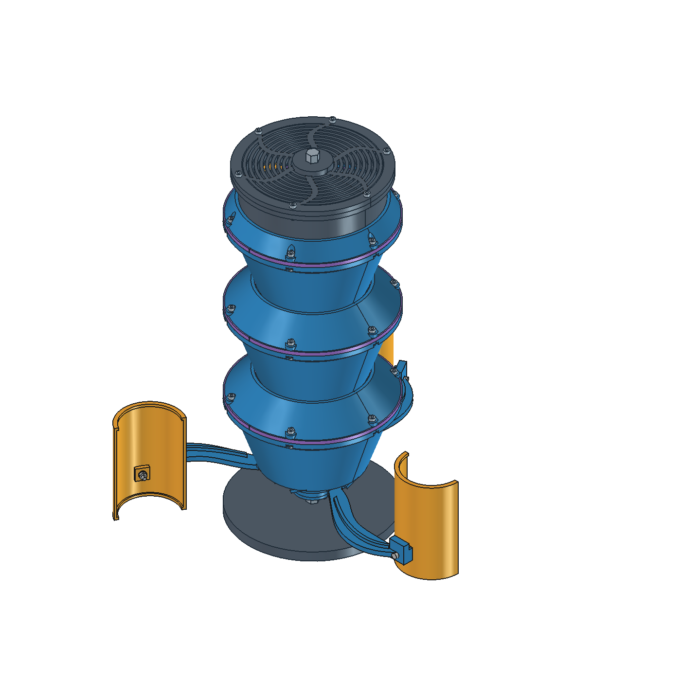
experiments/print_petg_12/output/sail_80x120/assembled.png
