joezen777/physicssculptures/experiments/print_petg_12/output/scimitar_40mm/guard_fit.png

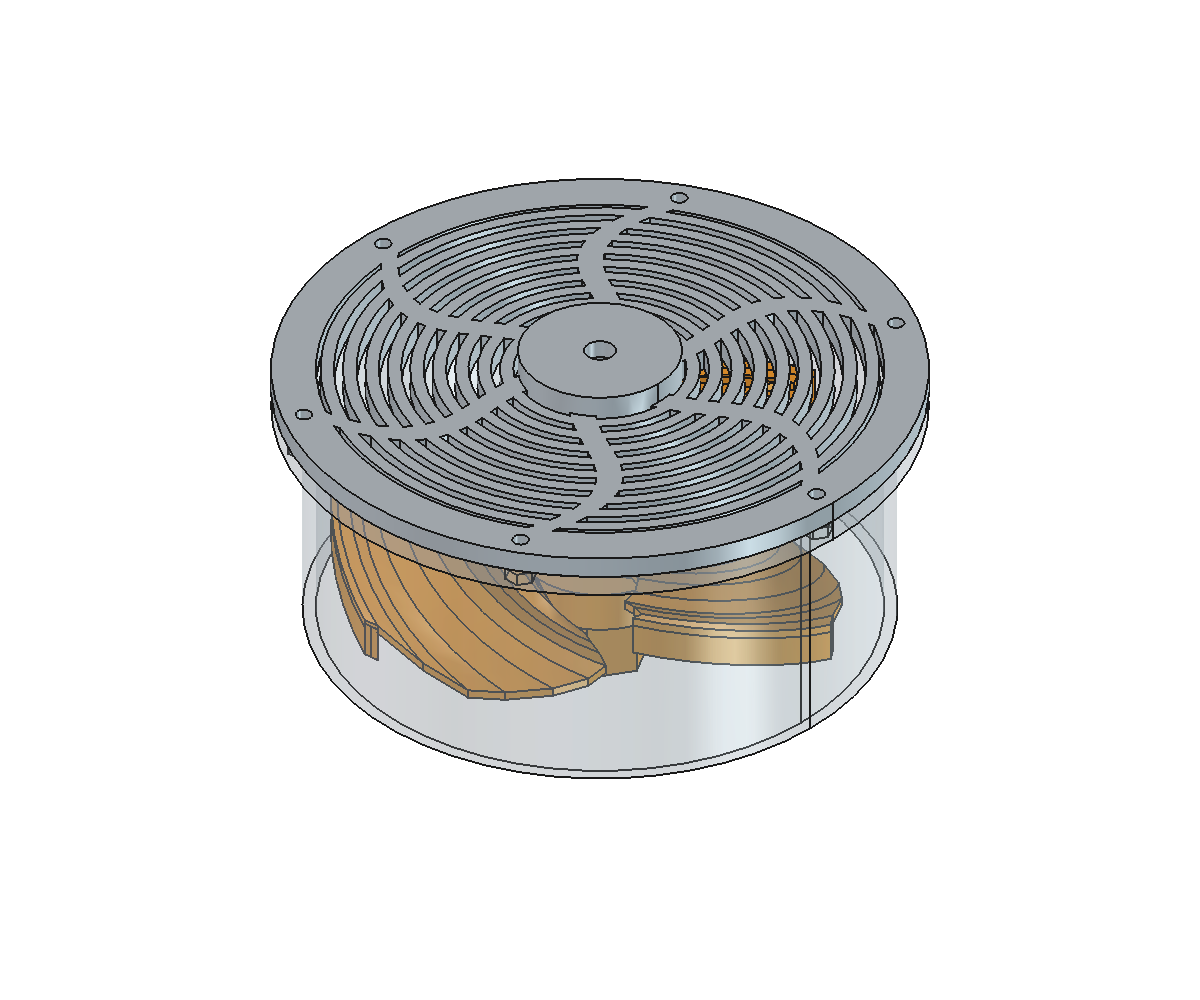
experiments/print_petg_12/output/scimitar_40mm/guard_fit.png
