joezen777/physicssculptures/experiments/print_petg_12/output/scimitar_40mm/rotor_top.png

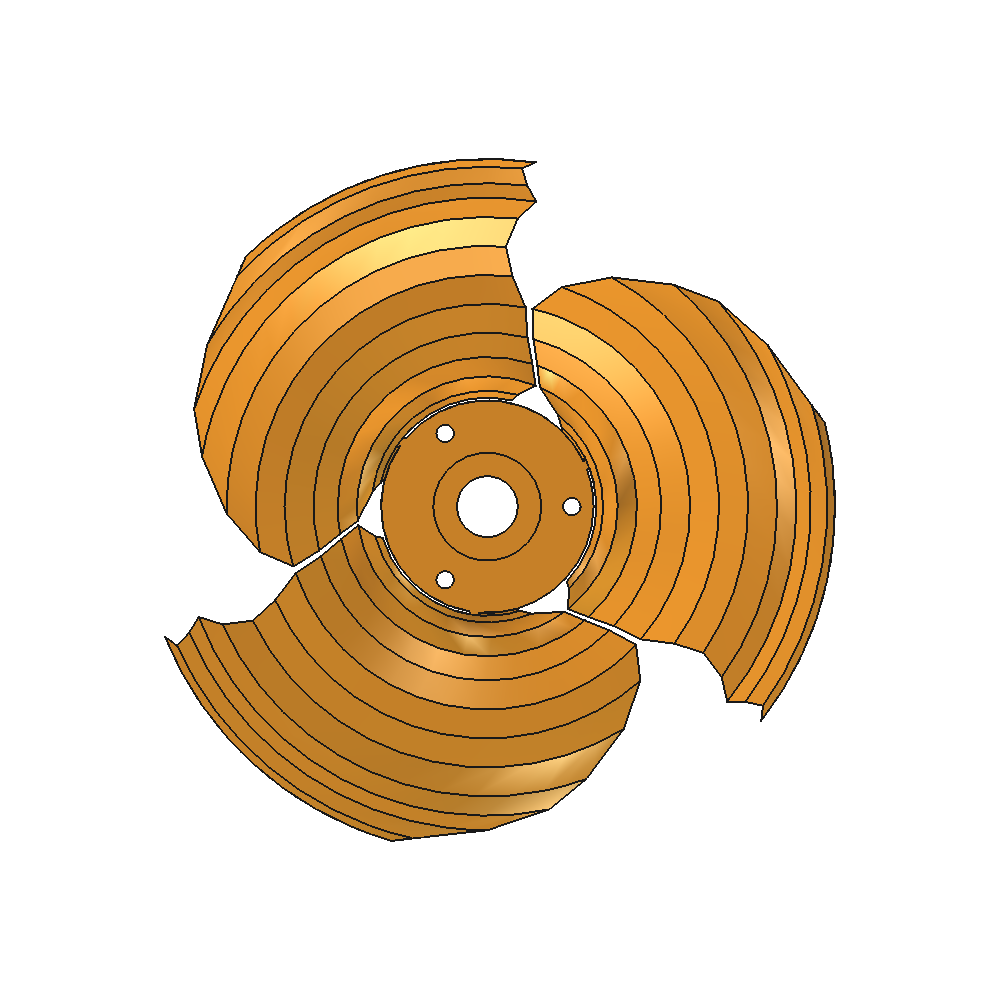
experiments/print_petg_12/output/scimitar_40mm/rotor_top.png
