joezen777/physicssculptures/experiments/print_petg_12/output/sun_housing_dovetails.png

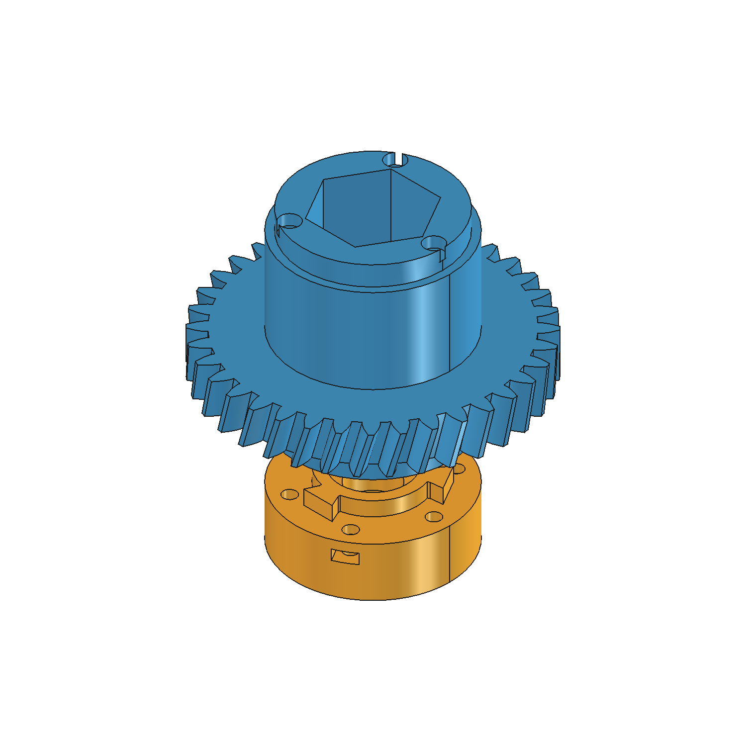
experiments/print_petg_12/output/sun_housing_dovetails.png
