joezen777/physicssculptures/experiments/print_petg_12/output/toroidal5_final/cura_support_toolpaths.png

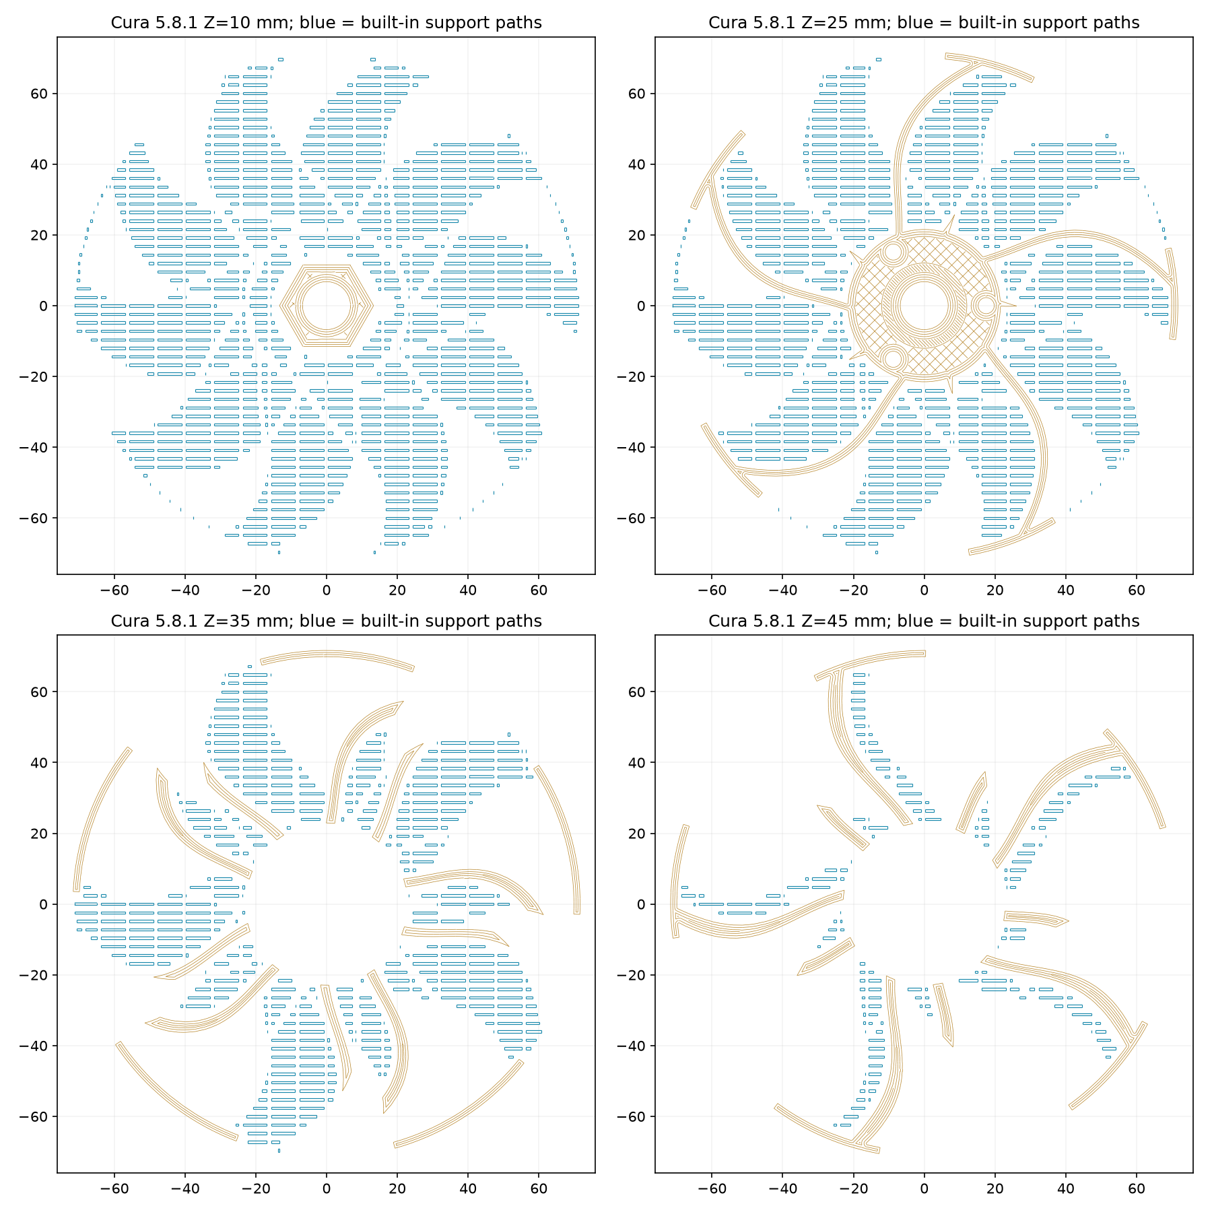
experiments/print_petg_12/output/toroidal5_final/cura_support_toolpaths.png
