joezen777/physicssculptures/experiments/print_petg_12/output/toroidal5_final/toroidal5_print_preview.png

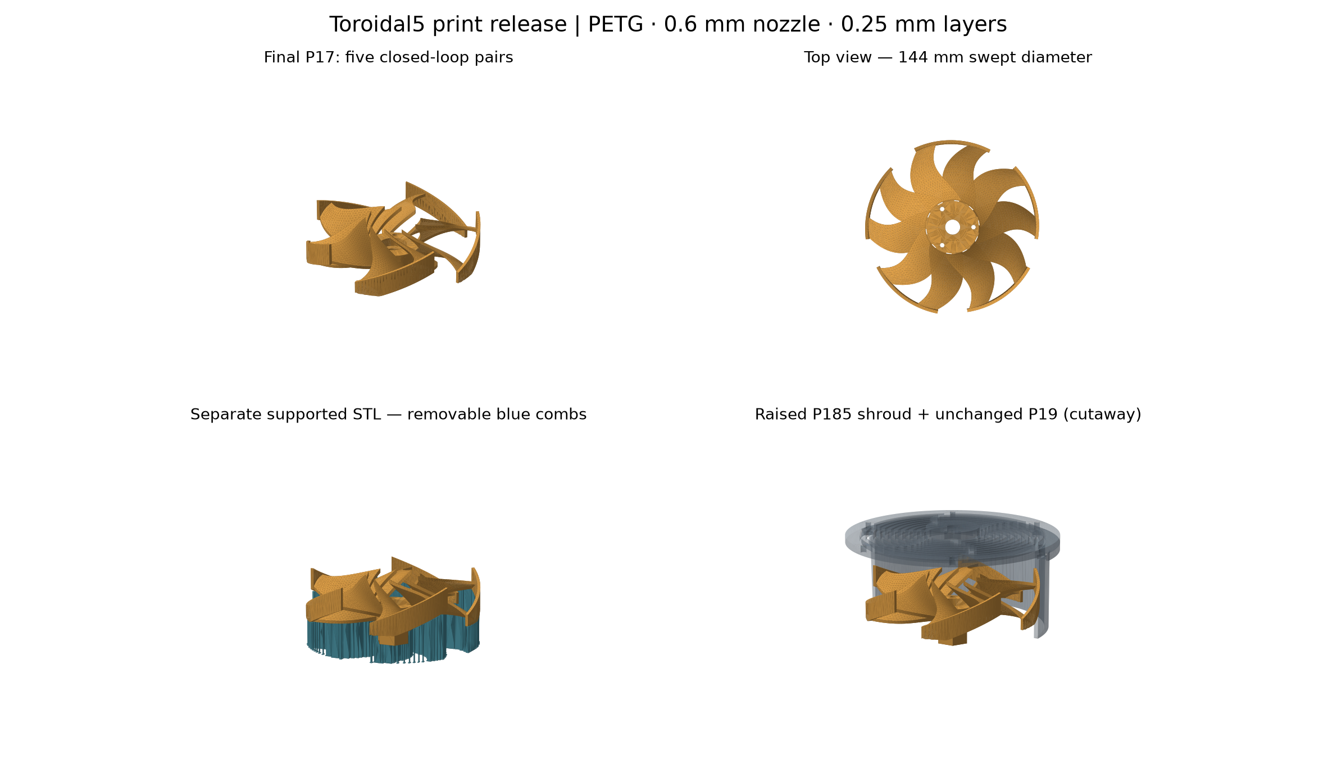
experiments/print_petg_12/output/toroidal5_final/toroidal5_print_preview.png
