joezen777/physicssculptures/experiments/cfd400/results/original_coarse_flow.csv

iteration | flow_L_s
50.0 | 3.5387075124154905
100.0 | 4.099425869519691
150.0 | 4.036637736824811
200.0 | 4.391356885744992
250.0 | 4.03013724971747
300.0 | 2.298931431502196
350.0 | 0.26258112218151475
400.0 | -1.2379697548077802
450.0 | -1.6238273718388834
500.0 | -2.0996590343658132
550.0 | -2.2839079638389737
600.0 | -2.0220939472183024
650.0 | -1.9155662359111798
700.0 | -1.5996967778217877
750.0 | -0.961832069445347
800.0 | -0.24203750845252023
850.0 | 0.46490898599965963
900.0 | 1.1057569867770054
950.0 | 1.30045331579374
1000.0 | 0.8717749429621051
