joezen777/physicssculptures/experiments/cfd400/results/original_coarse_torque.csv

iteration | torque_Nm
1.0 | 8.342690187e-05
2.0 | 0.0009404754288
3.0 | 0.001493203744
4.0 | 0.001720962001
5.0 | 0.001674317815
6.0 | 0.001433476874
7.0 | 0.001091171147
8.0 | 0.0007369621938
9.0 | 0.0004372404629
10.0 | 0.0002280579084
11.0 | 0.0001208827376
12.0 | 0.0001050699219
13.0 | 0.0001575614783
14.0 | 0.000250674938
15.0 | 0.0003573753784
16.0 | 0.0004559880772
17.0 | 0.0005327204211
18.0 | 0.000580681841
19.0 | 0.0005990507729
20.0 | 0.0005930622152
21.0 | 0.0005701603642
22.0 | 0.0005369158829
23.0 | 0.000500381998
24.0 | 0.0004664663991
25.0 | 0.0004390719132
26.0 | 0.0004201017176
27.0 | 0.0004096484786
28.0 | 0.0004064136091
29.0 | 0.0004084175915
30.0 | 0.0004130862281
31.0 | 0.0004189936981
32.0 | 0.0004245769724
33.0 | 0.0004286115813
34.0 | 0.0004303646305
35.0 | 0.000429667682
36.0 | 0.0004267446466
37.0 | 0.0004220835243
38.0 | 0.0004163351358
39.0 | 0.0004101631962
40.0 | 0.0004038258426
41.0 | 0.0003982053713
42.0 | 0.0003938377766
43.0 | 0.0003904613532
44.0 | 0.0003880271436
45.0 | 0.0003863794394
46.0 | 0.0003852582086
47.0 | 0.0003844359032
48.0 | 0.000383655525
49.0 | 0.0003827752617
50.0 | 0.0003817407618
51.0 | 0.000380487352
52.0 | 0.0003790462252
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
