joezen777/physicssculptures/experiments/cfd400/results/original_fine_flow.csv

iteration | flow_L_s
50.0 | 2.983265676091045
100.0 | 3.925393208501696
150.0 | 4.422366731505819
200.0 | 4.687927314841244
250.0 | 4.804349121059046
300.0 | 4.830970374530789
350.0 | 4.76297334493836
400.0 | 4.7870736232865205
450.0 | 4.8261434462484765
500.0 | 4.702077956371624
550.0 | 4.640367154097575
600.0 | 4.64392567876389
650.0 | 4.284754272796016
700.0 | 3.4173526306010498
750.0 | 2.3217778512179446
800.0 | 1.3609727819809398
850.0 | 0.17731128514340216
900.0 | -1.0027337465115798
950.0 | -1.8608458530181837
1000.0 | -2.2754053947559507
