joezen777/physicssculptures/experiments/cfd400/results/original_fine_torque.csv

iteration | torque_Nm
1.0 | 0.0001867008042
2.0 | 0.001499773626
3.0 | 0.002307223029
4.0 | 0.002574040777
5.0 | 0.002392815056
6.0 | 0.001894039638
7.0 | 0.001248558091
8.0 | 0.0006093769279
9.0 | 9.152288347e-05
10.0 | -0.0002409417995
11.0 | -0.0003773489902
12.0 | -0.000342589966
13.0 | -0.0001811827092
14.0 | 4.854479833e-05
15.0 | 0.0002899714448
16.0 | 0.000498761186
17.0 | 0.0006482754458
18.0 | 0.000727986029
19.0 | 0.0007414563017
20.0 | 0.0007044529009
21.0 | 0.0006358250347
22.0 | 0.0005550277672
23.0 | 0.0004786308737
24.0 | 0.0004180013974
25.0 | 0.0003789746145
26.0 | 0.0003621486122
27.0 | 0.0003638742377
28.0 | 0.0003784534988
29.0 | 0.0004027169296
30.0 | 0.0004277435783
31.0 | 0.0004514728261
32.0 | 0.0004721559276
33.0 | 0.0004884667522
34.0 | 0.0004995142942
35.0 | 0.0005049243423
36.0 | 0.0005050149841
37.0 | 0.0005004469009
38.0 | 0.0004914896522
39.0 | 0.0004796395238
40.0 | 0.0004661229677
41.0 | 0.0004521192421
42.0 | 0.000439406158
43.0 | 0.0004272939815
44.0 | 0.0004172849165
45.0 | 0.0004098472175
46.0 | 0.0004051882139
47.0 | 0.0004032494182
48.0 | 0.0004037508104
49.0 | 0.0004062406465
50.0 | 0.0004101606012
51.0 | 0.0004149112838
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
