joezen777/physicssculptures/experiments/cfd400/results/scimitar_coarse_flow.csv

iteration | flow_L_s
50.0 | 3.8614812208063043
100.0 | 5.0517743011136975
150.0 | 5.944617109746426
200.0 | 6.6535899826901135
250.0 | 7.264182170383834
300.0 | 7.8328770036784245
350.0 | 8.270354655668832
400.0 | 8.570716351663272
450.0 | 8.71549435712788
500.0 | 8.681806462872618
550.0 | 8.608605586224357
600.0 | 8.537906298502309
650.0 | 8.25152650236473
700.0 | 7.709450849598701
750.0 | 7.242490287747292
800.0 | 7.007439709351279
850.0 | 6.894818875241299
900.0 | 6.848125077081443
950.0 | 7.050833059920741
1000.0 | 7.169291887460419
