joezen777/physicssculptures/experiments/cfd400/results/scimitar_coarse_torque.csv

iteration | torque_Nm
1.0 | 0.0002314321672
2.0 | 0.002914784155
3.0 | 0.004564051647
4.0 | 0.005088262595
5.0 | 0.004634201715
6.0 | 0.003491245195
7.0 | 0.002025054422
8.0 | 0.0003491609843
9.0 | -0.001133208083
10.0 | -0.002305996919
11.0 | -0.003091500993
12.0 | -0.003453068769
13.0 | -0.003413761835
14.0 | -0.003018743685
15.0 | -0.002332785867
16.0 | -0.001459637312
17.0 | -0.0005040216246
18.0 | 0.0004325321742
19.0 | 0.001264464888
20.0 | 0.001926446682
21.0 | 0.00237340671
22.0 | 0.002583504511
23.0 | 0.002567937778
24.0 | 0.002354883116
25.0 | 0.001983109393
26.0 | 0.00149983281
27.0 | 0.0009696161285
28.0 | 0.0004487285551
29.0 | -1.468724167e-05
30.0 | -0.0003835128579
31.0 | -0.00063015099
32.0 | -0.0007486286545
33.0 | -0.000741735377
34.0 | -0.0006264468431
35.0 | -0.0004234024128
36.0 | -0.0001610729253
37.0 | 0.0001289293667
38.0 | 0.0004161586842
39.0 | 0.00067428087
40.0 | 0.0008825835188
41.0 | 0.001026996651
42.0 | 0.001100757359
43.0 | 0.00110418876
44.0 | 0.001045914365
45.0 | 0.0009373017451
46.0 | 0.0007932237018
47.0 | 0.0006310079864
48.0 | 0.0004674386939
49.0 | 0.0003176594508
50.0 | 0.0001939065322
51.0 | 0.0001047069789
52.0 | 5.466769952e-05
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
