joezen777/physicssculptures/experiments/bevel_cones/output/bevel_detail.png

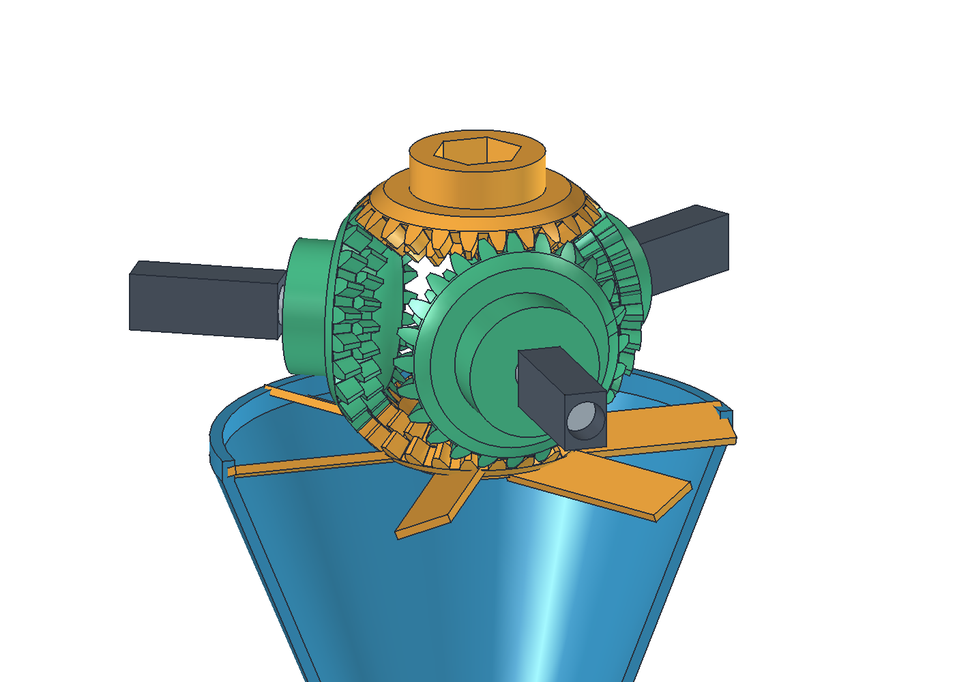
experiments/bevel_cones/output/bevel_detail.png
