joezen777/physicssculptures/experiments/cfd400/geometry/comparison.png

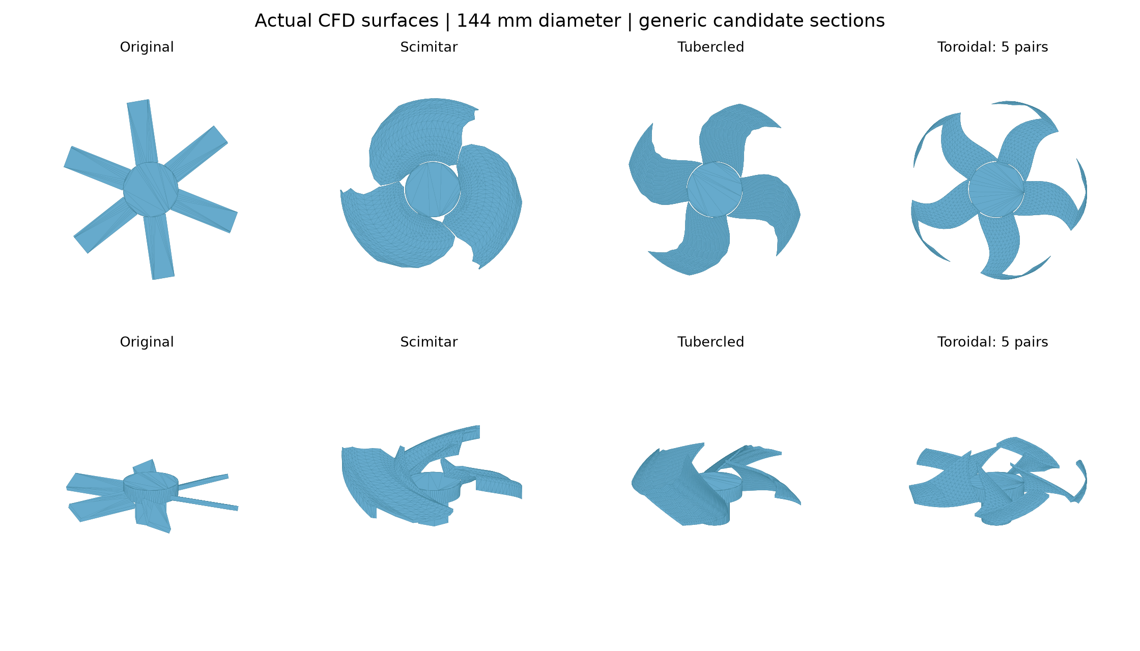
experiments/cfd400/geometry/comparison.png
