joezen777/physicssculptures/experiments/cfd400/results/convergence.png

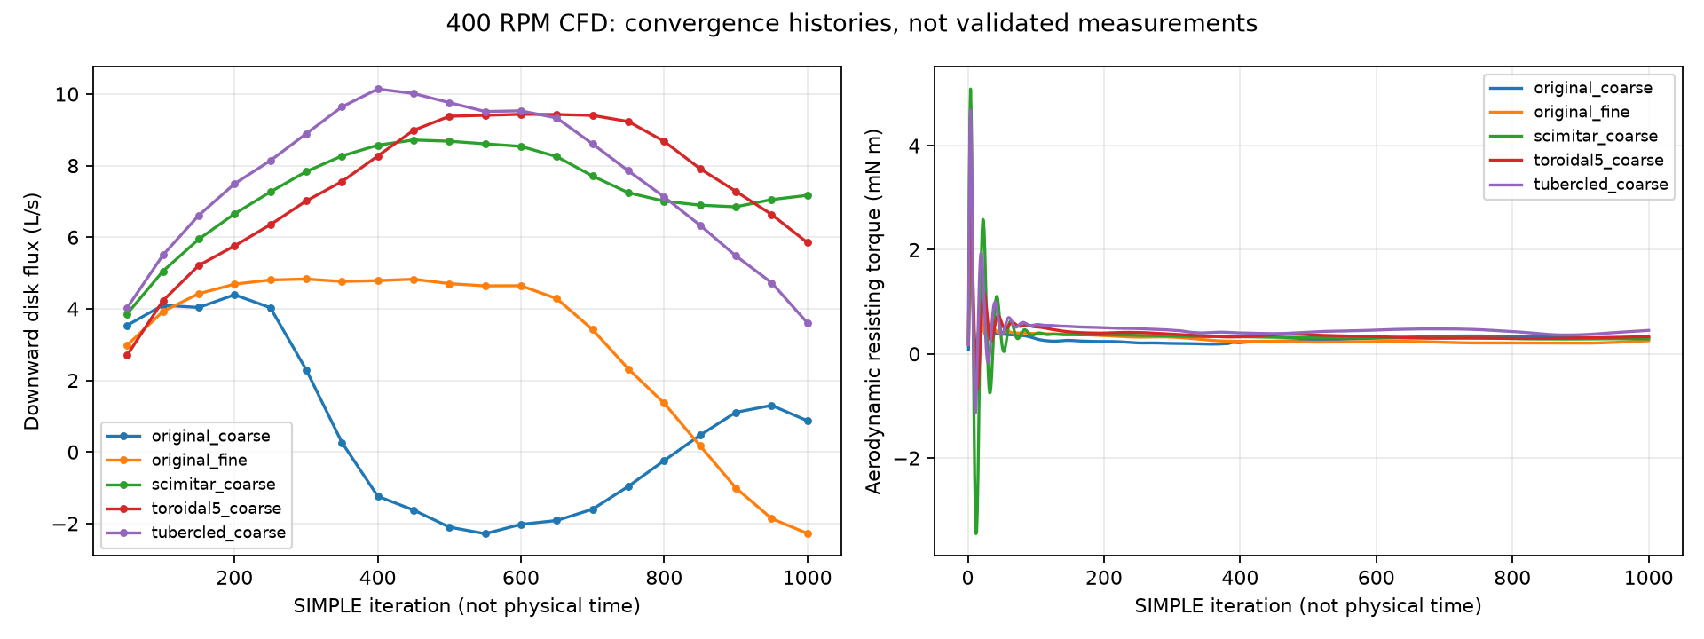
experiments/cfd400/results/convergence.png
