joezen777/physicssculptures/experiments/cfd400/results/downstream_velocity.png

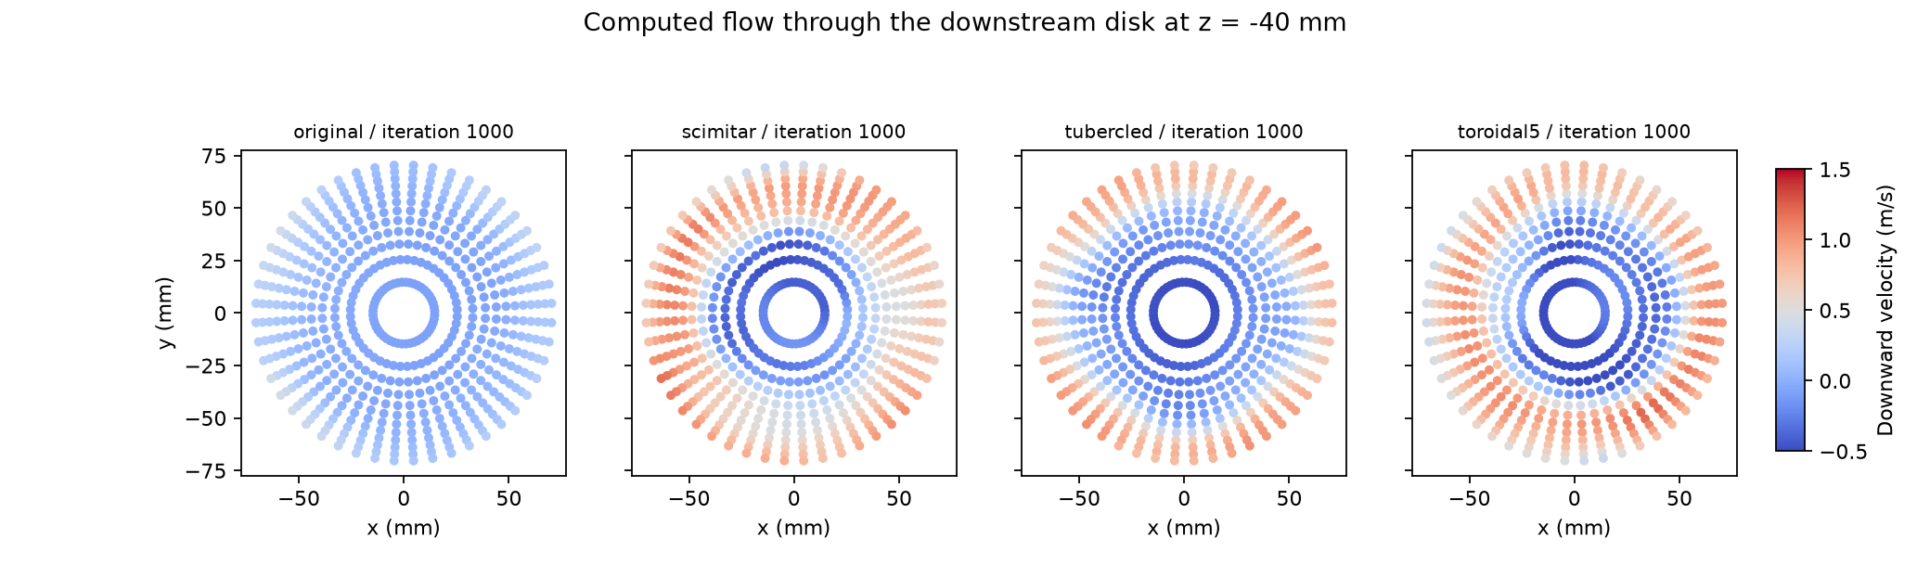
experiments/cfd400/results/downstream_velocity.png
