joezen777/physicssculptures/experiments/drop_gearbox/magnetic_output/gearbox_animation.gif

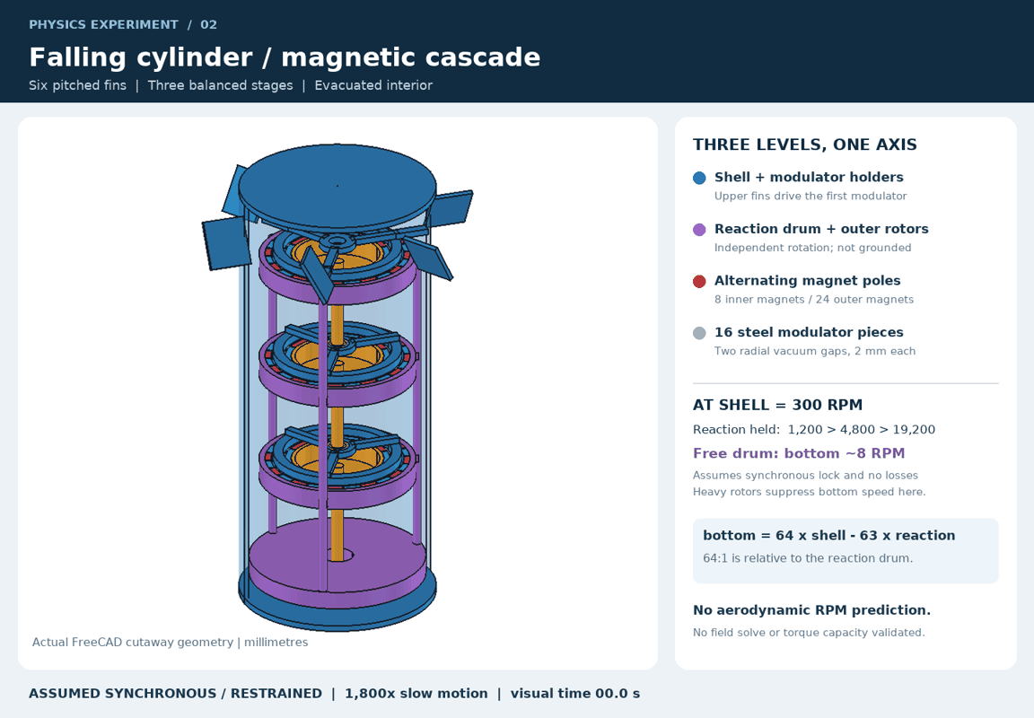
experiments/drop_gearbox/magnetic_output/gearbox_animation.gif
