joezen777/physicssculptures/experiments/drop_gearbox/magnetic_output/magnetic_stage.png

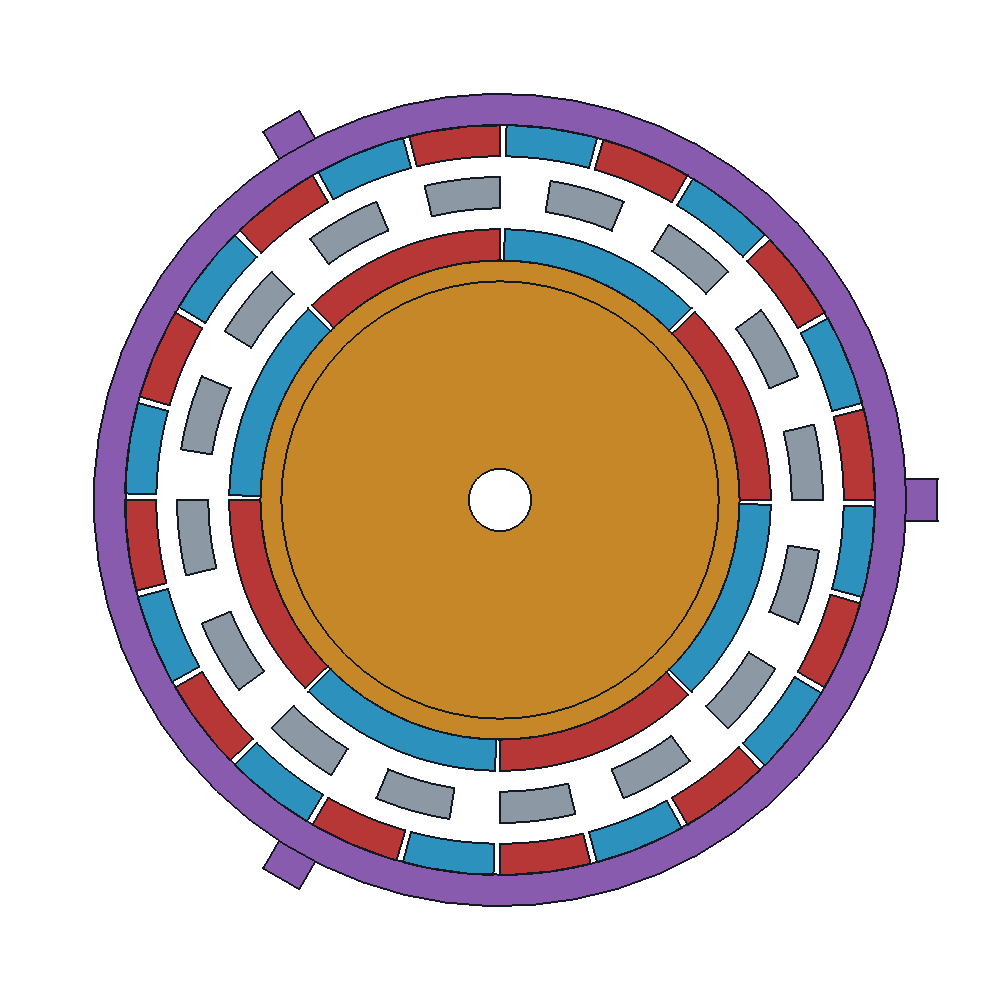
experiments/drop_gearbox/magnetic_output/magnetic_stage.png
