joezen777/physicssculptures/experiments/modular_fan_tunnel/output/cutaway.png

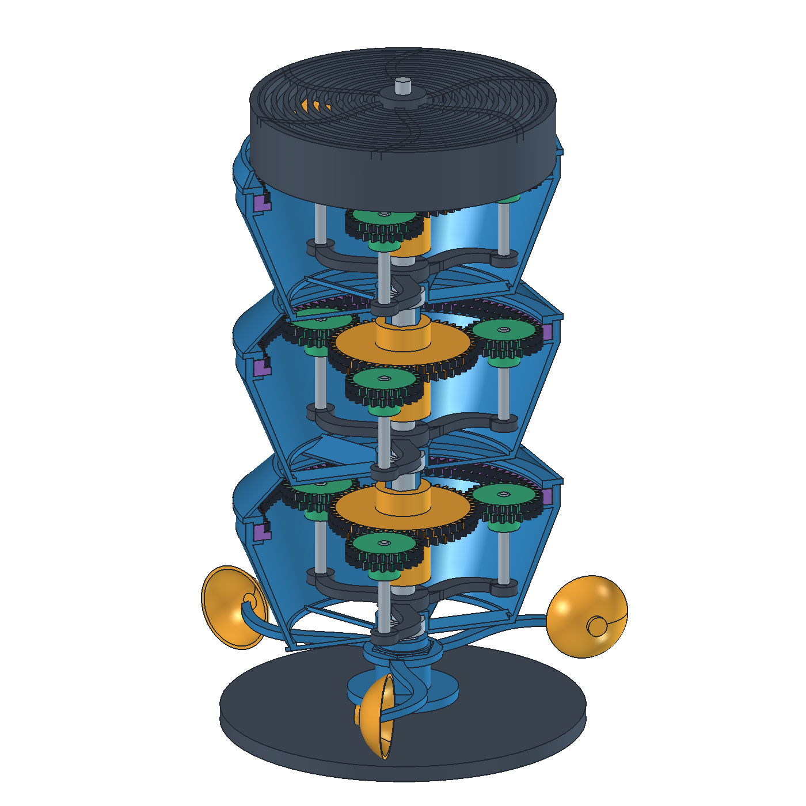
experiments/modular_fan_tunnel/output/cutaway.png
