joezen777/physicssculptures/experiments/modular_fan_tunnel/output/guard_detail.png

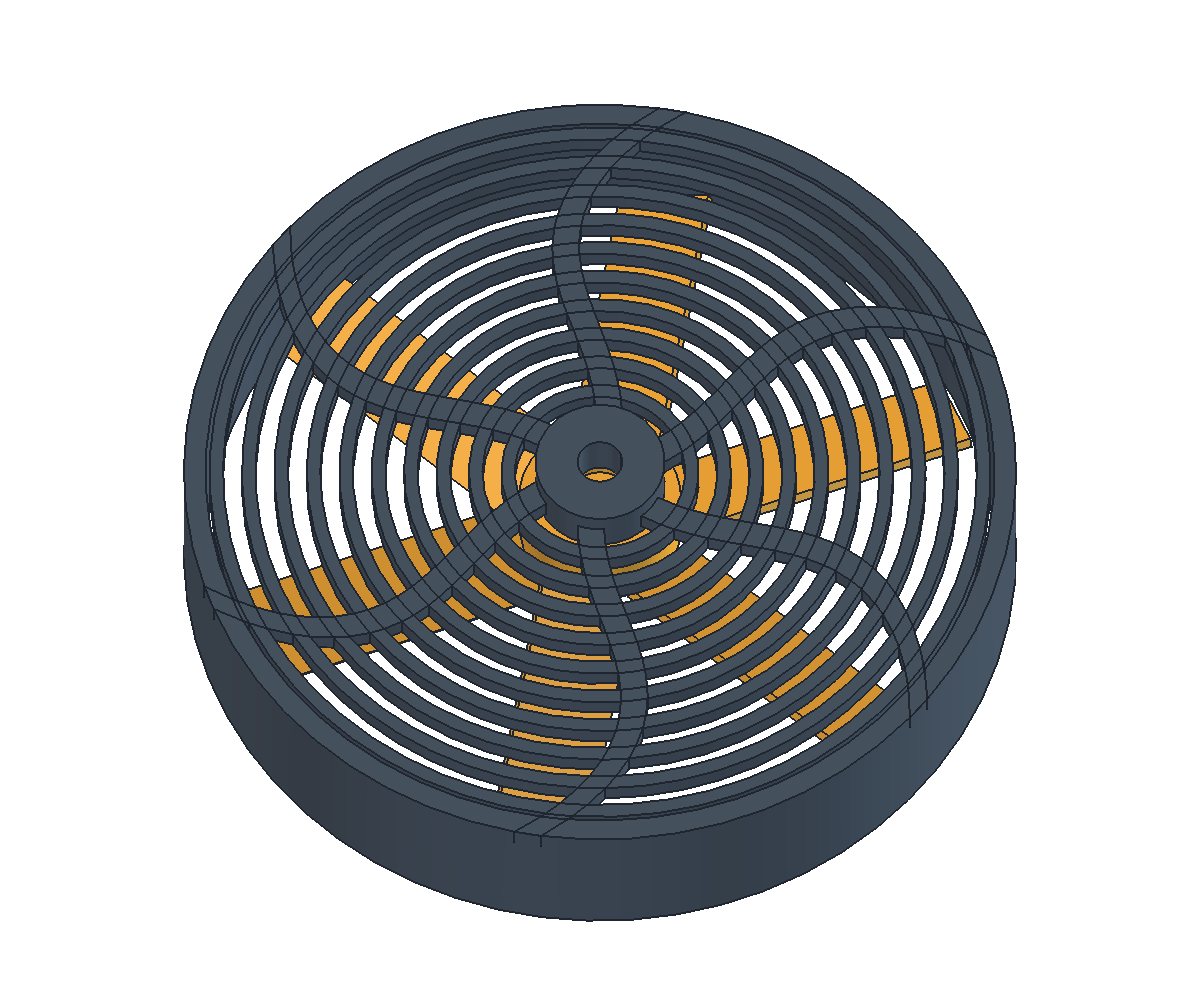
experiments/modular_fan_tunnel/output/guard_detail.png
