joezen777/physicssculptures/experiments/modular_fan_tunnel/output/module_underside.png

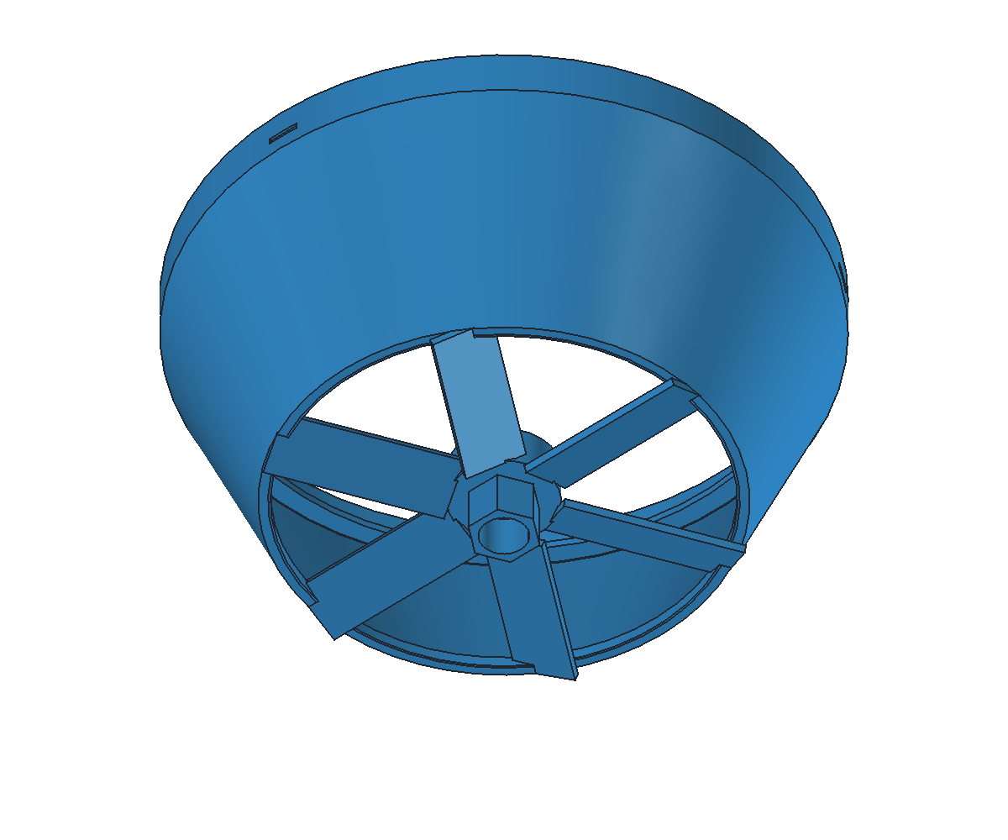
experiments/modular_fan_tunnel/output/module_underside.png
