joezen777/physicssculptures/experiments/modular_fan_tunnel/output/planets_detail.png

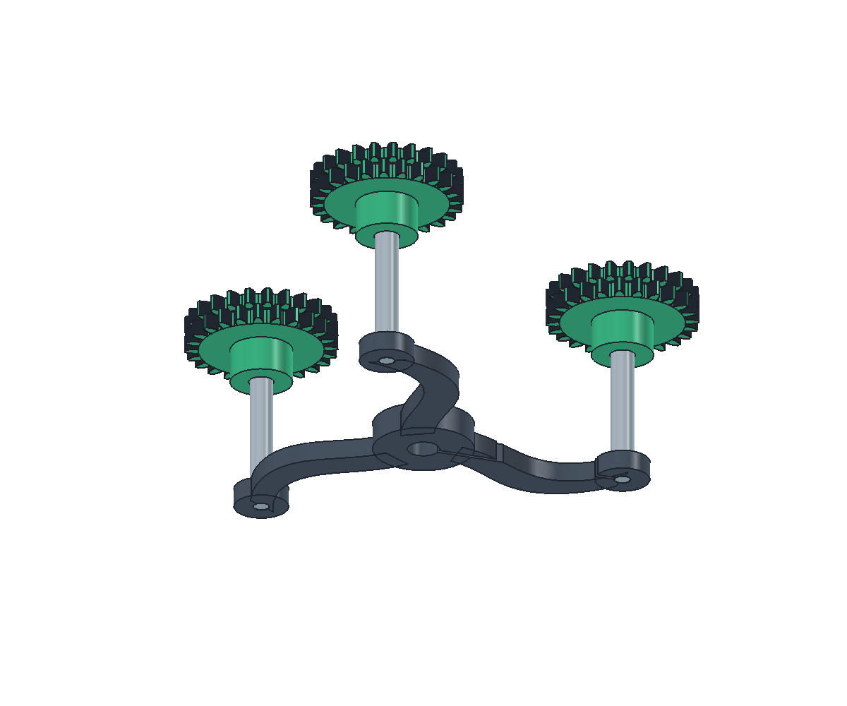
experiments/modular_fan_tunnel/output/planets_detail.png
