joezen777/physicssculptures/experiments/modular_fan_tunnel/output/sails_detail.png

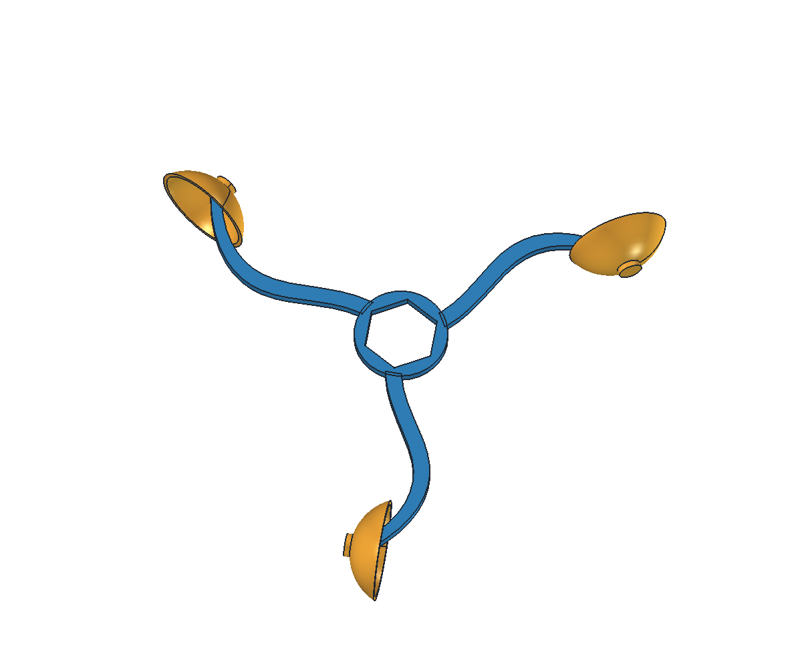
experiments/modular_fan_tunnel/output/sails_detail.png
