joezen777/physicssculptures/experiments/modular_fan_tunnel/output/without_sails.png

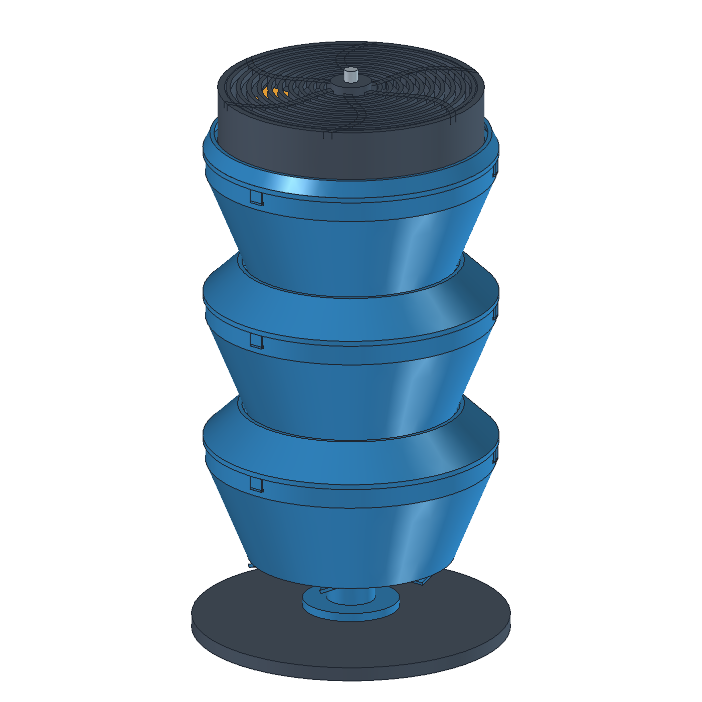
experiments/modular_fan_tunnel/output/without_sails.png
