joezen777/physicssculptures/experiments/pot_zoetrope/output/cone-wrap-preview.png

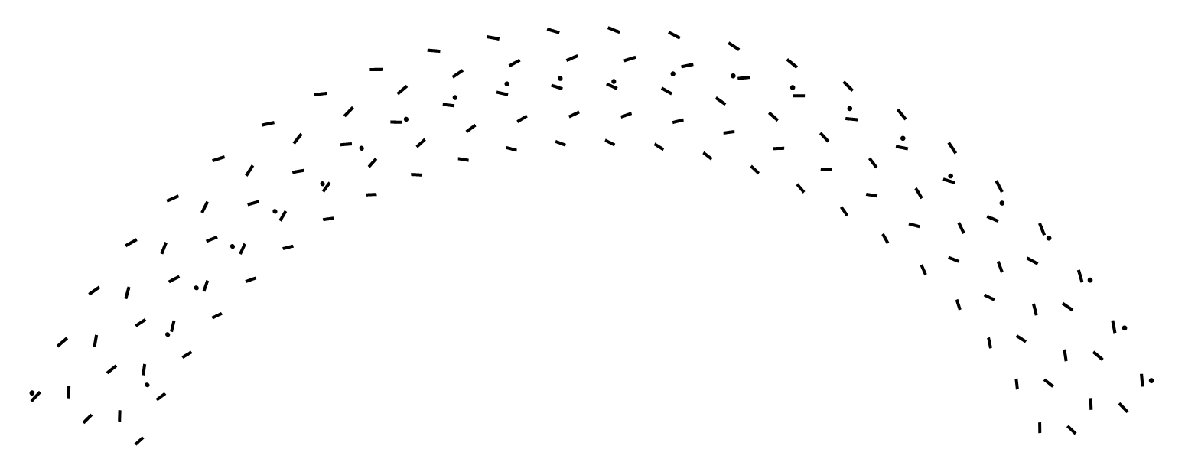
experiments/pot_zoetrope/output/cone-wrap-preview.png
