joezen777/physicssculptures/experiments/pot_zoetrope/output/zoetrope_etch_closeup.png

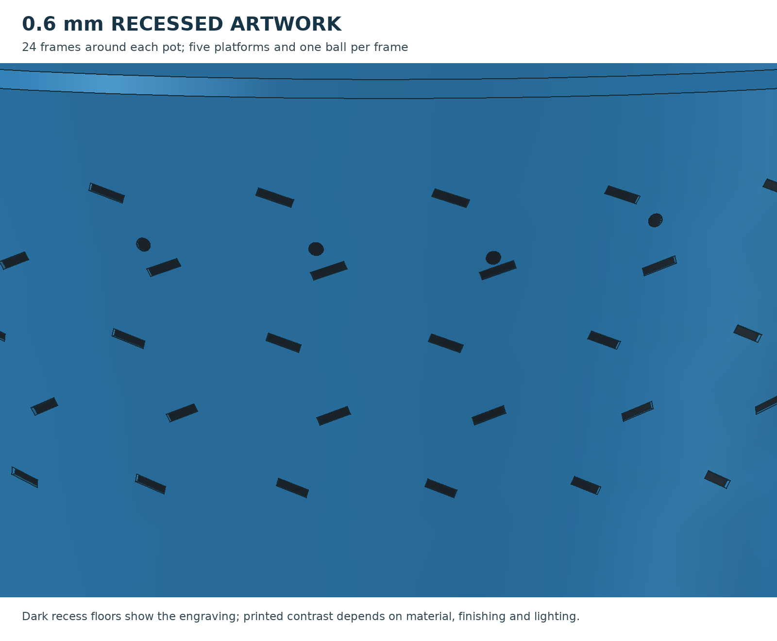
experiments/pot_zoetrope/output/zoetrope_etch_closeup.png
