joezen777/physicssculptures/experiments/pot_zoetrope/output/zoetrope_etch_closeup_raw.png

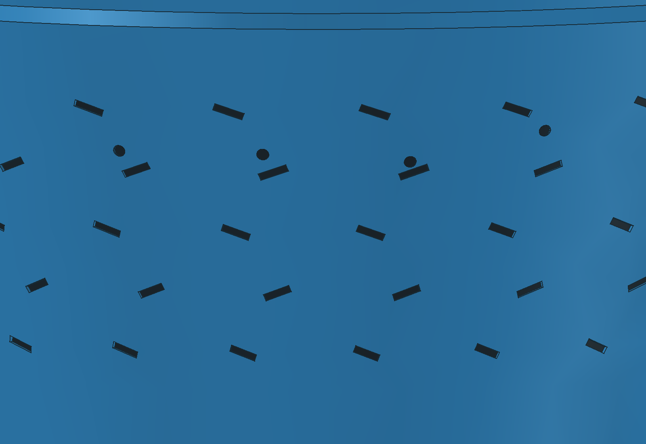
experiments/pot_zoetrope/output/zoetrope_etch_closeup_raw.png
