joezen777/physicssculptures/experiments/pot_zoetrope/output/zoetrope_pots_preview.png

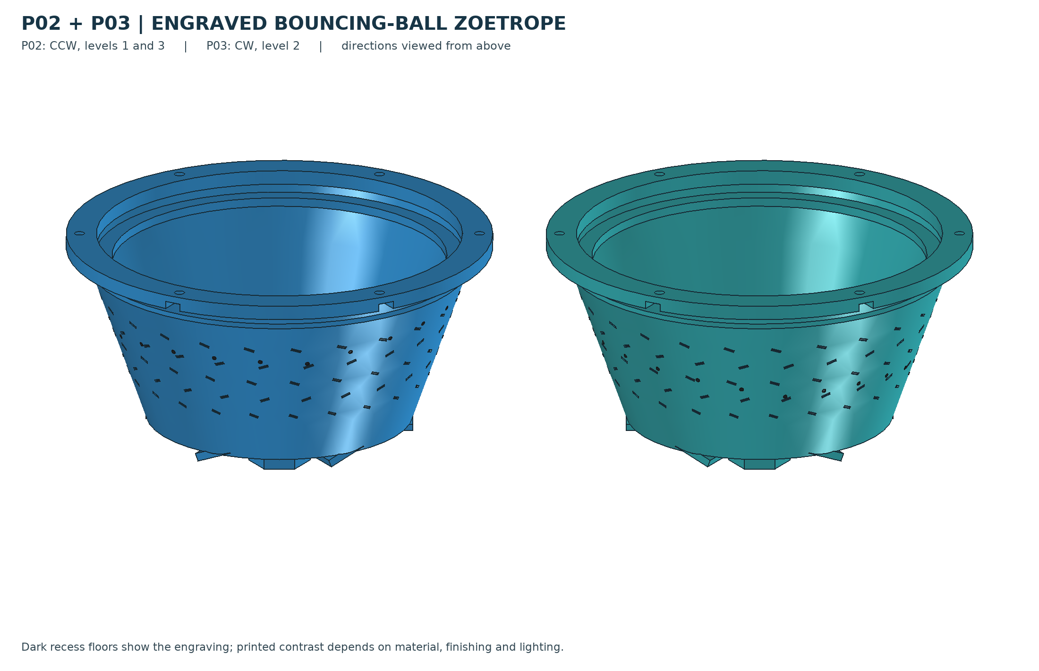
experiments/pot_zoetrope/output/zoetrope_pots_preview.png
