joezen777/physicssculptures/experiments/pot_zoetrope/output/zoetrope_pots_raw.png

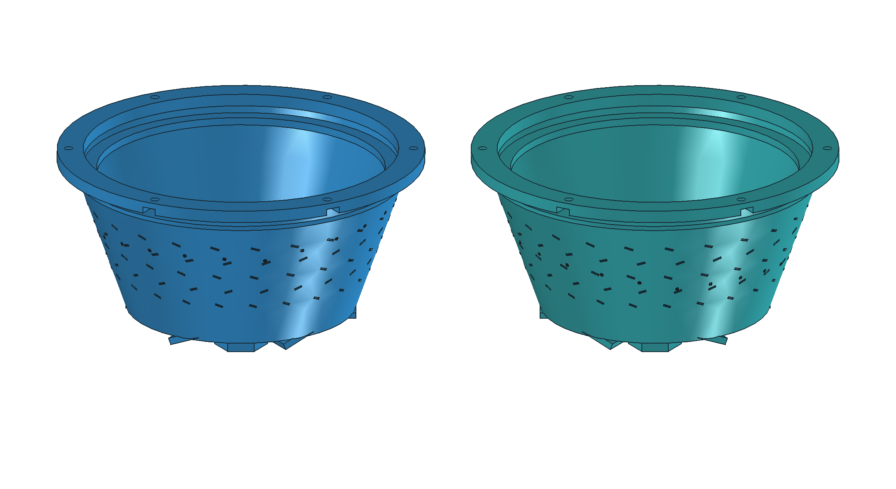
experiments/pot_zoetrope/output/zoetrope_pots_raw.png
