joezen777/physicssculptures/experiments/resin_sprues/previews/R01.png

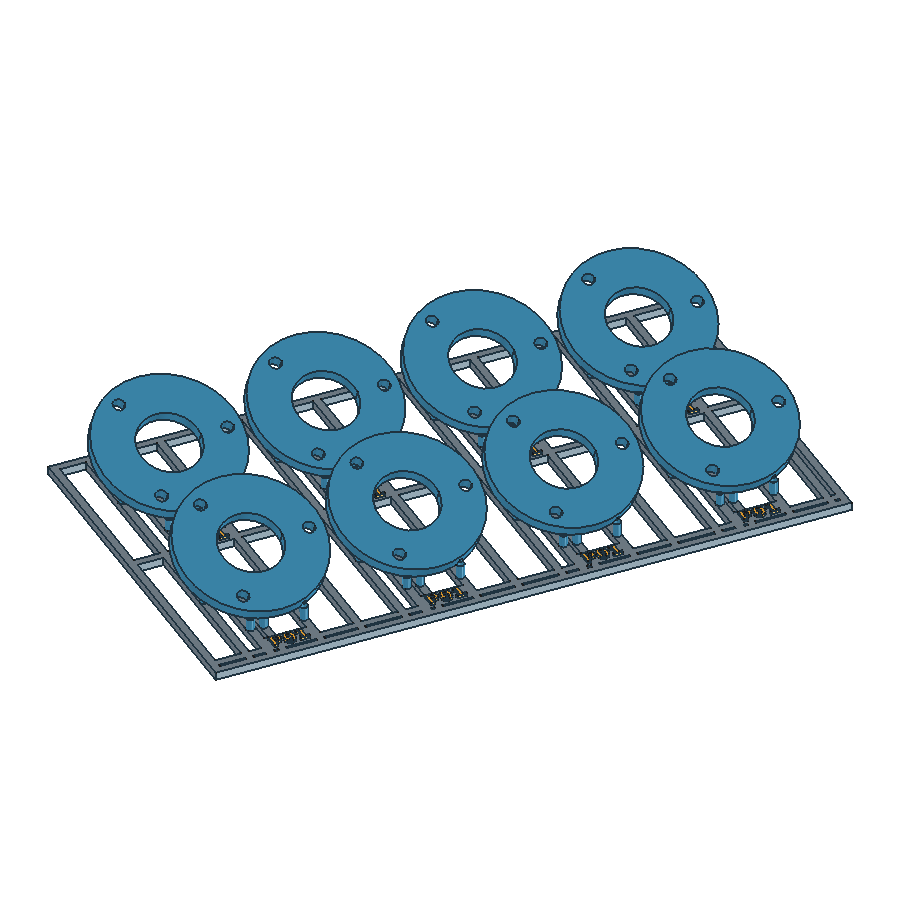
experiments/resin_sprues/previews/R01.png
