joezen777/physicssculptures/experiments/resin_sprues/previews/R02.png

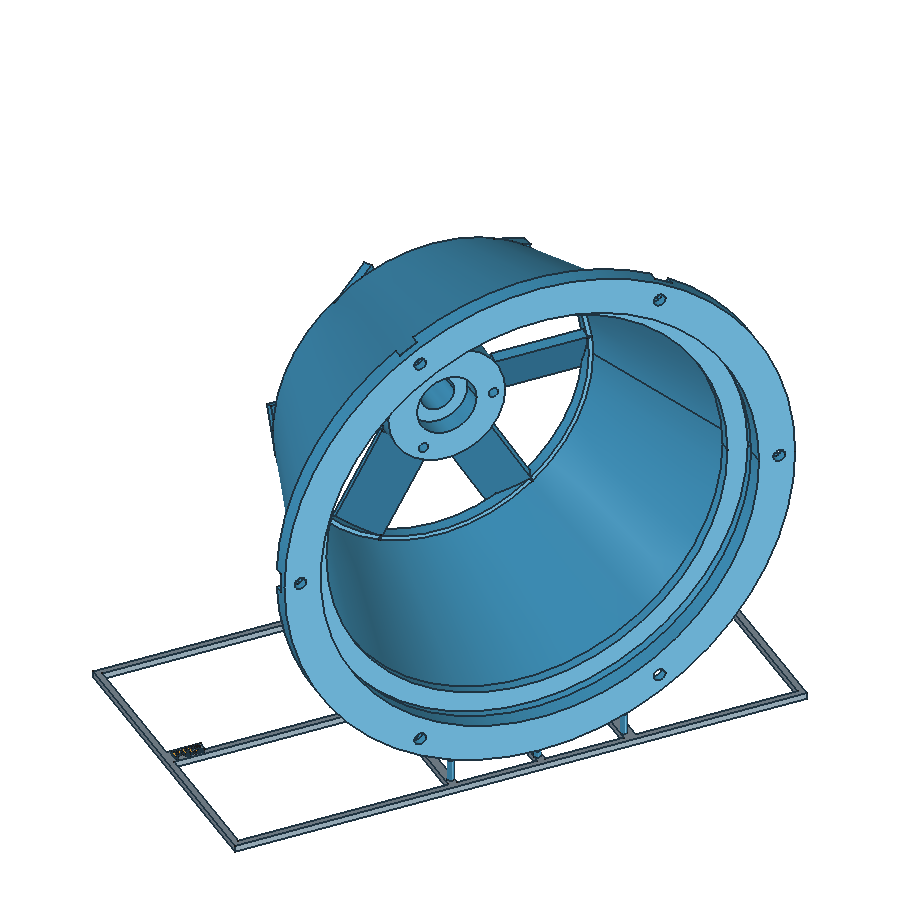
experiments/resin_sprues/previews/R02.png
