joezen777/physicssculptures/experiments/resin_sprues/previews/R04.png

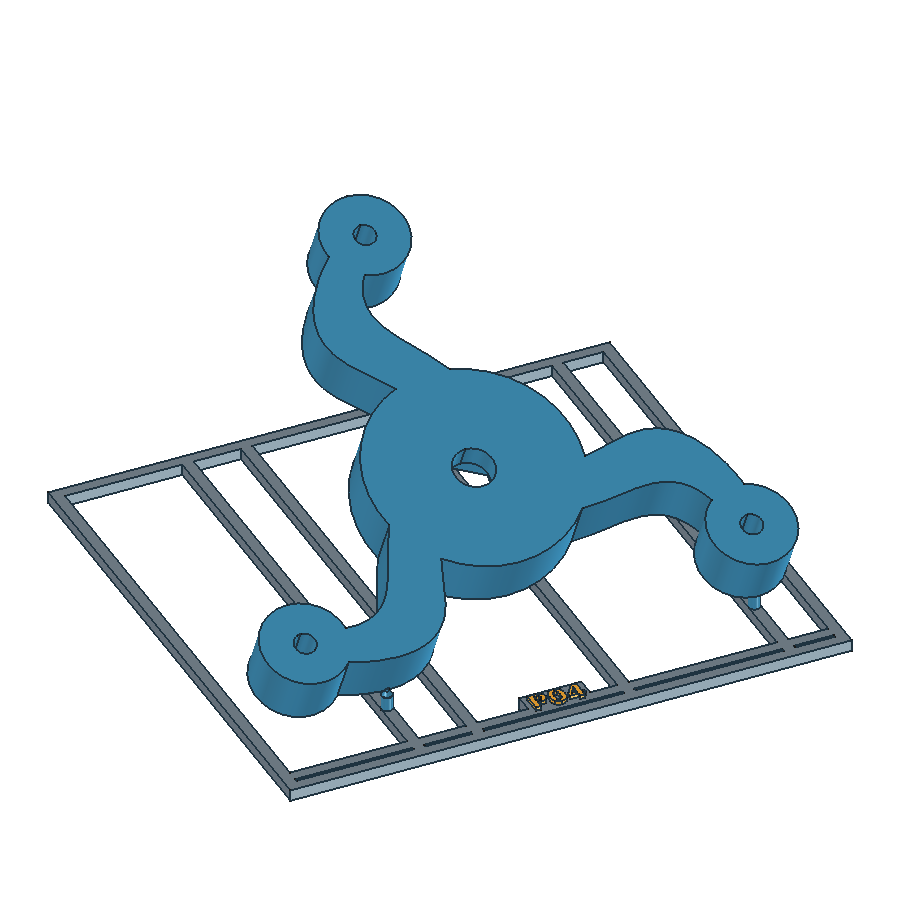
experiments/resin_sprues/previews/R04.png
