joezen777/physicssculptures/experiments/resin_sprues/previews/R05.png

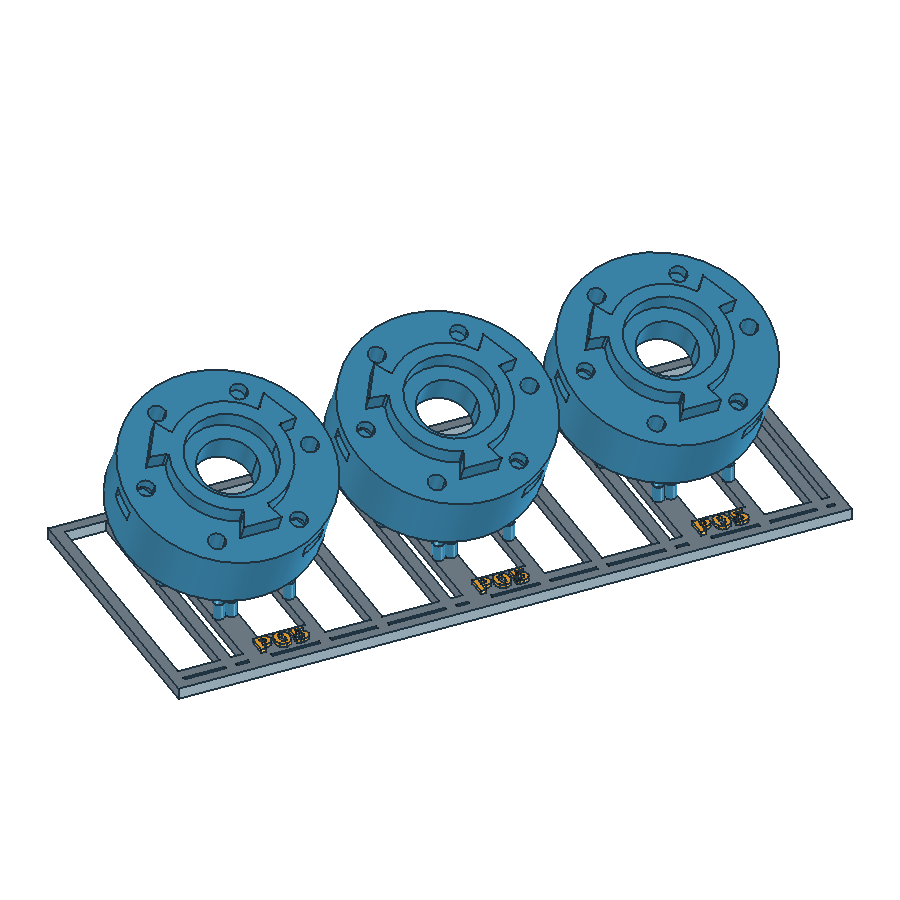
experiments/resin_sprues/previews/R05.png
