joezen777/physicssculptures/experiments/resin_sprues/previews/R06.png

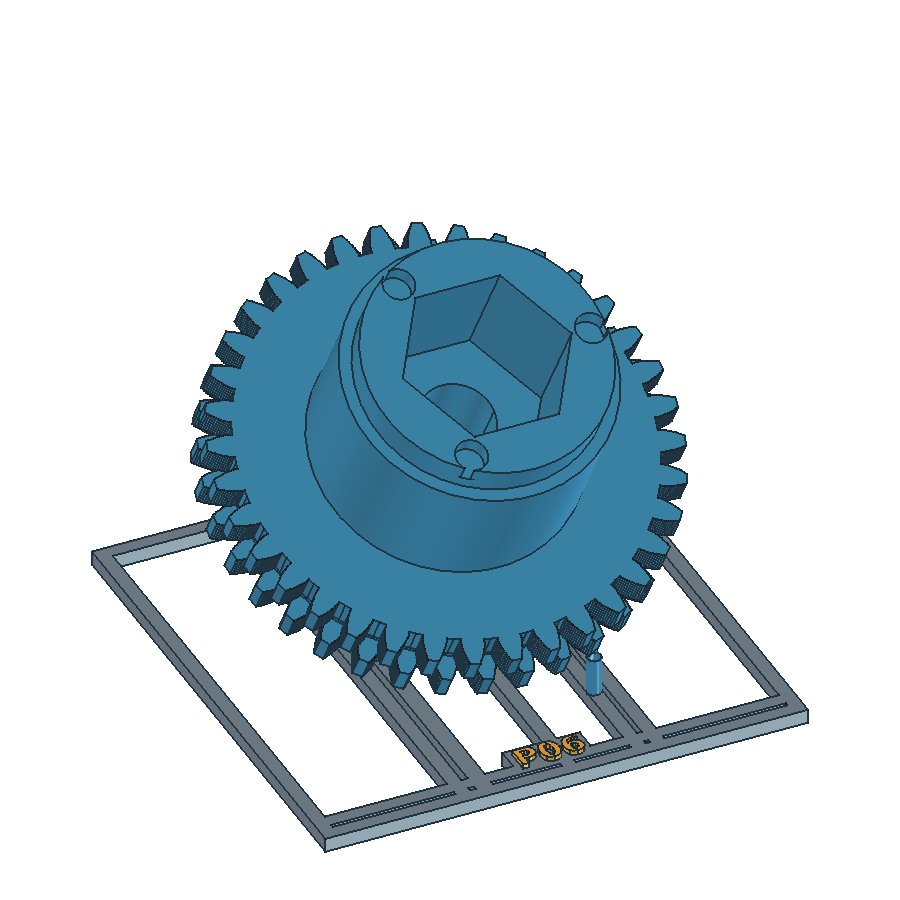
experiments/resin_sprues/previews/R06.png
