joezen777/physicssculptures/experiments/resin_sprues/previews/R07.png

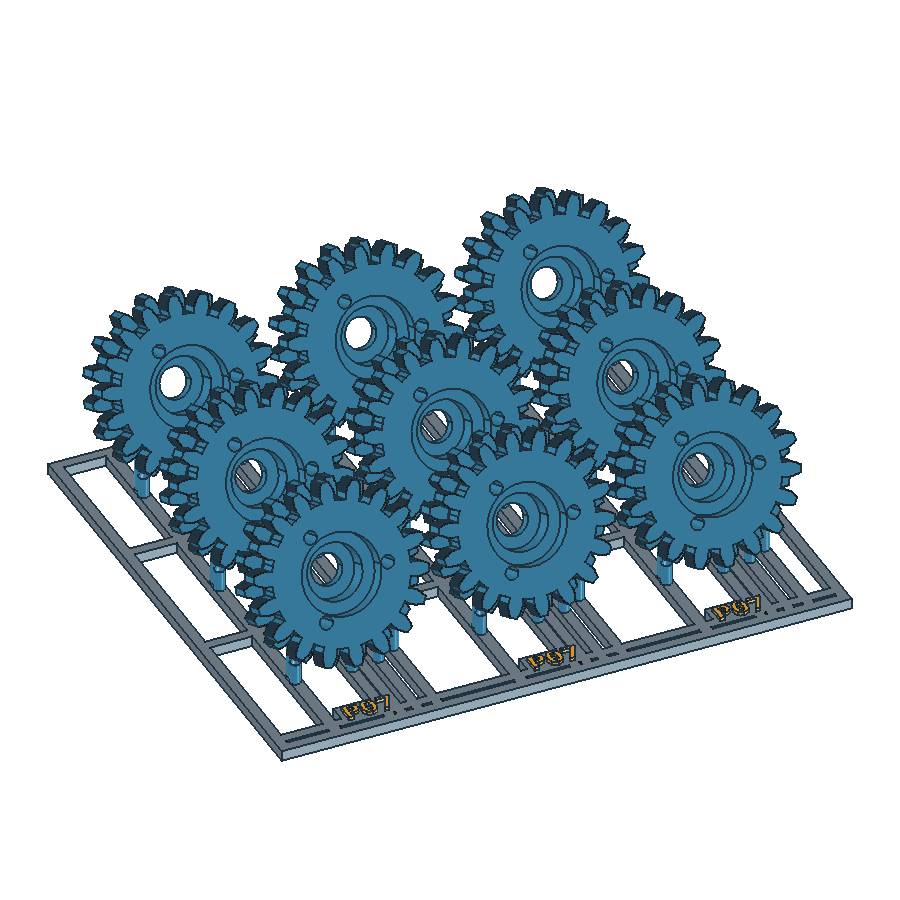
experiments/resin_sprues/previews/R07.png
