joezen777/physicssculptures/experiments/resin_sprues/previews/R08.png

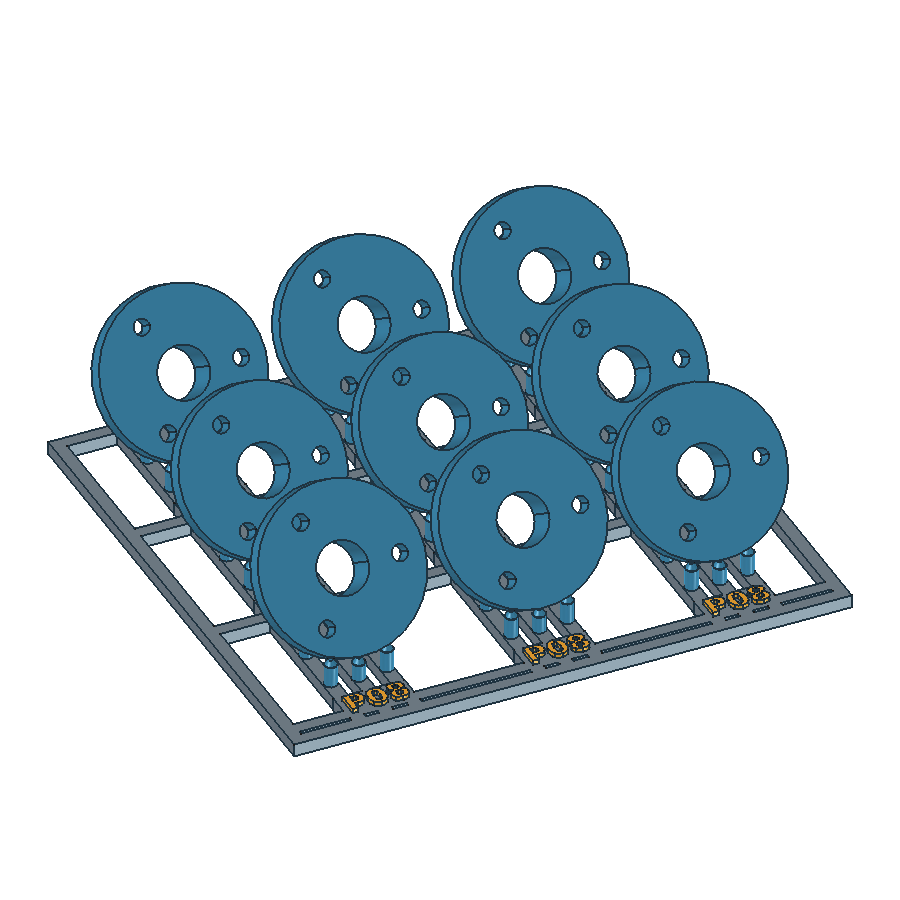
experiments/resin_sprues/previews/R08.png
