joezen777/physicssculptures/experiments/resin_sprues/previews/R09.png

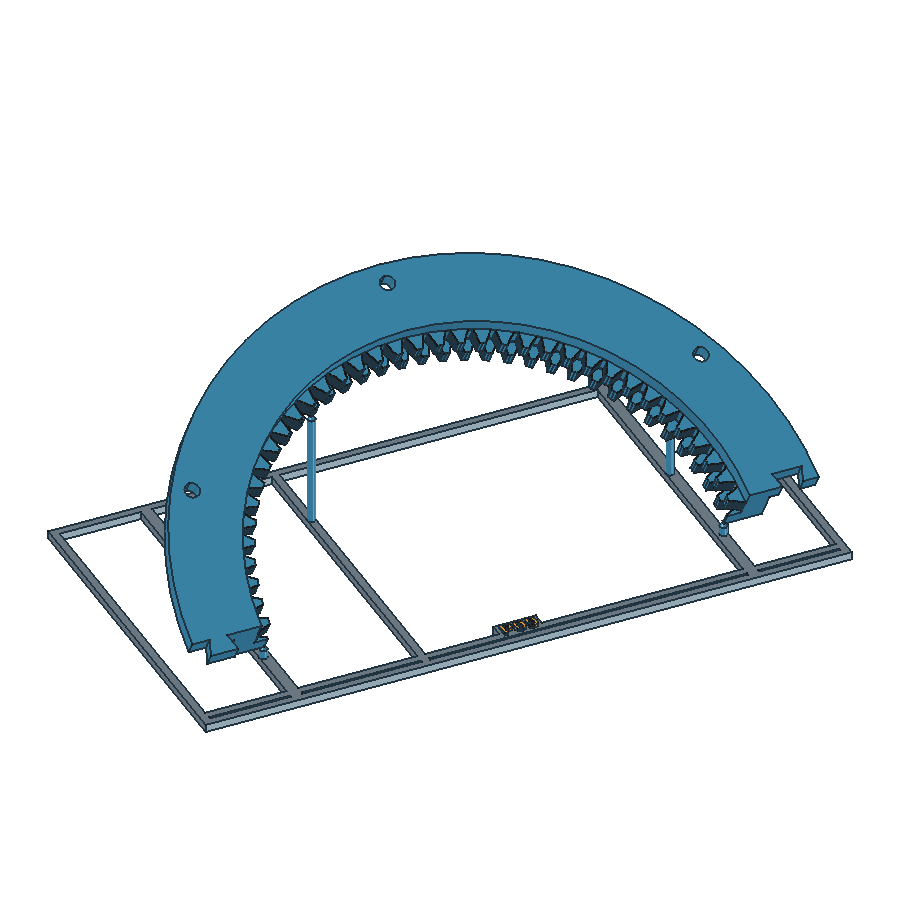
experiments/resin_sprues/previews/R09.png
