joezen777/physicssculptures/experiments/resin_sprues/previews/R10.png

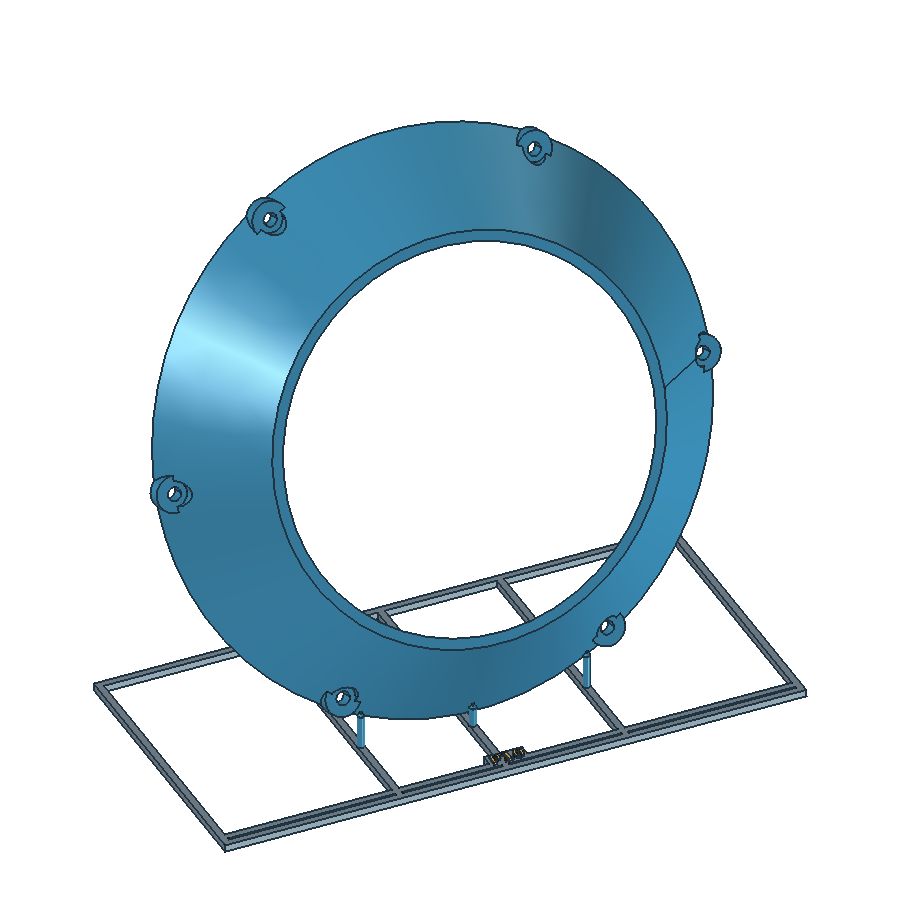
experiments/resin_sprues/previews/R10.png
