joezen777/physicssculptures/experiments/resin_sprues/previews/R11.png

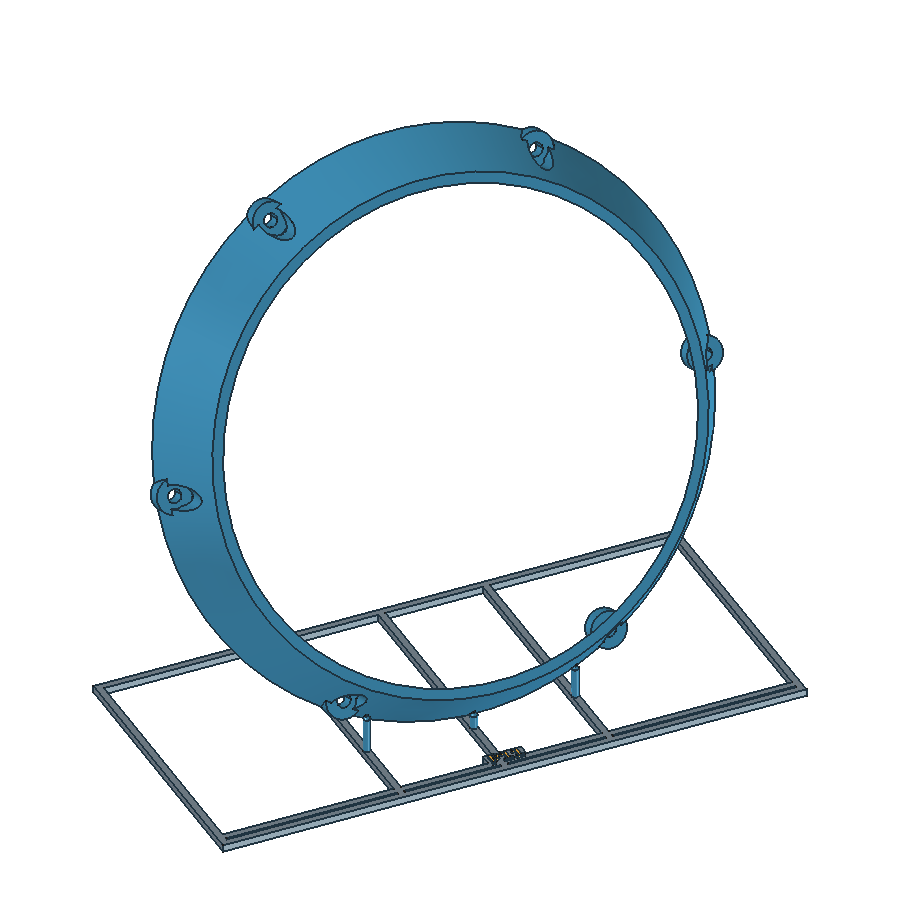
experiments/resin_sprues/previews/R11.png
