joezen777/physicssculptures/experiments/resin_sprues/previews/R12.png

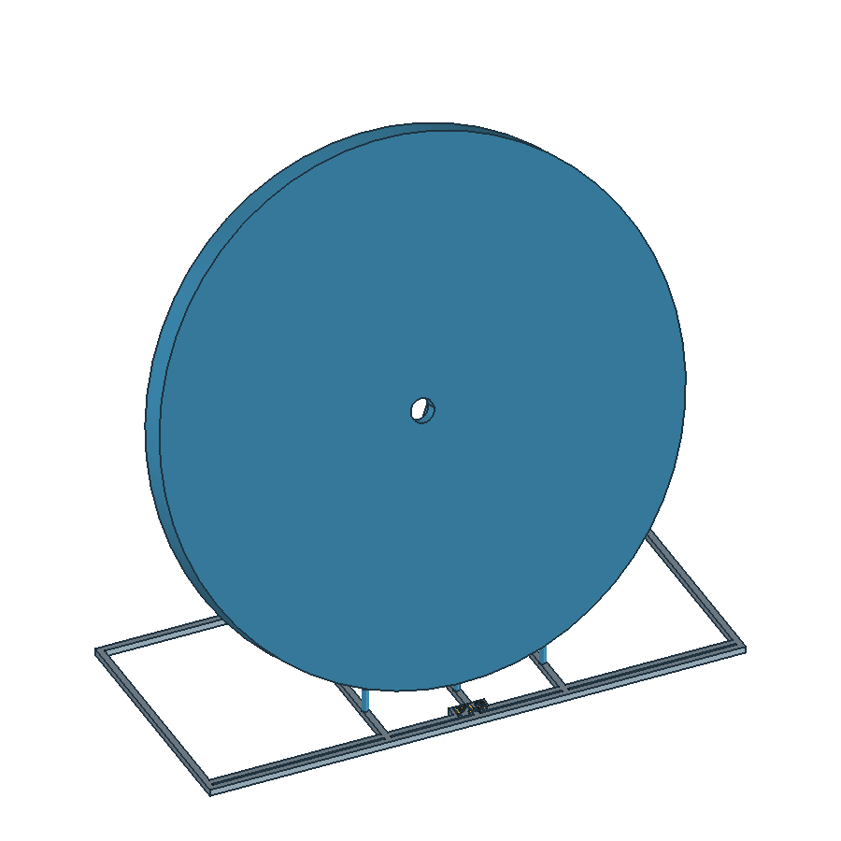
experiments/resin_sprues/previews/R12.png
