joezen777/physicssculptures/experiments/resin_sprues/previews/R13.png

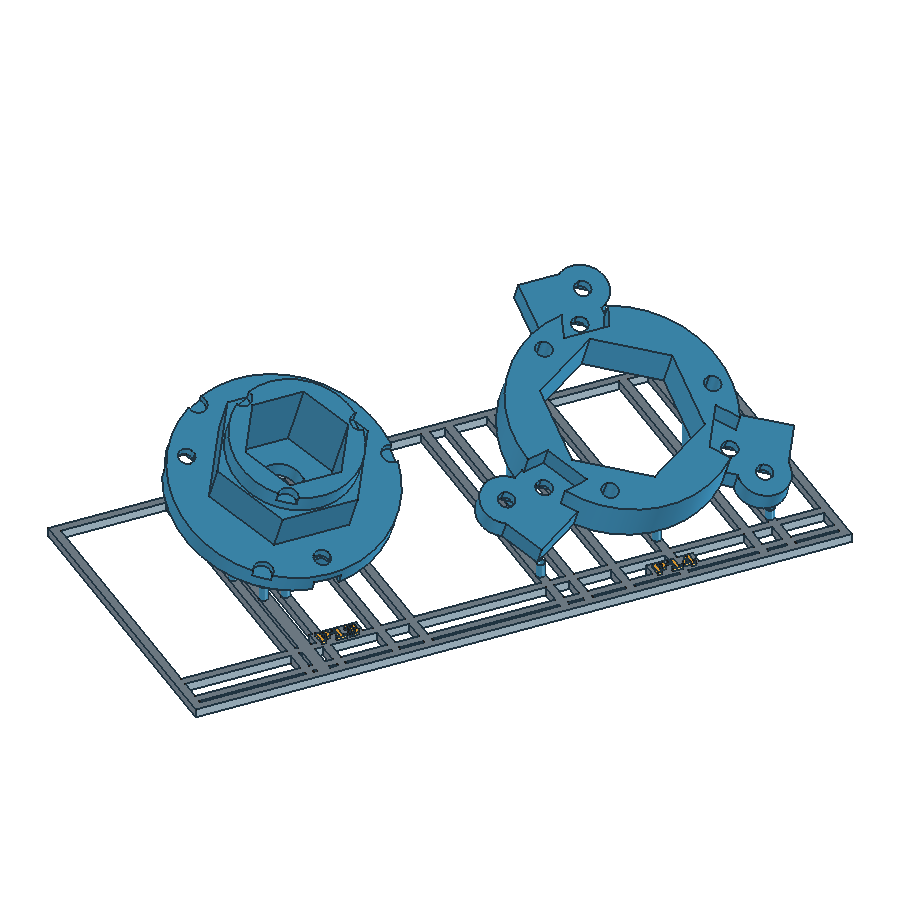
experiments/resin_sprues/previews/R13.png
