joezen777/physicssculptures/experiments/resin_sprues/previews/R14.png

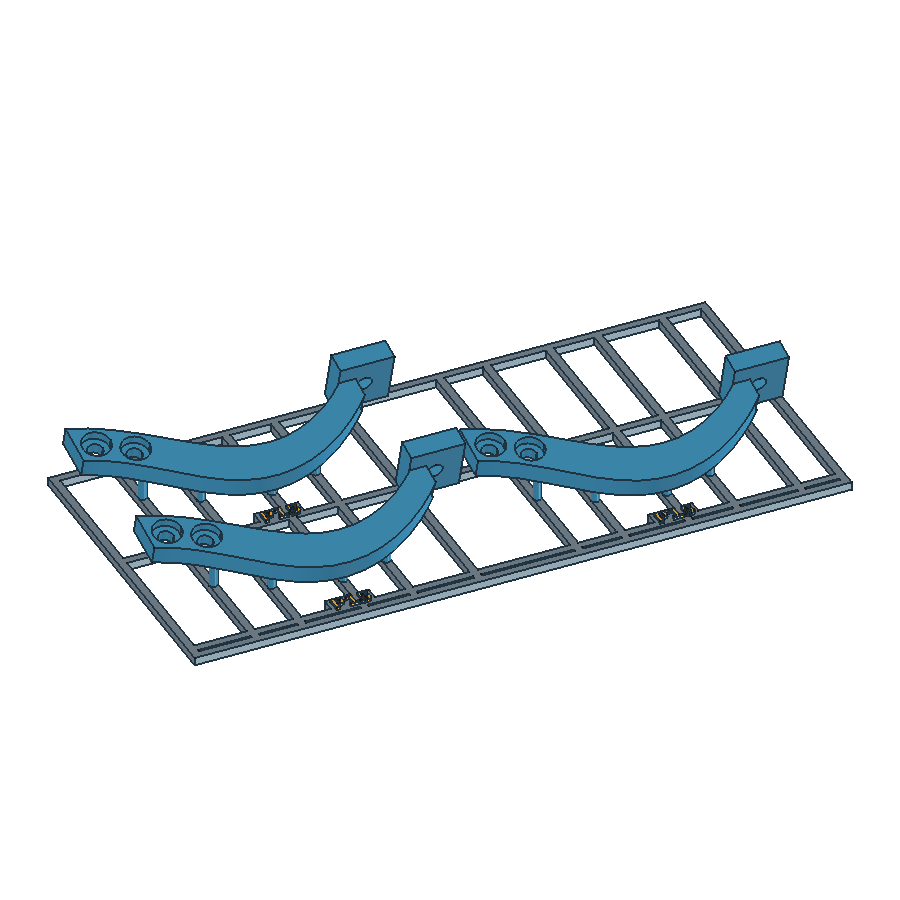
experiments/resin_sprues/previews/R14.png
