joezen777/physicssculptures/experiments/resin_sprues/previews/R15.png

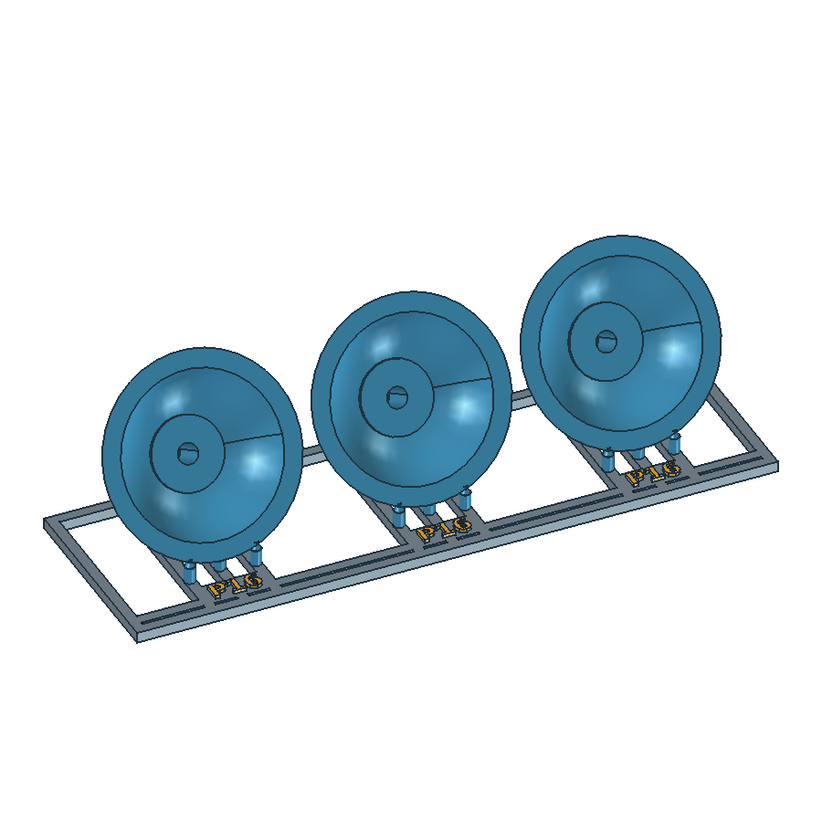
experiments/resin_sprues/previews/R15.png
