joezen777/physicssculptures/experiments/resin_sprues/previews/R16.png

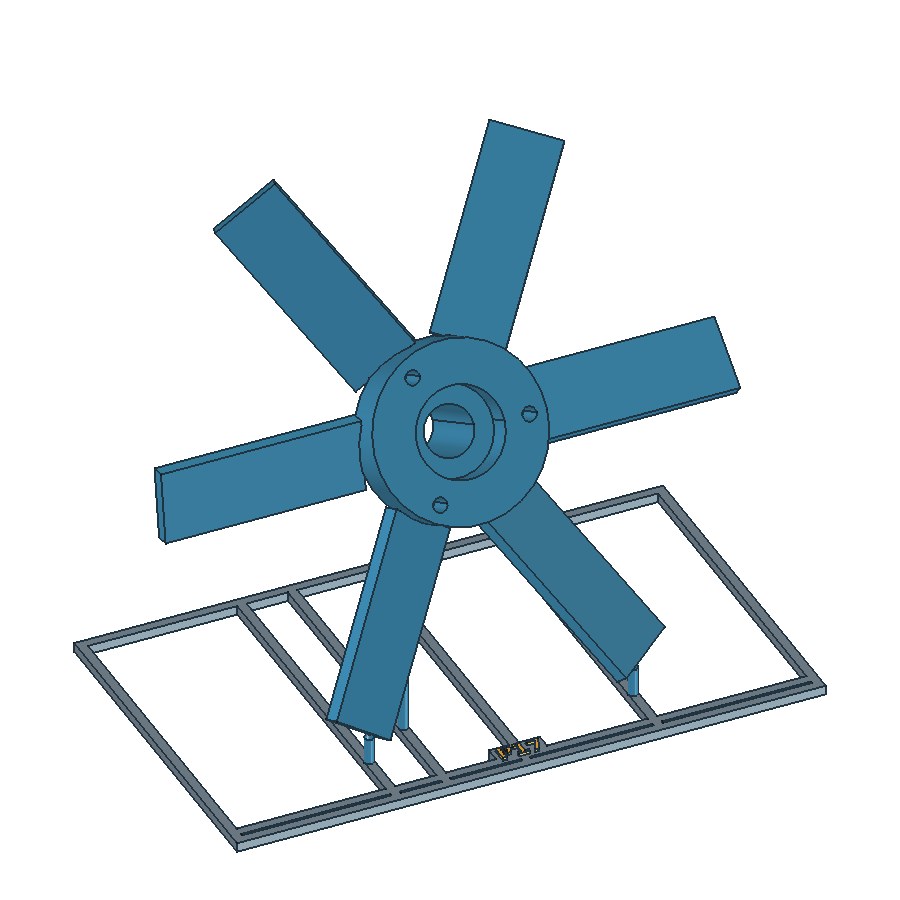
experiments/resin_sprues/previews/R16.png
