joezen777/physicssculptures/experiments/resin_sprues/previews/R17.png

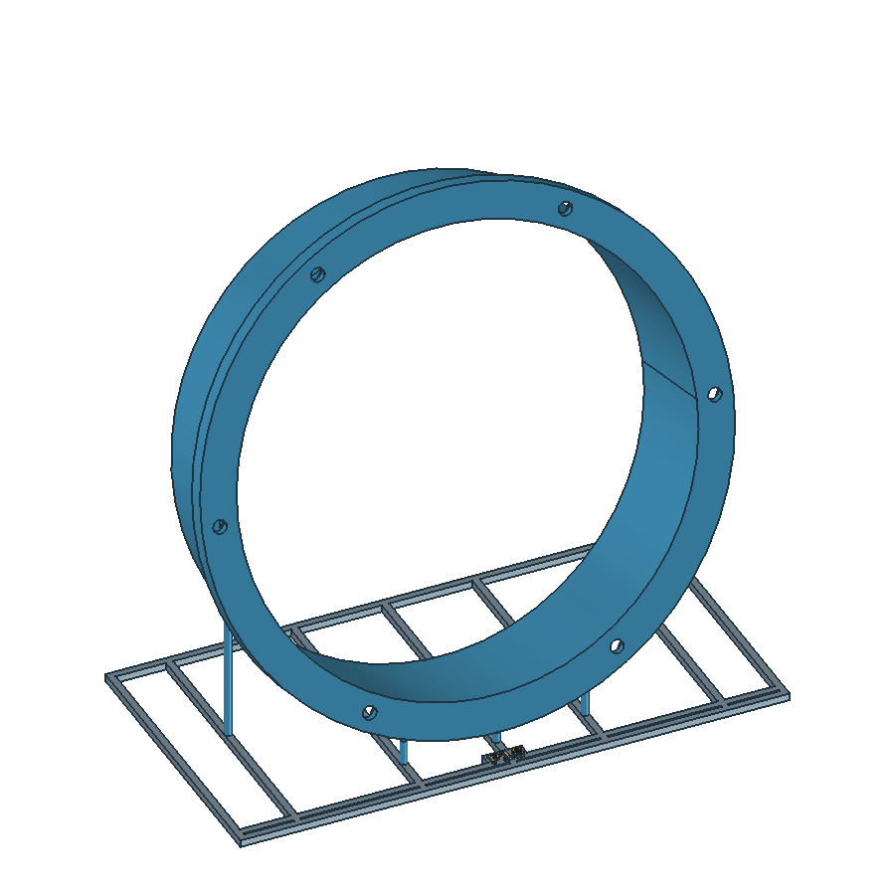
experiments/resin_sprues/previews/R17.png
