joezen777/physicssculptures/experiments/resin_sprues/previews/R18.png

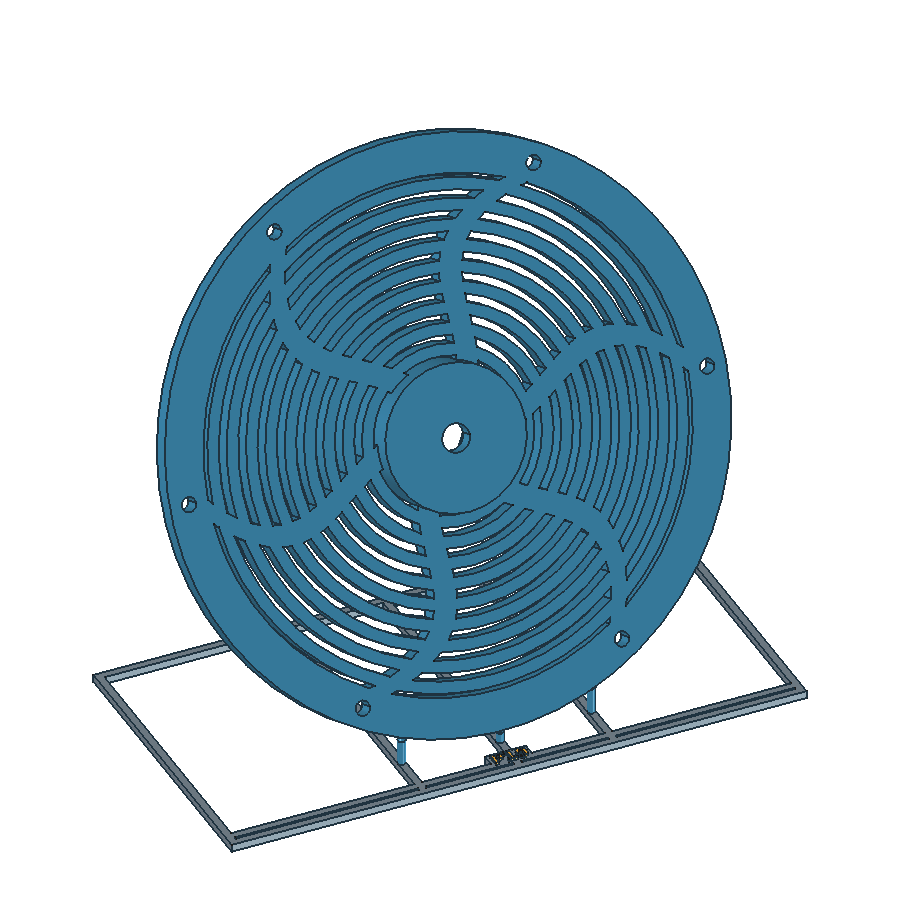
experiments/resin_sprues/previews/R18.png
