joezen777/physicssculptures/experiments/resin_sprues/previews/R19.png

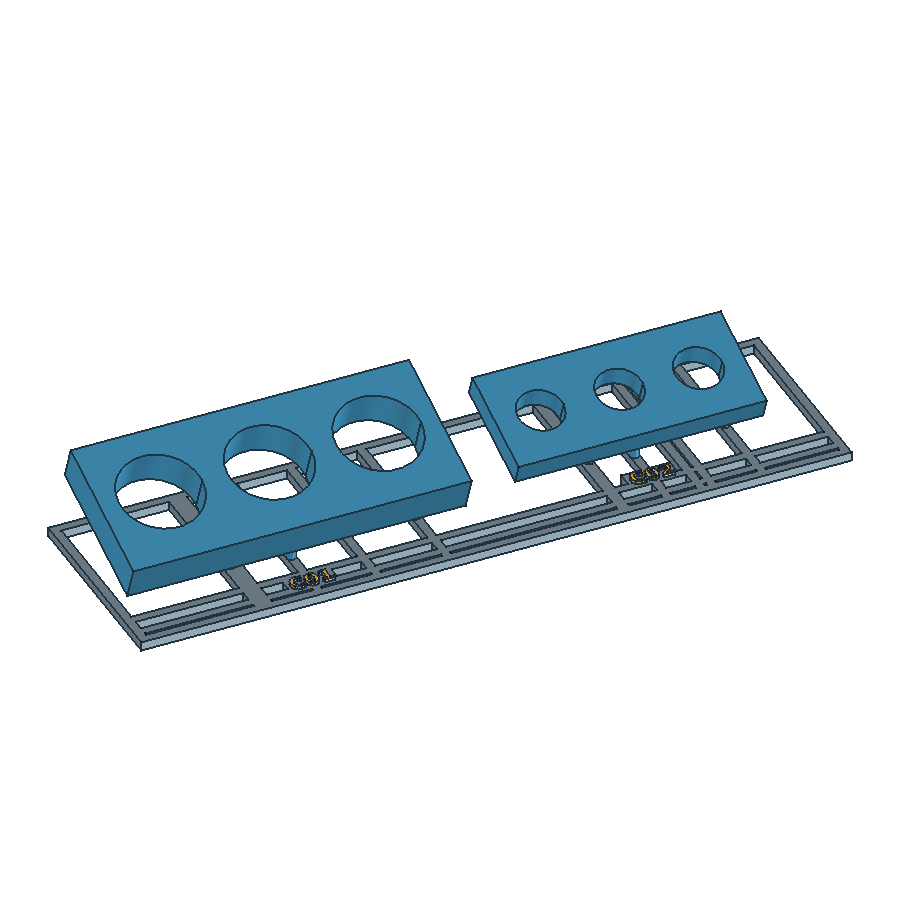
experiments/resin_sprues/previews/R19.png
