joezen777/physicssculptures/experiments/stacking_cones/output/annotated_tower.png

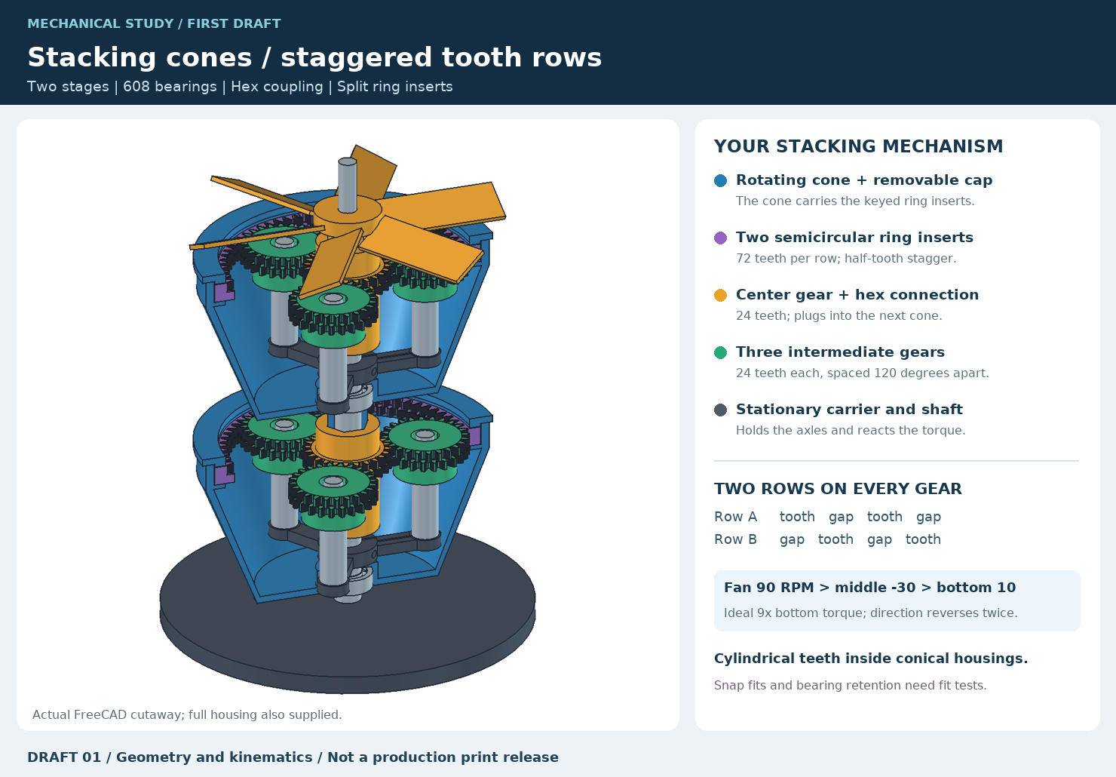
experiments/stacking_cones/output/annotated_tower.png
