joezen777/physicssculptures/experiments/print_petg_12/output/toroidal5_final/PETG_06nozzle_025layer_custom_supports.ini

# Geometry/toolpath inspection settings, not a calibrated printer profile.
nozzle_diameter = 0.6
filament_diameter = 1.75
layer_height = 0.25
first_layer_height = 0.25
extrusion_width = 0.66
external_perimeter_extrusion_width = 0.66
perimeter_extrusion_width = 0.66
first_layer_extrusion_width = 0.66
perimeters = 4
top_solid_layers = 5
bottom_solid_layers = 5
fill_density = 30%
fill_pattern = gyroid
perimeter_generator = arachne
bed_shape = 0x0,220x0,220x220,0x220
max_print_height = 250
brim_width = 0
skirts = 0
perimeter_speed = 25
external_perimeter_speed = 20
infill_speed = 35
solid_infill_speed = 25
top_solid_infill_speed = 20
first_layer_speed = 15
max_volumetric_speed = 6
filament_max_volumetric_speed = 6
support_material = 0
support_material_auto = 0
support_material_buildplate_only = 1
support_material_threshold = 45
support_material_contact_distance = 0.5
support_material_xy_spacing = 0.6
support_material_interface_layers = 2
support_material_spacing = 3
support_material_speed = 8
temperature = 240
first_layer_temperature = 240
bed_temperature = 80
first_layer_bed_temperature = 80
start_gcode =
end_gcode =
bridge_speed = 18
bridge_flow_ratio = 0.9
min_fan_speed = 25
max_fan_speed = 45
bridge_fan_speed = 70
disable_fan_first_layers = 3
threads = 4
