joezen777/physicssculptures/experiments/print_petg_12/output/p19_rain/PETG_02nozzle_012layer_supports.ini

# Geometry/toolpath inspection settings, not a calibrated printer profile.
nozzle_diameter = 0.2
filament_diameter = 1.75
layer_height = 0.12
first_layer_height = 0.16
extrusion_width = 0.22
external_perimeter_extrusion_width = 0.22
perimeter_extrusion_width = 0.22
first_layer_extrusion_width = 0.24
perimeters = 4
top_solid_layers = 8
bottom_solid_layers = 6
fill_density = 25%
fill_pattern = gyroid
perimeter_generator = arachne
bed_shape = 0x0,220x0,220x220,0x220
max_print_height = 250
brim_width = 4
skirts = 0
perimeter_speed = 20
external_perimeter_speed = 15
infill_speed = 25
solid_infill_speed = 20
top_solid_infill_speed = 15
first_layer_speed = 12
max_volumetric_speed = 2
filament_max_volumetric_speed = 2
support_material = 1
support_material_auto = 1
support_material_buildplate_only = 0
support_material_threshold = 45
support_material_contact_distance = 0.18
support_material_xy_spacing = 0.3
support_material_interface_layers = 2
support_material_spacing = 2
support_material_speed = 8
temperature = 240
first_layer_temperature = 240
bed_temperature = 80
first_layer_bed_temperature = 80
start_gcode =
end_gcode =
support_material_pattern = rectilinear
bridge_speed = 15
bridge_flow_ratio = 0.9
threads = 4
