joezen777/physicssculptures/(commit log)

2026-09-26 estimated-18000-tokens_Add finned falling-cylinder planetary CAD and physics study
    [drop_gearbox.FCStd, drop_gearbox_cutaway.step, drop_gearbox_full.step]
2026-09-26 estimated-7500-tokens_Add contactless magnetic gearbox concept and stage limits
    [magnetic.FCStd, magnetic_cutaway.step, magnetic_full.step]
2026-09-27 estimated-14000-tokens_Add staggered-tooth stacking cone tower FreeCAD draft
    [tower_cutaway.step, tower_draft.FCStd, tower_full.step]
2026-09-28 estimated-12000-tokens_Add repeating bevel cone turbine draft with fan inserts
    [bevel_cones.FCStd, bevel_cones_full.step]
2026-09-28 estimated-9500-tokens_Add roof-vent wind rotor to bottom-driven flowerpot multiplier
    [tower_cutaway.step, tower_draft.FCStd, tower_full.step]
2026-09-28 estimated-11000-tokens_Add four-level circular-sail tower with 2x stages and 608 mounts
    [tower_cutaway.step, tower_draft.FCStd, tower_full.step]
2026-09-29 estimated-18000-tokens_Add modular fan-floor pots with removable wind sails and auto-close builds
    [tower_cutaway.FCStd, tower_cutaway.step, tower_draft.FCStd, tower_full.step, tower_without_sails.step]
2026-09-29 estimated-9000-tokens_Use 604 planets and curved arms with concentric top guard
    [tower_cutaway.FCStd, tower_cutaway.step, tower_draft.FCStd, tower_full.step, tower_without_sails.step]
2026-09-29 estimated-2300-tokens_Document linear assembly order for modular fan tunnel
2026-10-02 estimated-35000-tokens_Create PETG 1.2mm print kit with accessible bearings and exploded assembly guide
    [C01_608_fit_coupon_print-1x.stl, C02_604_fit_coupon_print-1x.stl, P01_608_retainer_print-8x.stl, P02_pot_fan_A_print-2x.stl, P03_pot_fan_B_print-1x.stl, P04_fixed_curved_carrier_print-3x.stl, P05_sun_lower_bearing_housing_print-3x.stl, P06_sun_36T_socket_print-3x.stl]
2026-10-02 estimated-15000-tokens_Show every purchased part in exploded assembly and joint details
    [exploded_assembly.FCStd, print_prototype.FCStd]
2026-10-02 estimated-22000-tokens_Create resin sprue sheets with raised 12-point part labels
    [R01_608_retainers_print-1x.stl, R02_pot_fan_A_print-2x.stl, R03_pot_fan_B_print-1x.stl, R04_fixed_carrier_print-3x.stl, R05_lower_sun_housings_print-1x.stl, R06_sun_socket_print-3x.stl, R07_planet_gears_print-1x.stl, R08_604_retainers_print-1x.stl]
2026-10-03 estimated-30000-tokens_Create labeled hardware resin sprues with modeled threads
    [H00_thread_fit_test_print-1x.stl, H01_M2p5x16_screws_print-3x.stl, H02_M3x16_screws_print-3x.stl, H03_M3x20_screws_print-1x.stl, H04_M4x20_screws_print-3x.stl, H05_M4x10_button_screws_print-1x.stl, H06_M4x25_screws_print-1x.stl, H07_M4x16_screws_print-1x.stl]
2026-10-03 estimated-8000-tokens_Add dovetail joints to split printed assemblies and refresh exports
    [P02_pot_fan_A_print-2x.stl, P03_pot_fan_B_print-1x.stl, P05_sun_lower_bearing_housing_print-3x.stl, P06_sun_36T_socket_print-3x.stl, P09_72T_ring_half_print-6x.stl, P10_interstage_air_collar_print-2x.stl, P11_terminal_air_collar_print-1x.stl, P13_base_drive_adapter_print-1x.stl]
2026-10-03 estimated-18000-tokens_Engrave loose P02 and P03 pots and remove mistaken plastic sprues
    [P02_pot_fan_A_print-2x.stl, P03_pot_fan_B_print-1x.stl, R01_608_retainers_print-1x.stl, R02_pot_fan_A_print-2x.stl, R03_pot_fan_B_print-1x.stl, R04_fixed_carrier_print-3x.stl, R05_lower_sun_housings_print-1x.stl, R06_sun_socket_print-3x.stl]
2026-10-06 estimated-4500-tokens_Illustrate bearing spacer contact and turbine motion
2026-10-10 estimated-120000-tokens_Replace staggered planetary gears with one-piece helical set for 0.4 mm nozzle
    The staggered two-row teeth could not be assembled axially: a planet lowered
    onto the sun collided at every rotation (>=23.7 mm3 CAD overlap), so planets
    seated one row out of phase. Replace them with single-row 15 degree helical
    gears (module 2, 72/36/18, same 54 mm center distance and -2 ratio) with full
    addenda for a 0.4 mm nozzle, and make the P09 ring a single 192 mm print.
    Only P06, P07 and P09 change; other STLs, the BOM and interfaces are
    unchanged. validate.py now checks axial gear insertion along the helix.
    The slicer check uses a 0.4 mm profile; all 21 STLs pass. Docs explain wh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
    [P06_sun_36T_helical_socket_print-3x.stl, P06_sun_36T_socket_print-3x.stl, P07_planet_18T_604_print-9x.stl, P07_planet_18T_helical_604_print-9x.stl, P09_72T_helical_ring_print-3x.stl, P09_72T_ring_half_print-6x.stl, exploded_assembly.FCStd, print_manifest.csv]
2026-10-10 estimated-3000-tokens_Remove incorrect resin sprue staleness notes
    Only hardware is sprued; gear and body parts have no sprue sheets to rebuild.
2026-10-12 estimated-4000-tokens_Pin sail 0.2 mm slice profile values after 0.4 mm base merge
    finish_sail_80x120.py derived its profile by string-replacing 1.2 mm values in
    slicer_check.ini; with the merged 0.4 mm base it would have produced a 0.12 mm
    nozzle. Overrides are now explicit and reproduce the committed profile exactly.
2026-10-12 estimated-9000-tokens_Check 80x120 sail parts against 0.4 mm nozzle profile
    finish_sail_80x120.py now slices P15/P16 with the shared 0.4 mm inspection
    profile (supports allowed on the part) instead of a 0.2 mm one. Thinnest
    features are 2.7 mm cheeks and a 3.2 mm shell; both parts slice with no
    warnings at full height. Geometry and STLs unchanged.
2026-10-12 estimated-1500-tokens_Refresh sail print kit ZIP with 0.4 mm profile and README
2026-10-19 estimated-9000-tokens_Add explicit 400 RPM OpenFOAM comparison cases
    [original.stl, scimitar.stl, toroidal5.FCStd, toroidal5.stl, tubercled.FCStd, tubercled.stl]
2026-10-19 estimated-6500-tokens_Record failed steady convergence and add bounded transient RPM sweep
    [original_coarse_flow.csv, original_coarse_torque.csv, original_fine_flow.csv, original_fine_torque.csv, scimitar_coarse_flow.csv, scimitar_coarse_torque.csv, toroidal5_coarse_flow.csv, toroidal5_coarse_torque.csv]
